jaeinCha/ECEN404-2025SP-TI-Solar-Battery-Pack/Slides/ECEN 404 Final Presentation.pdf

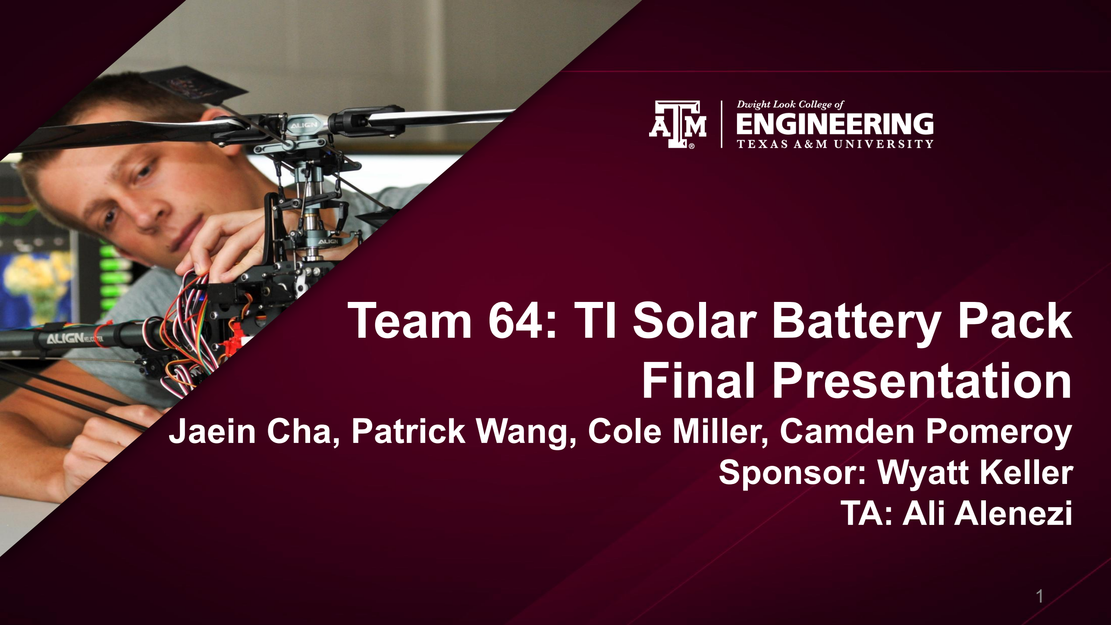
[picture p52: page 1]

# Team 64: TI Solar Battery Pack Final Presentation

### Jaein Cha, Patrick Wang, Cole Miller, Camden Pomeroy

### Sponsor: Wyatt Keller TA: Ali Alenezi

# Project Summary

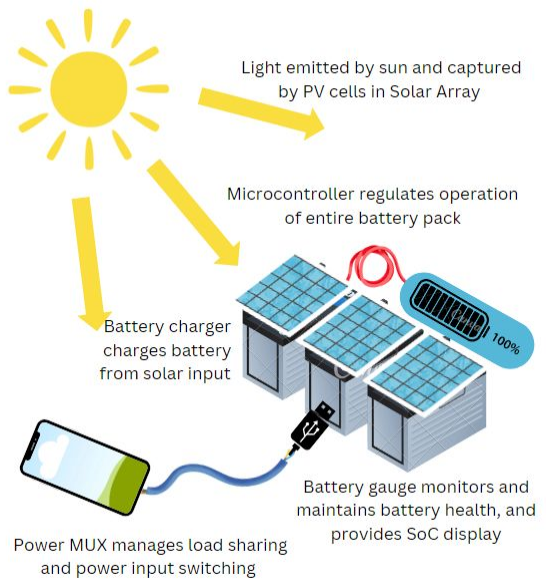
[picture p53: figure]

- Natural disasters, camping, or remote backpacking may result in a scenario with the inability to charge cell phones and other necessary small electronic devices.
- A solution is to create a solar powered battery pack that charges itself from solar panels, and distributes the power to electronic devices through a USB connection.

# Subsystem Overview

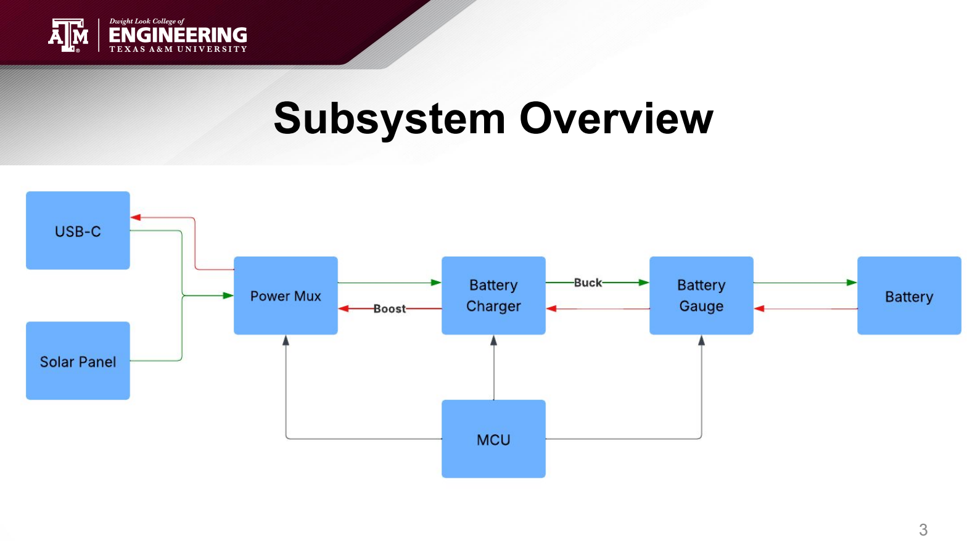
[picture p54: page 3]

# Integrated System Design

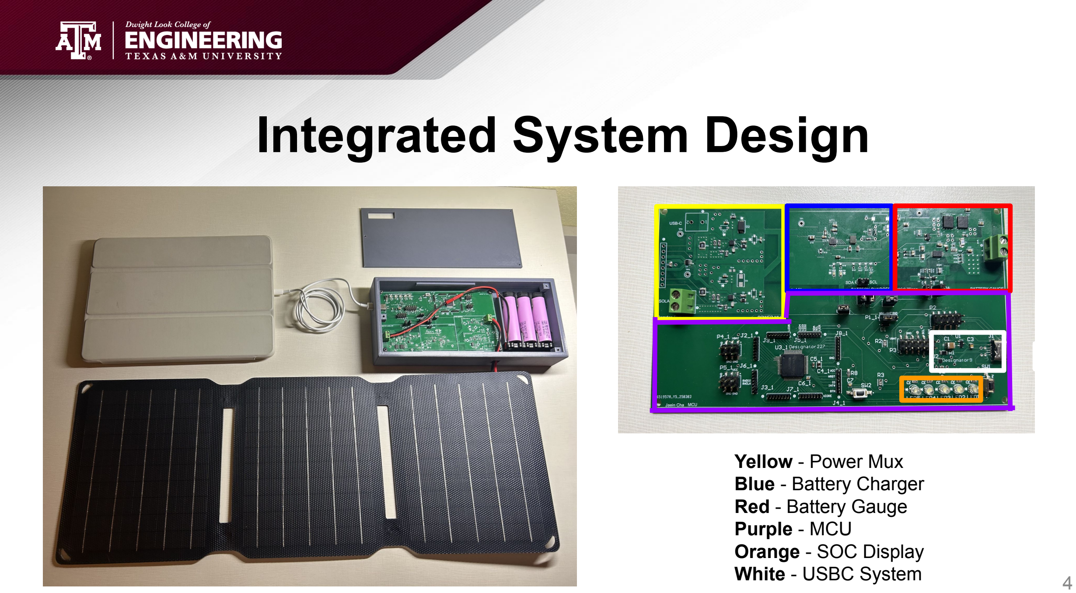
[picture p55: page 4]

4

Yellow - Power Mux
Blue - Battery Charger
Red - Battery Gauge
Purple - MCU
Orange - SOC Display
White - USBC System

# USB-C Input

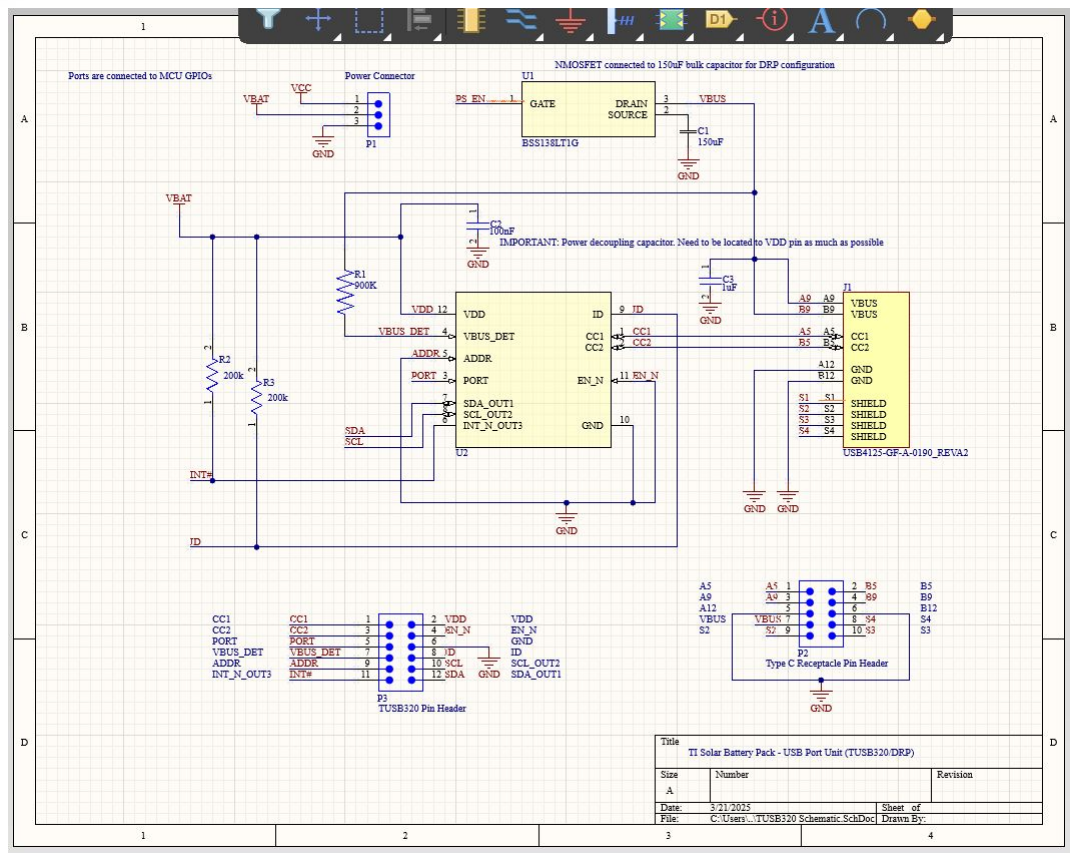
[picture p56: figure]

### - USB-C logic controlled by TUSB320

### - Configured as a DRP in I2C mode

### - Validated to source and sink devices and control VBUS

# USB-C Input

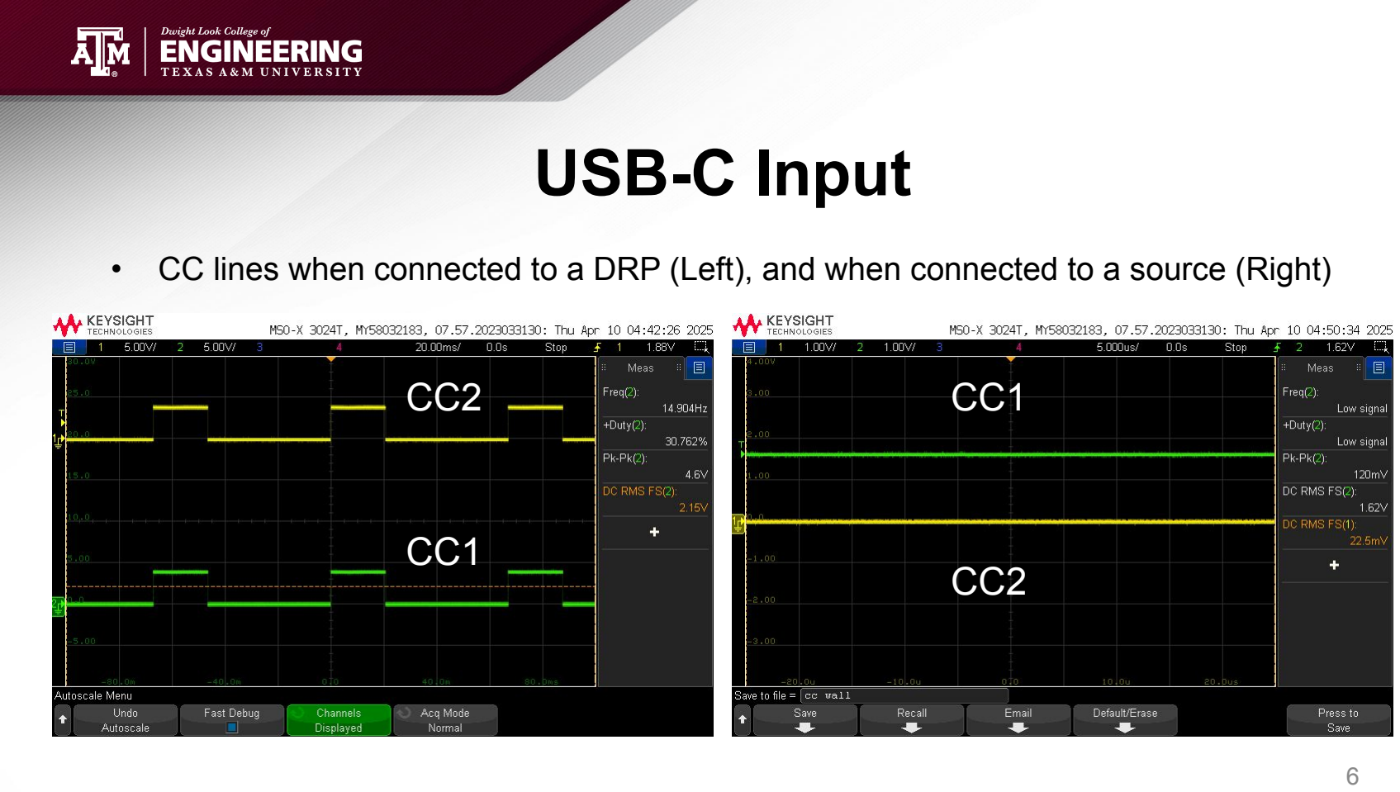
[picture p57: page 6]

- CC lines when connected to a DRP (Left), and when connected to a source (Right)

CC2

CC1

CC1

CC2

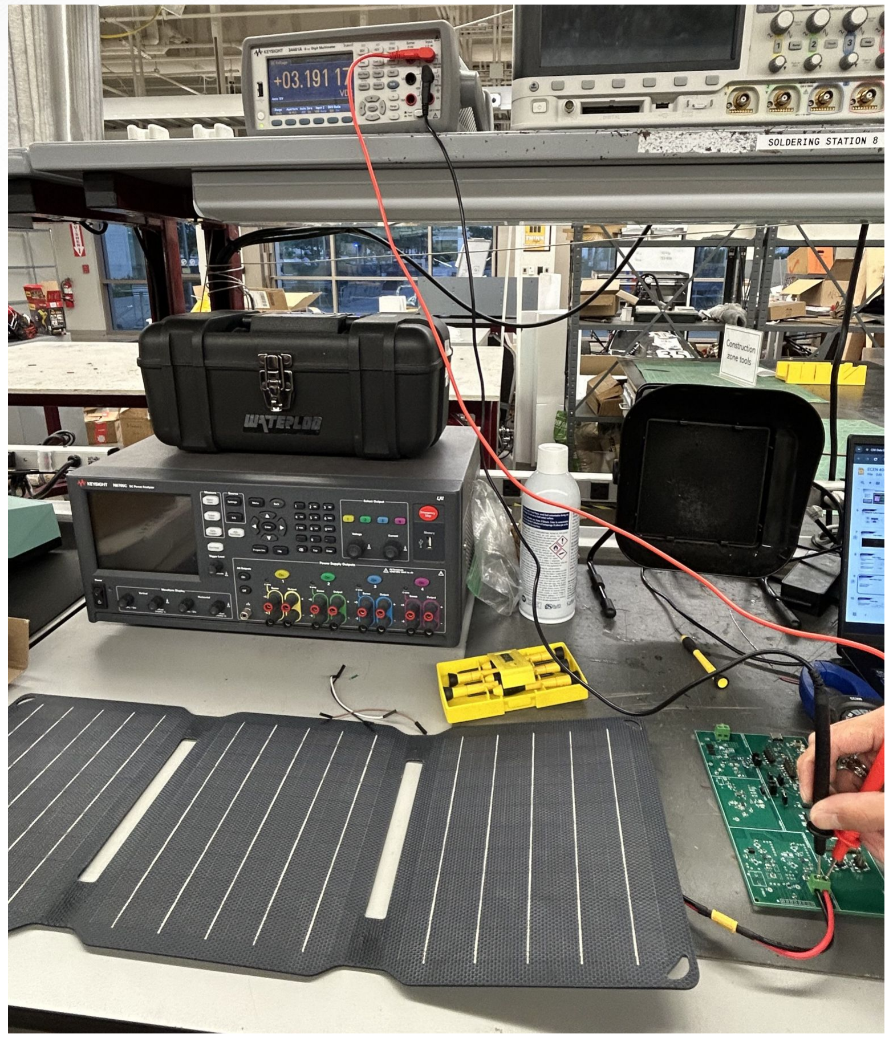
[picture p58: figure]

Solar Panel Input • 2.5V to 7.5V output at 15W

across three foldable
lightweight panels
- On a standard sunny day
charges at 7V 2A on
average
- Cloudy day 7V at 0.5A

# Power Mux - Camden Pomeroy

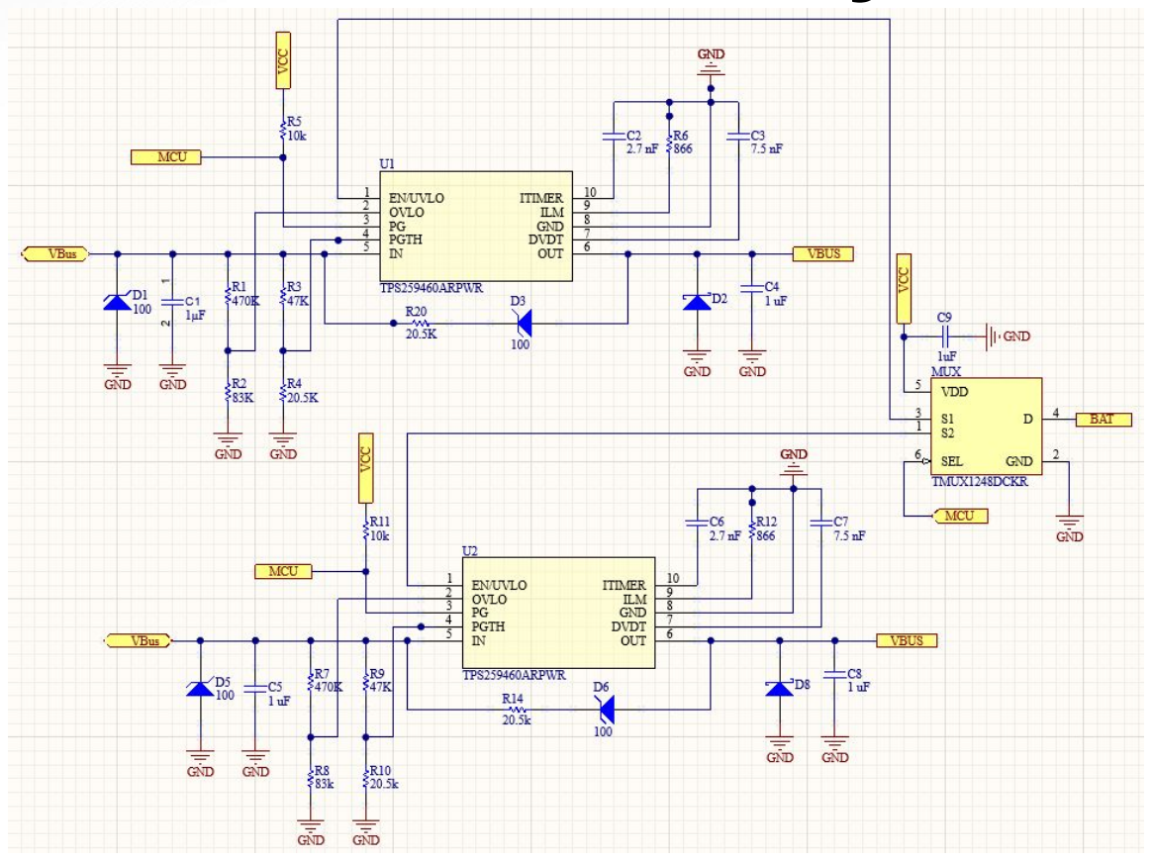
[picture p59: figure]

- Ensures protection of
system when both USB-C
and Solar inputs are
connected
- Utilizes break before make switching
- UV/OV Shutoff Protection with Auto Retry
- MCU reading good input
power detection and control over enabling power paths

- High heat from high current paths
– Created larger polygon pours and more stitching vias to boost efficiency
- Two loads would connect to VBUS at once sometimes
– Increased MUX capacitor and redesigned drain and VDD pins
- UV/OV would trigger during expected operation
– Gave a larger margin of error to account for MPPT of the solar panel on ideal and non-ideal days
- Powerflow only in one direction
– Redesigned schematic to bias the IN side of the eFuse which allowed for
Power to now flow from OUT to IN | 9

# Power Mux - Challenges and Solutions

# Power Mux

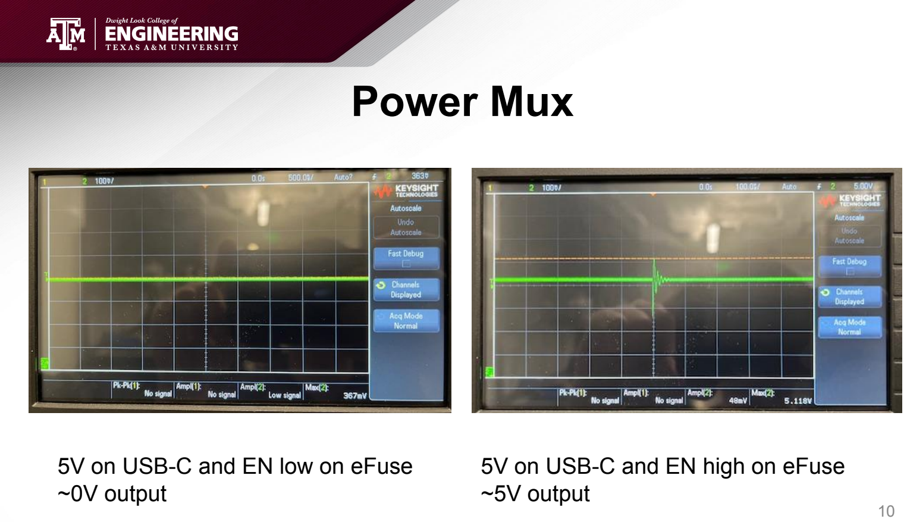
[picture p60: page 10]

5V on USB-C and EN high on eFuse ~5V output

5V on USB-C and EN low on eFuse ~0V output

# Battery Charger - Cole Miller

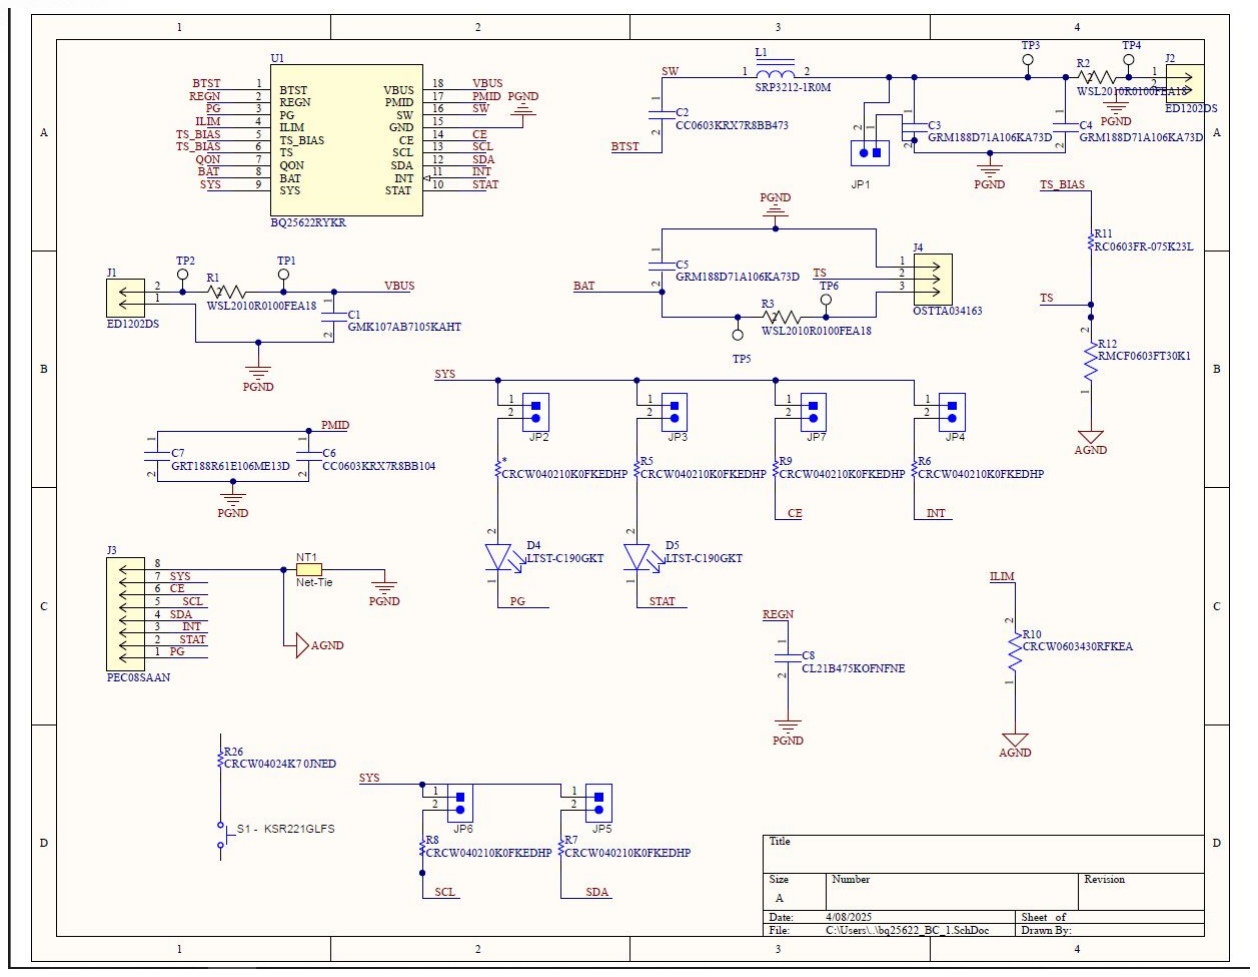
[picture p61: figure]

- Utilizes a BQ25622
- While charging battery
acts as a buck converter
- While charging Devices
acts as a boost converter
- Controls current and
voltage

# Battery Charger - Buck

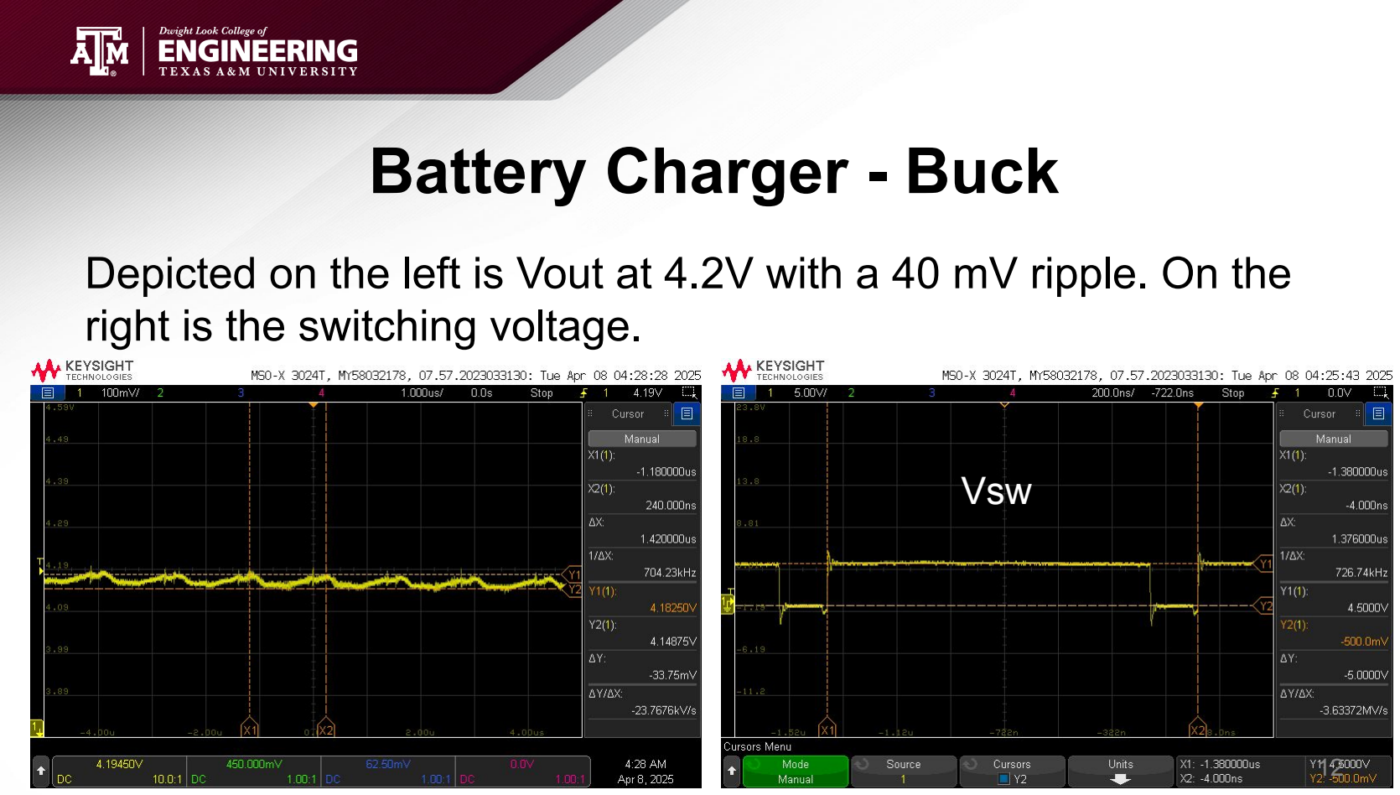
[picture p62: page 12]

### Depicted on the left is Vout at 4.2V with a 40 mV ripple. On the

right is the switching voltage.

Vout

Vsw

# Battery Charger - Boost

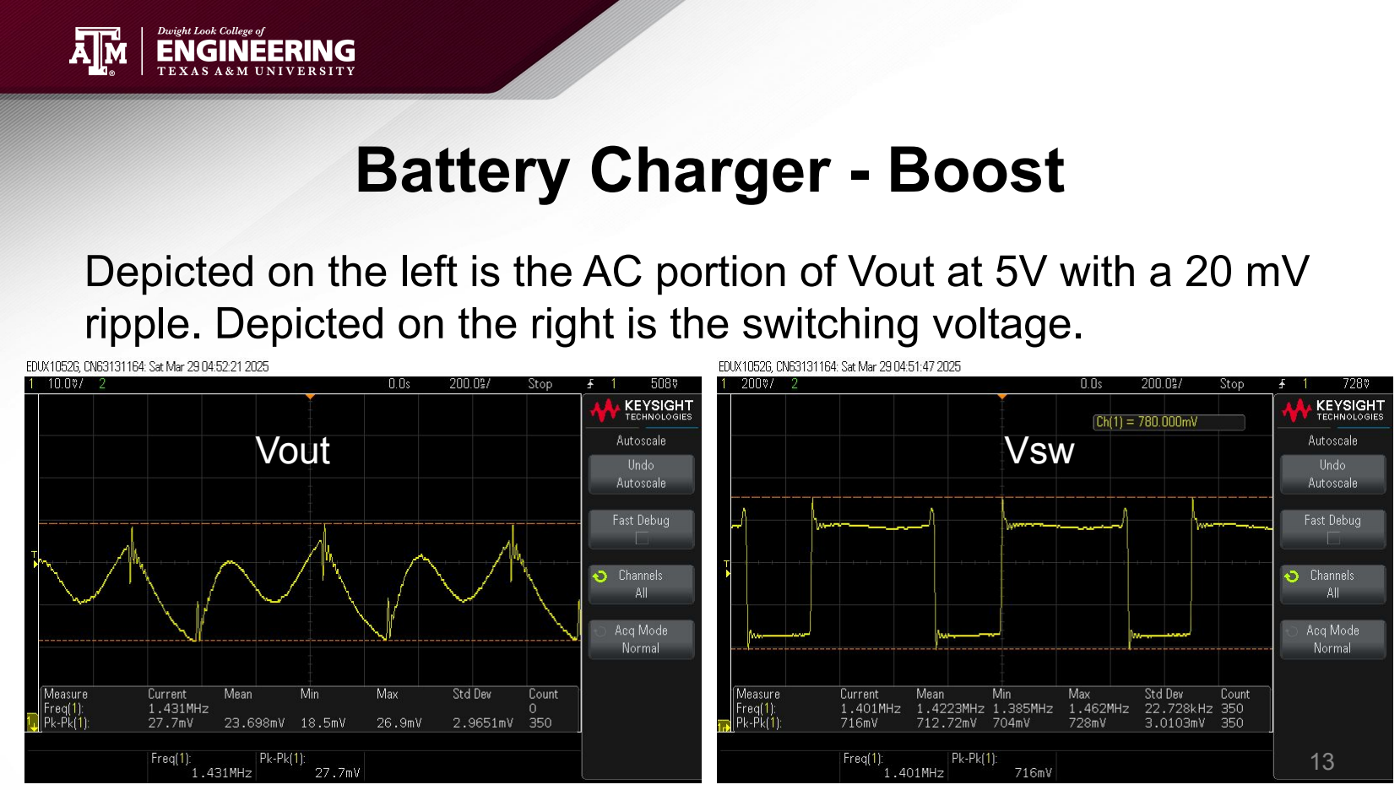
[picture p63: page 13]

### Depicted on the left is the AC portion of Vout at 5V with a 20 mV

ripple. Depicted on the right is the switching voltage.

Vout | Vsw

# Battery Charger - Efficiency

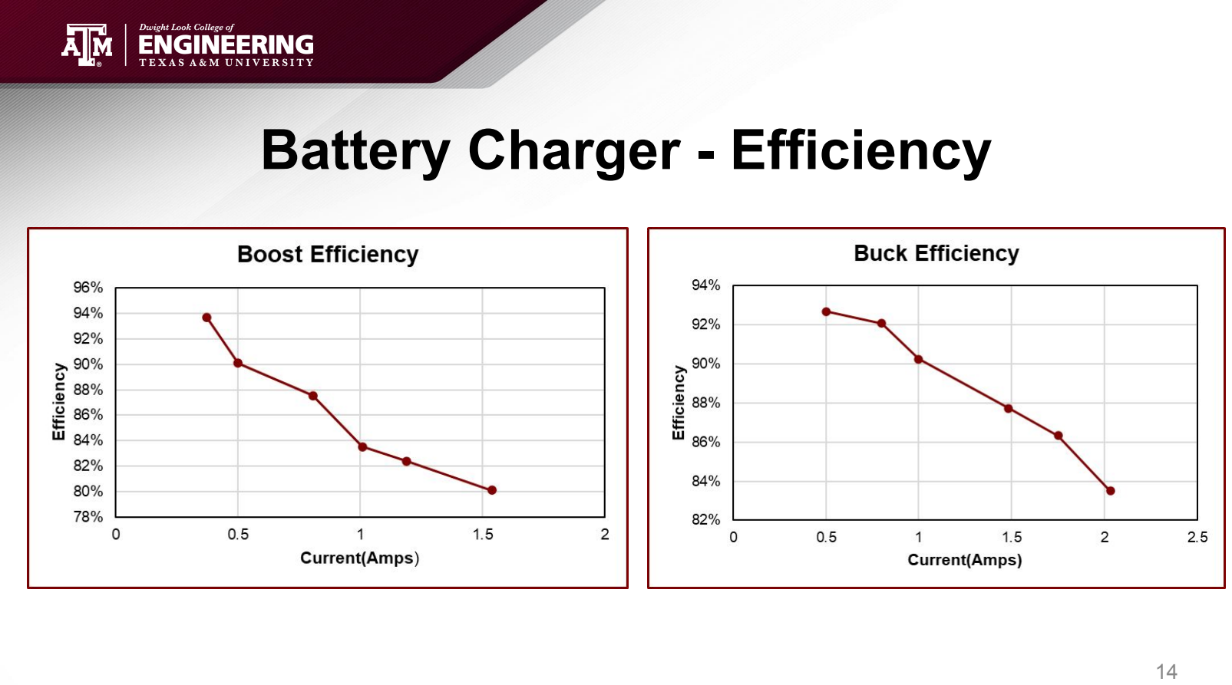
[picture p64: page 14]

- High heat from high current paths
– Created larger polygon pours and more stitching vias to boost efficiency
- Gate drivers wouldn’t allow full voltage
– Replaced ICs and changed soldering technique
- Lossy components due to ESR
– Utilized ceramic capacitors and low ESR inductors
- Lack of knowledge on DC - DC converters
– Utilized TI documents and forums to gain knowledge about package and operation

## Battery Charger - Challenges and Solutions

# Battery Gauge - Patrick Wang

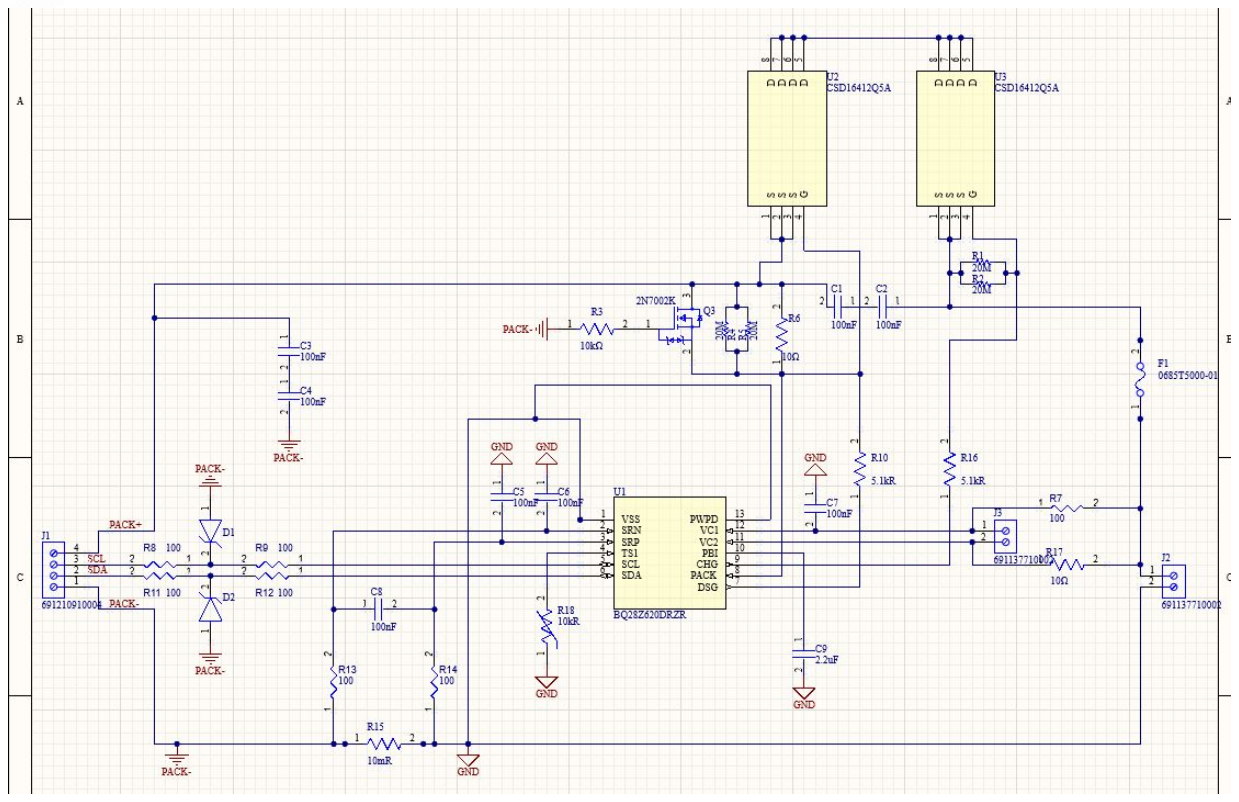
[picture p65: figure]

Overview
- Monitors voltage, current, temperature, and calculates state-of-charge (SOC) for Li-ion pack
- Configurable overvoltage (OV) and undervoltage (UV) thresholds to protect against faults
- Triggers fault flags (e.g., OV/UV, overcurrent) in registers
Challenges in 404
- Calibration of gauge to read proper charging parameters
- Extracting full charge cycle and discharge cycle data in one sitting

# Battery Gauge Operation

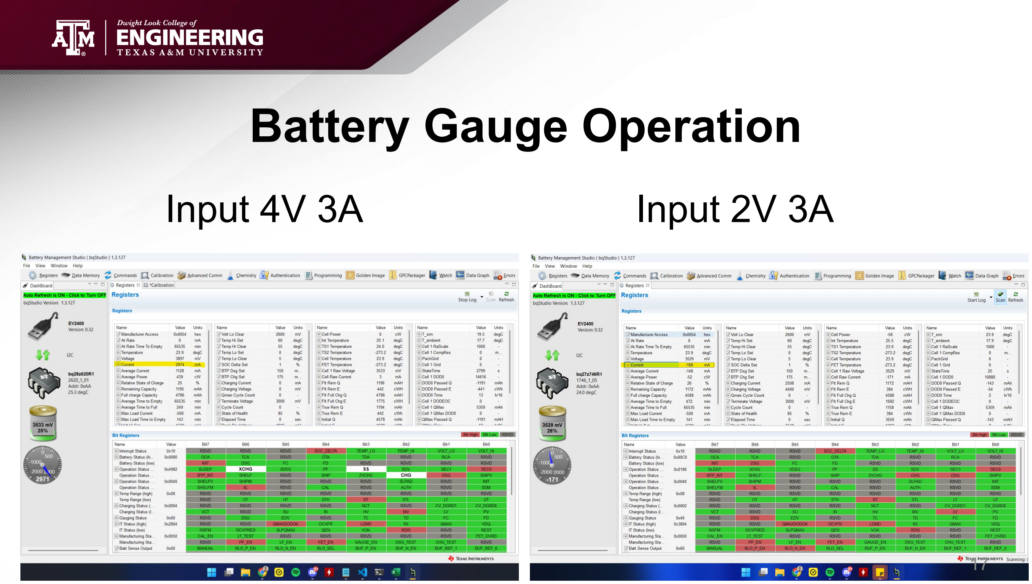
[picture p66: page 17]

Input 4V 3A | Input 2V 3A

# Battery Pack (charging)

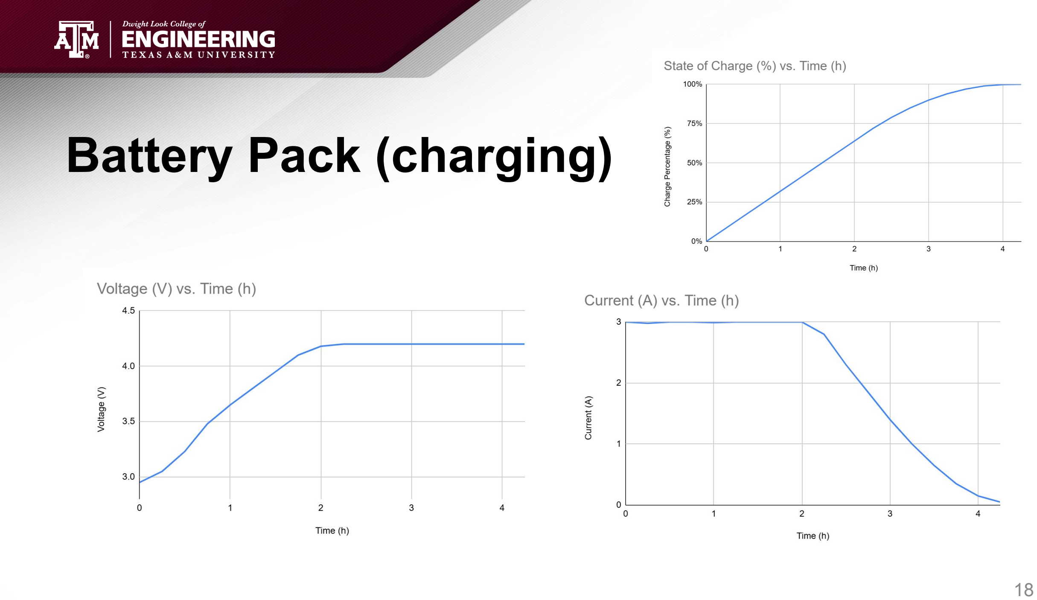
[picture p67: page 18]

## Battery Pack (discharging)

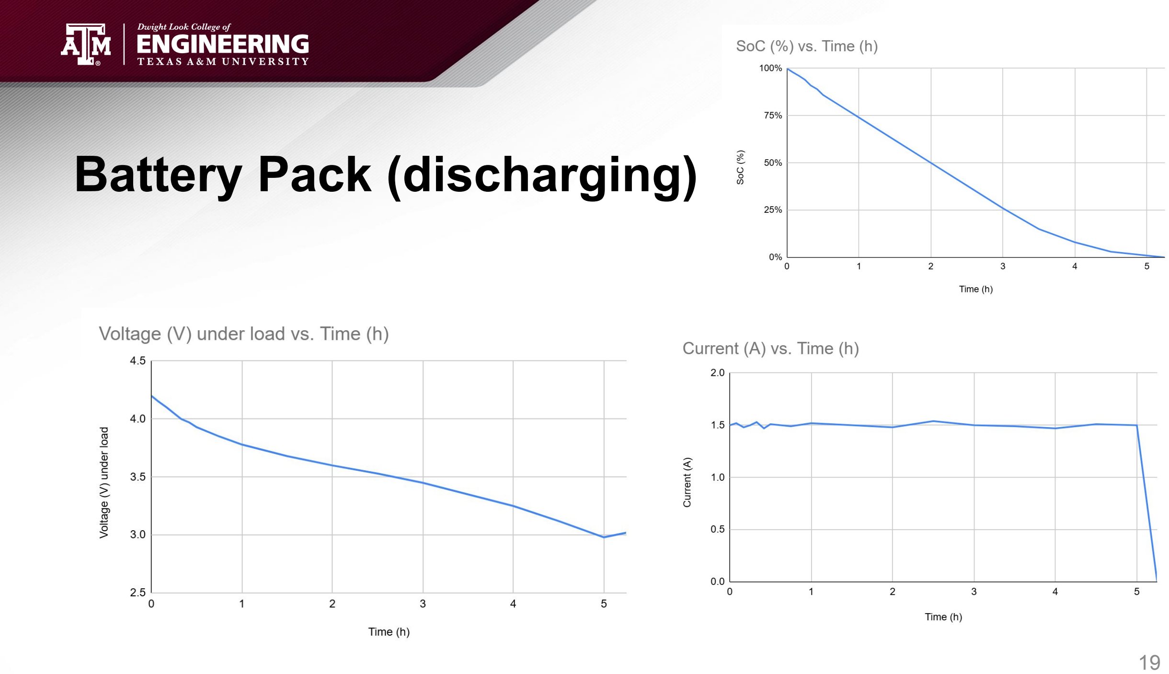
[picture p68: page 19]

# MCU - Jaein Cha

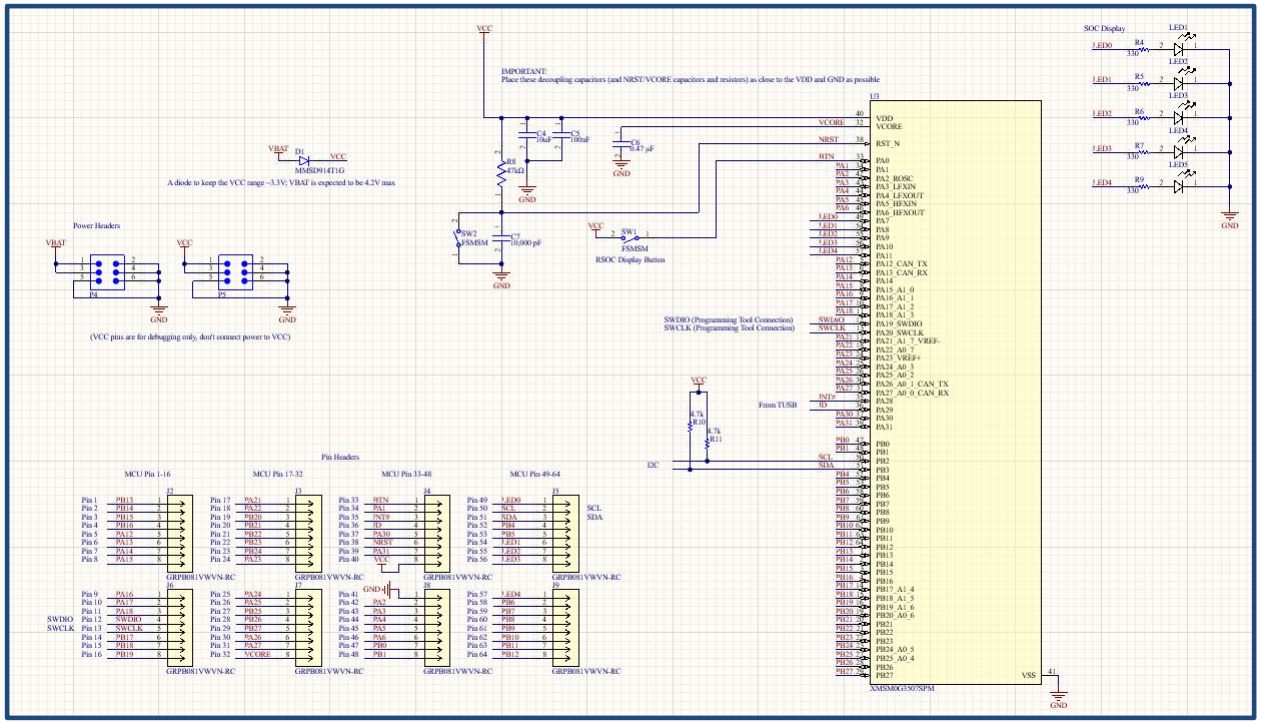
[picture p69: figure]

- Control unit -
integrates subsystems and firmware into one organized system
- MSPM0G3507 (LQFP 64 pin)
- I2C Communication Inter-Integrated Circuit
– Read/write register values for subsystem control
- MPPT Maximum Power Point Tracking
– To maximize power from
solar panel
- SOC display and SOC wake button

SOC: State of Charge

# MCU Firmware Flow Chart

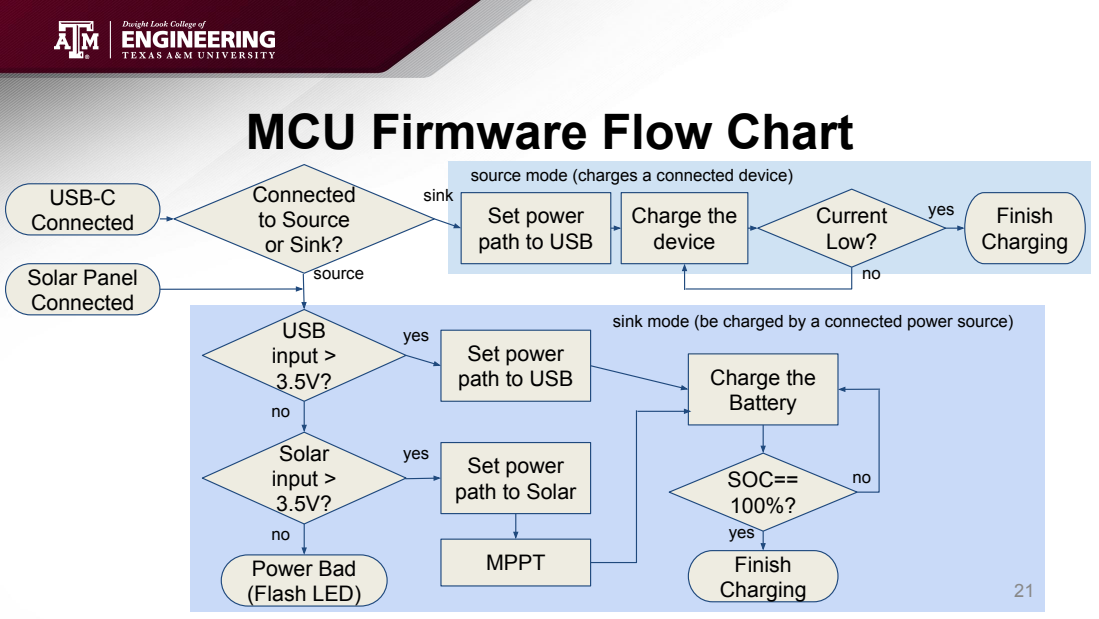
[picture p70: page 21]
USB-C Connected; Solar Panel Connected; Connected to Source or Sink?; Charge the device; source; USB input > 3.5V?; Solar input > 3.5V?; yes; Current Low?; Finish Charging; Set power; Power Bad (Flash LED); Charge the Battery; MPPT; SOC== 100%?

source mode (charges a connected device)
sink

Set power
path to USB

sink mode (be charged by a connected power source)

yes
path to Solar

# MCU Firmware Flow Chart

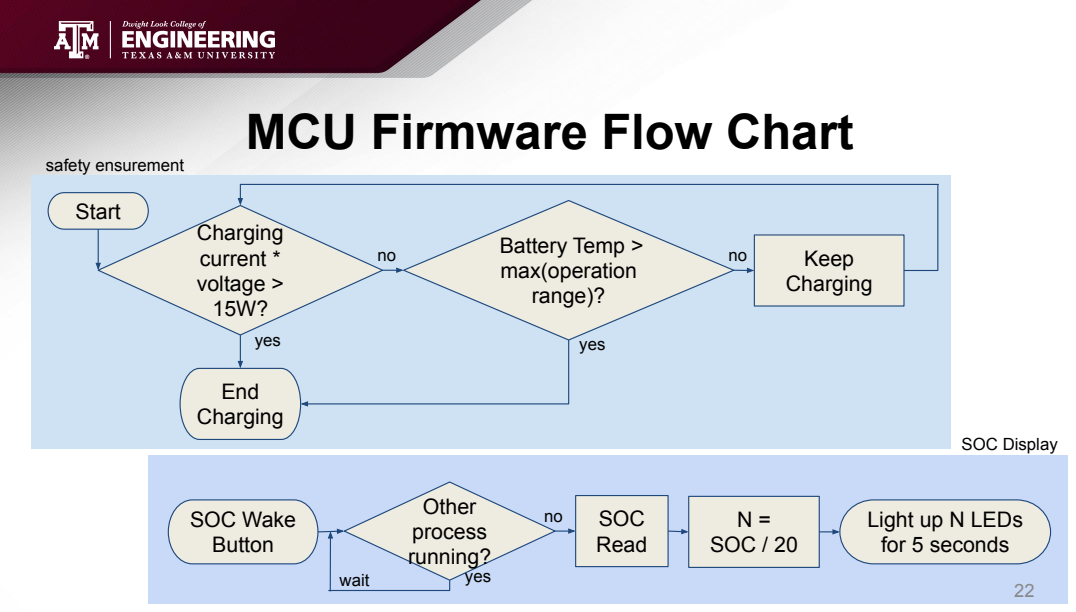
[picture p71: page 22]
Charging current * voltage > 15W?; safety ensurement; SOC Display; Battery Temp > max(operation range)?; End Charging; Keep Charging; yes; Other process running?; SOC Wake Button; SOC Read; N = SOC / 20; wait; Start

Light up N LEDs
for 5 seconds

- Inefficient process between firmware testing and on-board testing due to different package/pin configurations
– Changed on-board MCU package to match with the one on the launchpad
- Firmware consists of different functionalities
– Splitted firmware source code into various scripts, and assembled its functionality in the main.c file
- Complex to test due to its various functionalities
– Tested each functionality separately prior to the integrated testing, checking the lists of interrupts and their priorities

# MCU - Challenges and Solutions

# System Summary

Device | Charge Time
USB-C (5V 3A) | 2 hrs 45 min
Solar Sunny (7V 2A) | 3 hr
Solar Cloudy (7V 0.5A) | 10 hrs 30 min
Mode | Current | Discharge Time
USB 2.0 | 0.5 A | 16 hr 40 min
USB 3.0 / 3.1 | 0.9 A | 9 hr
USB BC 1.2 | 1.5 A | 5 hr 15 min
USB-C Default | 3 A | 2 hr 30 min
- Batteries will last 16450 hours or about 685 days when device is idle in sleep mode
System Operating Mode | Current Consumption
Normal | 1.2795 mA
Sleep | 547.1 μA
Off | 2.1 μA

# System Summary

Device | Battery Capacity (mAh) | Amount of Full Charges
iPhone 13/14/15 | ~ 3300 | 2.2
Google Pixel 5/6/7 | ~ 4335 | 1.65
Samsung Galaxy S23 | ~ 5124 | 1.85
AirPods Pro | ~ 520 | 13.85
Nintendo Switch | ~ 4310 | 1.67
Portable Fan / USB Light | ~ 1200 | 6
GoPro Hero 10/11/12 | ~ 1720 | 4.2

# Changes Since 403

- Integrated all individual subsystems together into one board
- Integrated new usb subsystem for input/output charging
- Changed MCU Package from VSSOP (28 Pin) to LQFP (64 Pin)
- Modified layout for battery gauge to reduce size

# System Validation Plan

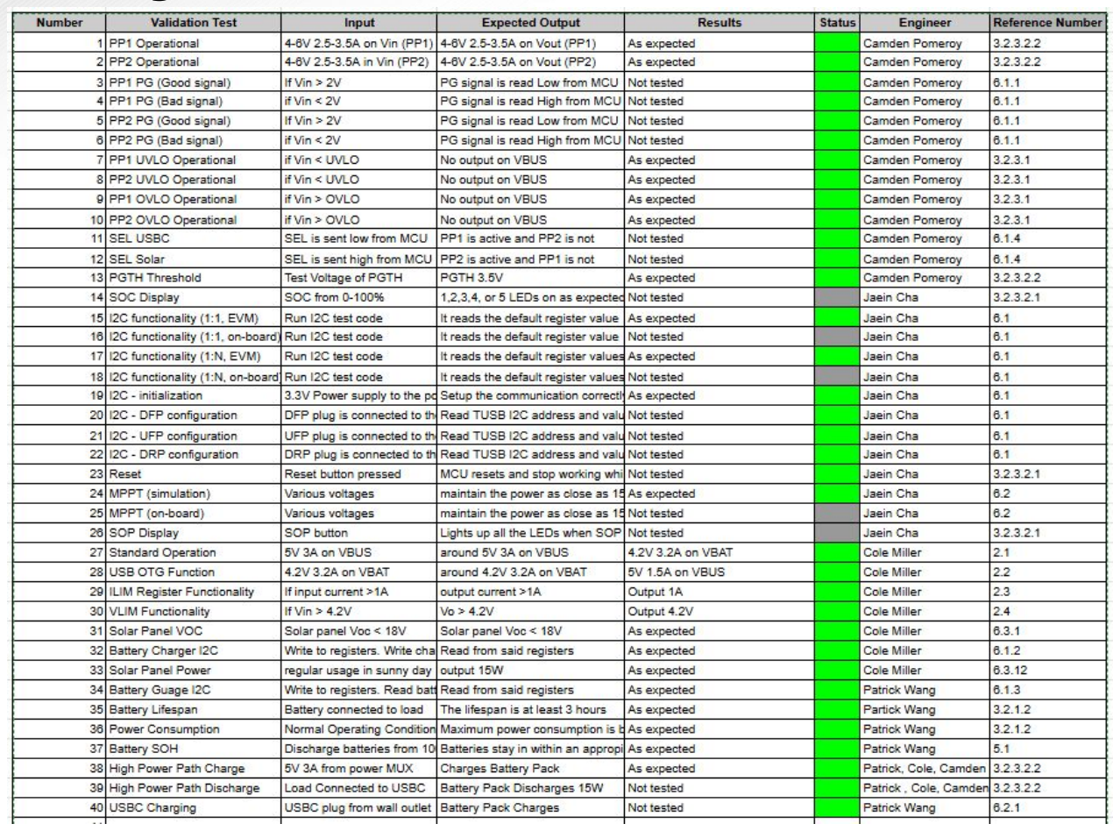
[picture p72: figure]

# Questions?
