jaeinCha/ECEN404-2025SP-TI-Solar-Battery-Pack/Slides/ECEN 404 Presentation 1.pdf

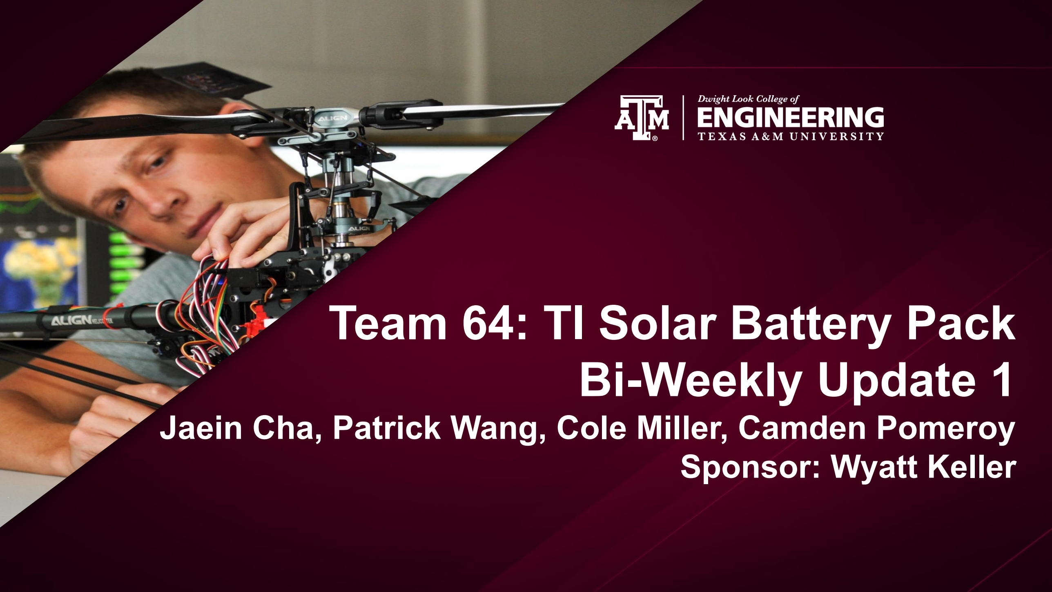
[picture p73: page 1]

# Team 64: TI Solar Battery Pack Bi-Weekly Update 1

## Jaein Cha, Patrick Wang, Cole Miller, Camden Pomeroy

## Sponsor: Wyatt Keller

# Project Summary

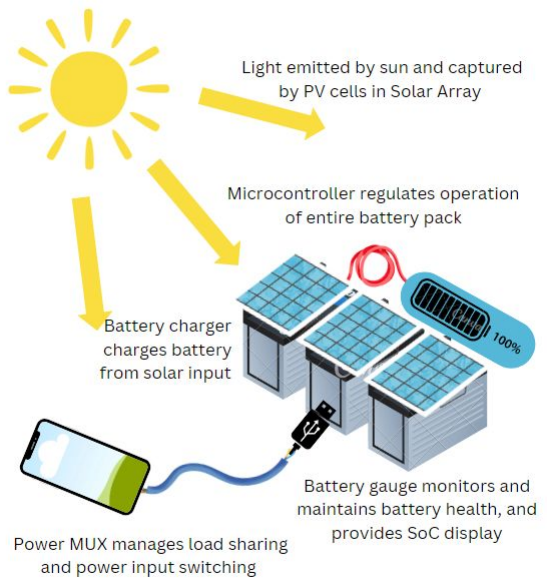
[picture p74: figure]

# - Natural disasters can cause unexpected power outages resulting in the inability to charge cell phones and other necessary small electronic

devices.

# - A solution is to create a solar powered battery pack that charges itself from solar panels, and distributes the power to electronic devices through a USB

connection.

# Project/Subsystem Overview

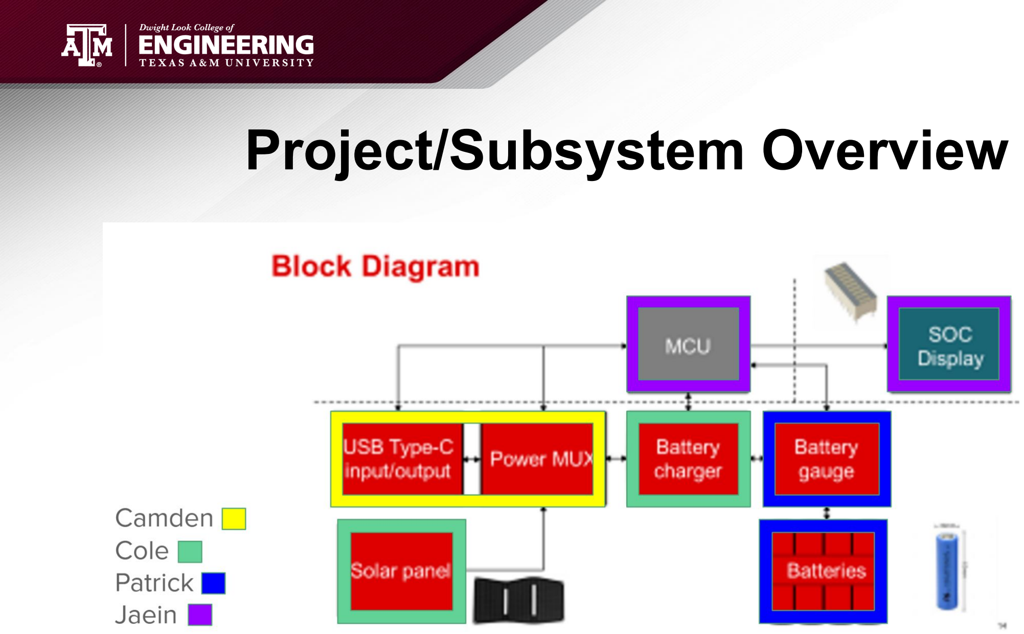
[picture p75: page 3]

## Diagram showing subsystems – with labels showing subsystem owners

## Bullets giving essential system/subsystem characteristics

## If major changes in subsystems, show before and after … see next slide

# Project Timeline

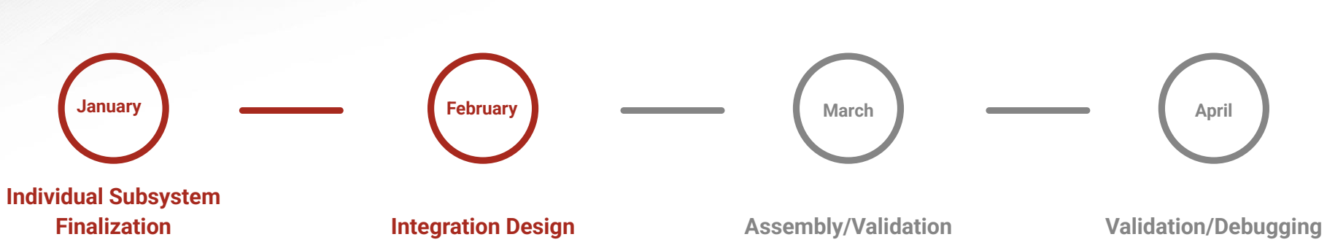
[picture p76: figure]
Integration Design; February; Assembly/Validation; March; Validation/Debugging; April; Individual Subsystem Finalization; January

Work together to integrate the designs of each subsystem

Assemble the final pcb and 3D printed enclosure. Perform validation testing and identify problems that occur

Engineer a solution to problems that arise as a result of
integration

Wrap up subsystem design and validation testing

# Battery Gauge / Battery Pack

### Patrick Wang

Accomplishments since 403 15 hrs | Ongoing progress/problems and plans until the next presentation
- Ordered new 1s3p battery pack for the batteries ● Ordered new pcb with more pins for battery pack connections | ● Turned FETs on, board sparked and I2C connection stopped ● Solder new board with IC and new parts and finish up last validation test

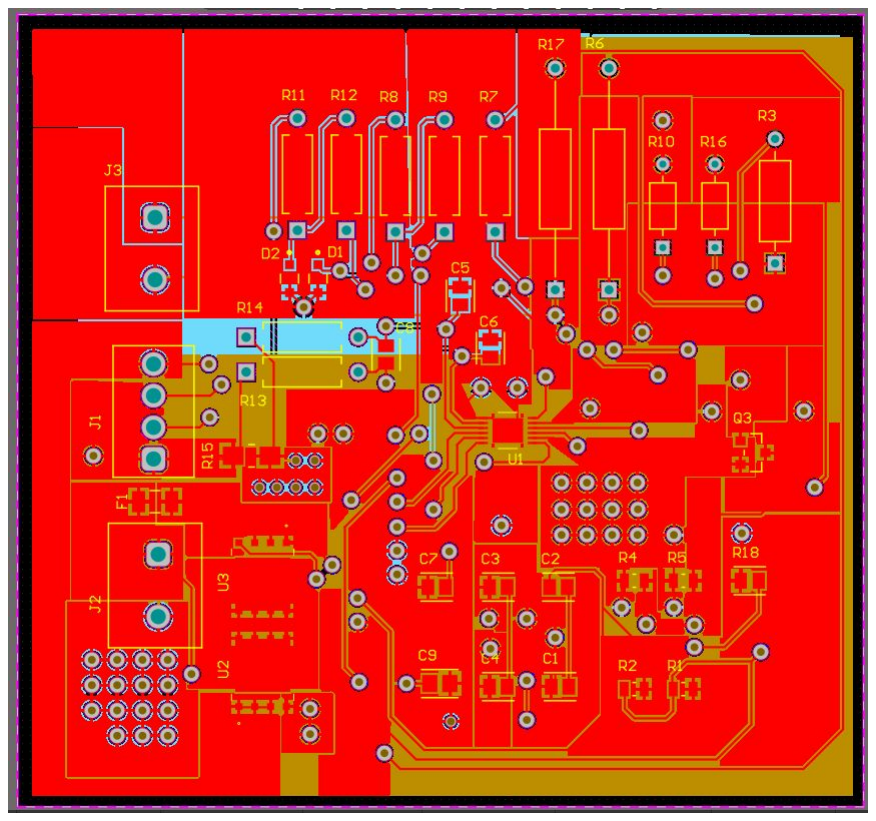
[picture p77: figure]

What works:
- Board allows in-threshold input and output voltage through to charge battery pack
- Current throughput also correct

What doesn’t work:
- Board stopped communicating with I2C interface, may be something wrong with SCL and SDA pins
- Will solder new board to fix issue

# Battery Gauge / Battery Pack

### Patrick Wang

# Battery Charger/Solar Panel

### Cole Miller

Accomplishments since 403 15 hrs of effort | Ongoing progress/problems and plans until the next presentation
– Troubleshot digital pins – Added Reset function and net tie – Ordered new board – Hardwired board to rely on own voltage | – Assemble new board – Finish validation – Update net names

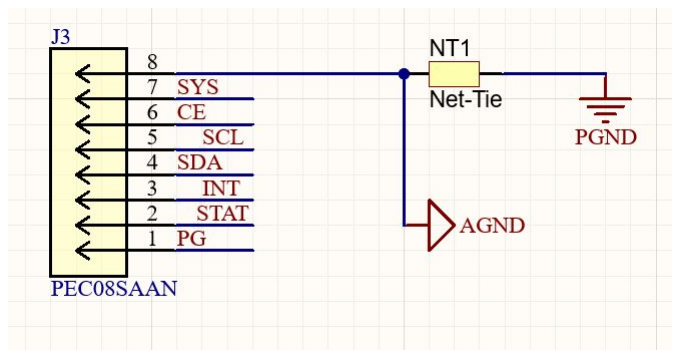
[picture p78: figure]
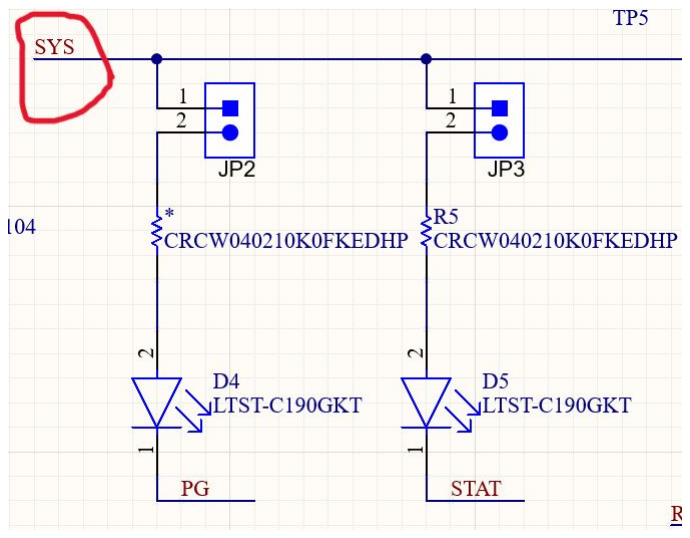
[picture p79: figure]

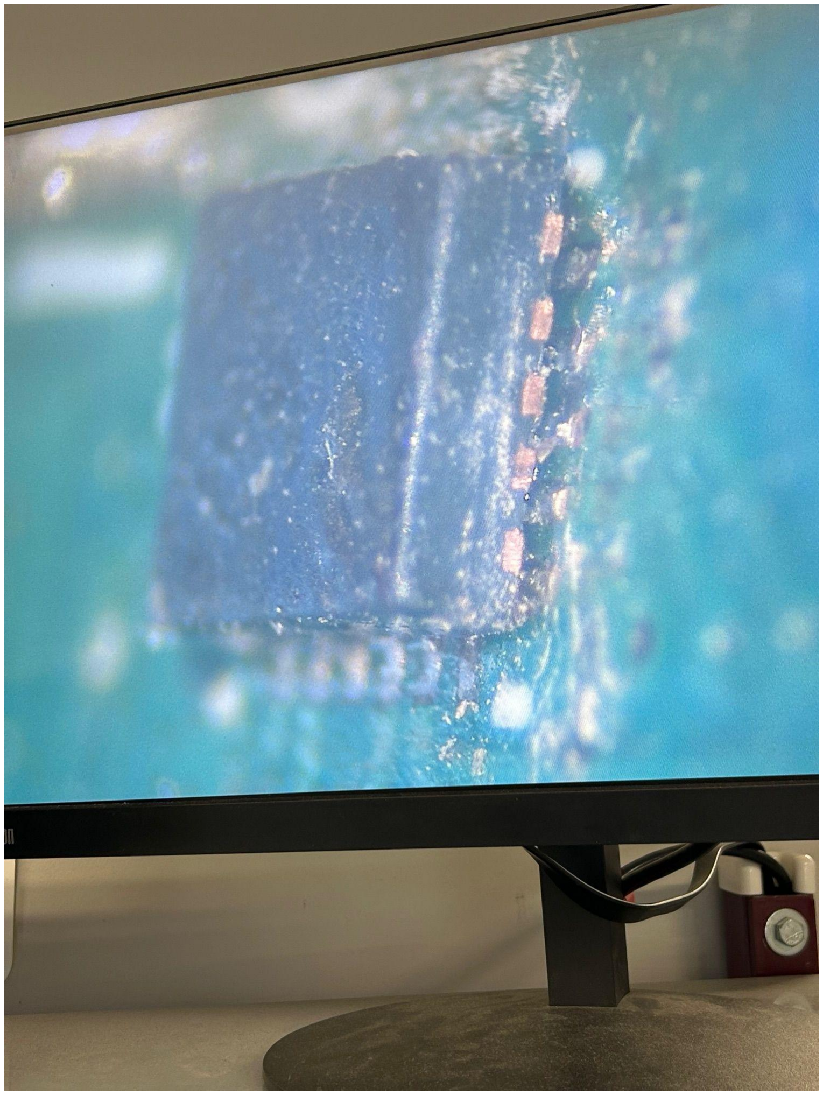
[picture p80: figure]

## What works: - Buck converter successfully switches voltages - Validated all other pins as operational - Solar panel works and meets specs What doesn’t work: - Cannot operate digital Pins - Cannot communicate with EVM – Weak connection as shown

# Battery Charger/Solar Panel

### Cole Miller

# Power MUX

### Camden Pomeroy

Accomplishments since 403 15 hrs of effort | Ongoing progress/problems and plans until the next presentation
Redesigned PCB layout Ordered new PCB Ordered new components | Assemble/Validate new PCB Work towards initial integration

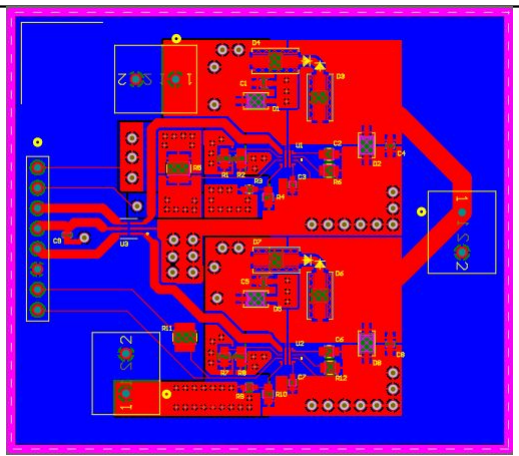
[picture p81: figure]
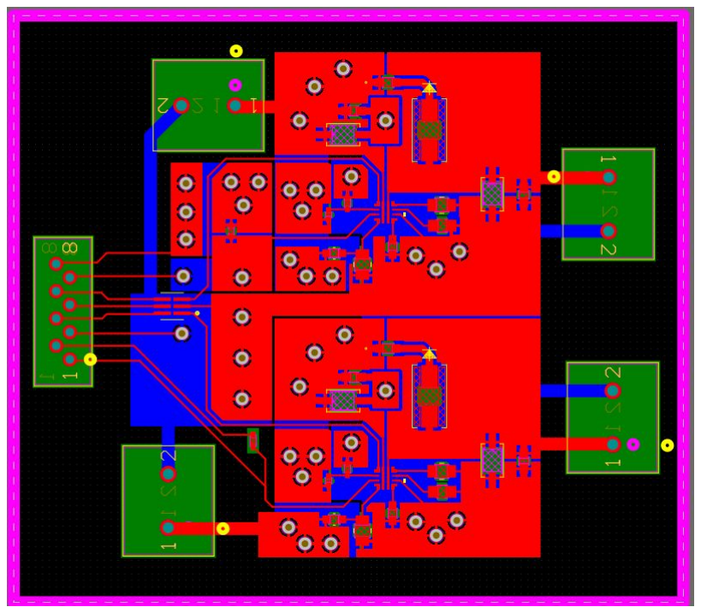
[picture p82: figure]

# Power MUX

### Camden Pomeroy

What works:
- Input Voltage = Output Voltage
- UVLO/OVLO Operates as
expected
- EN pin opens and shuts off properly
What doesn’t work:
- TMUX not fully validated
- Two VBUS paths
- Could not draw current on previous board

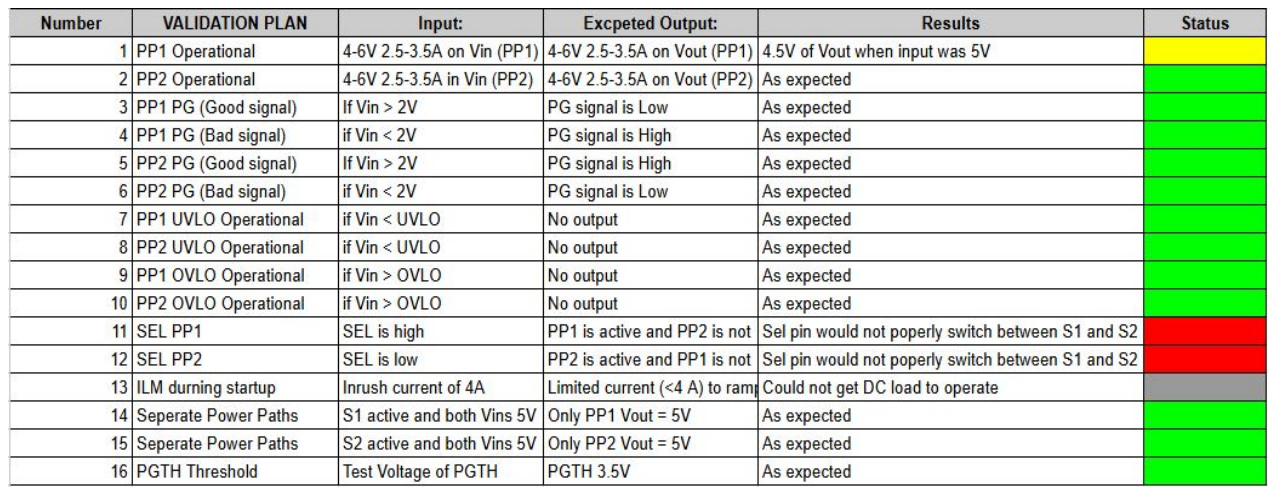
[picture p83: figure]

# Microcontroller Unit

### Jaein Cha

Accomplishments since 403 15 hrs of effort | Ongoing progress/problems and plans until the next presentation
– Verified problems with the PCB – Resoldered MCU – Updated PCB design – Verification of updated design with the sponsor | – Order updated PCB & parts – New PCB assembly – Validate the new PCB – Verify I2C functionality with other subsystem boards

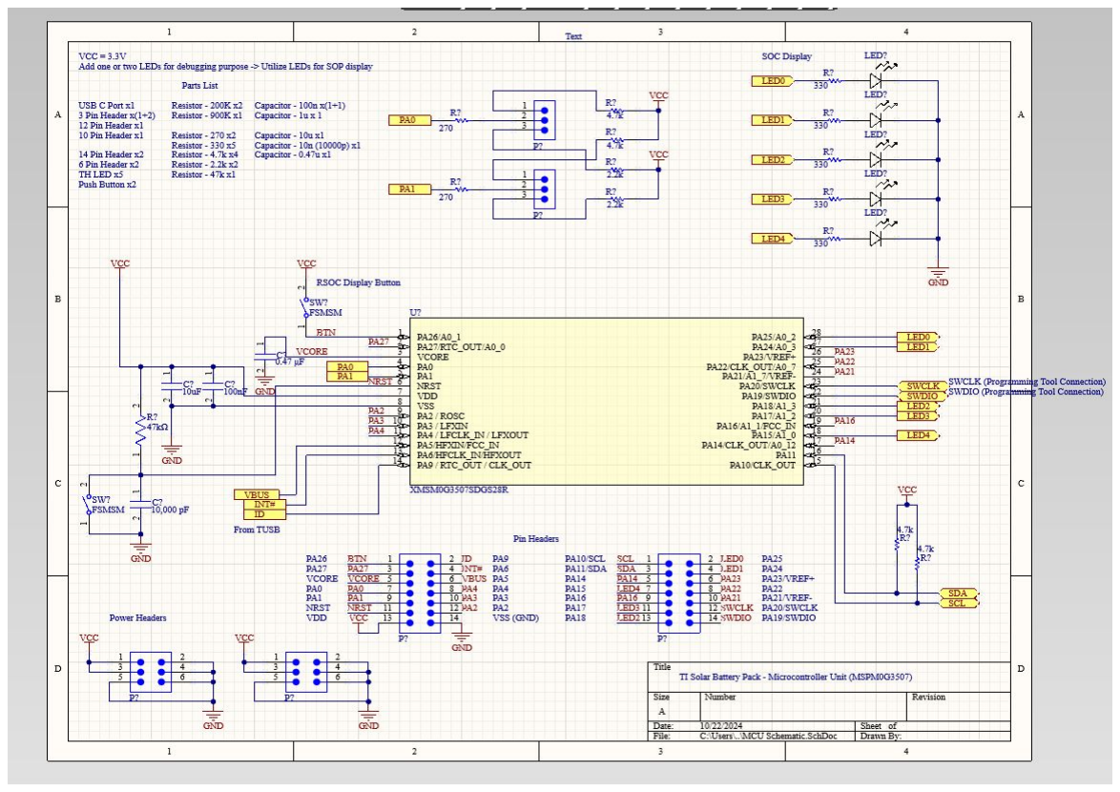
[picture p84: figure]

## What works:

### - I2C firmware between the MCU and the battery gauge EVM - Input (button) and output (LEDs) on the board when connected to the launchpad

## What doesn’t work:

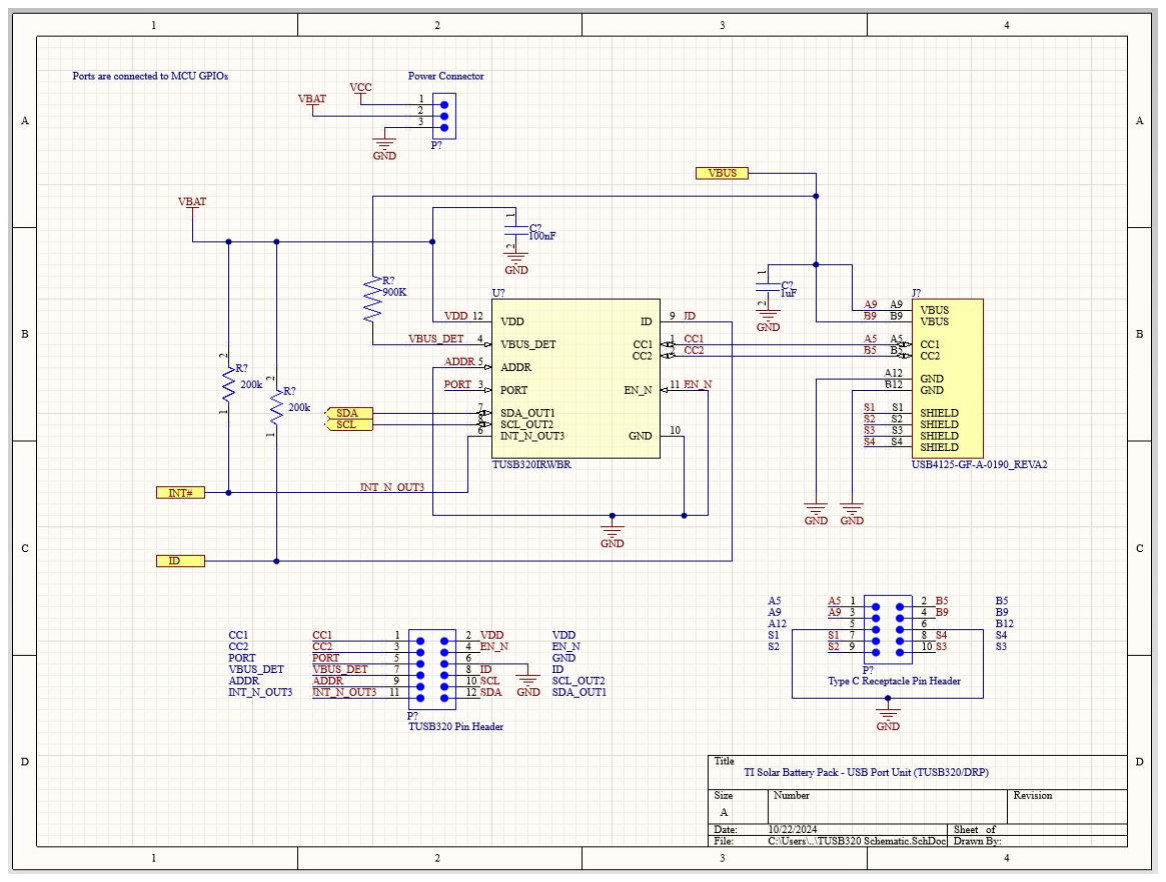
[picture p85: figure]

### - MCU is not connected to the pads properly - not responsive

## What is changing:

- Adjustment on the power trace (VBUS net) - width,

### add connector - Size of the board - reducing the size

# Microcontroller Unit

### Jaein Cha

# Parts Ordering Status

## - Ordered new PCBs for ■ Battery Charger ■ Battery Gauge ■ Power MUX - Ordered new 1s3p battery pack holder - Ordered various assembly components for each subsystem

# Execution & Plan

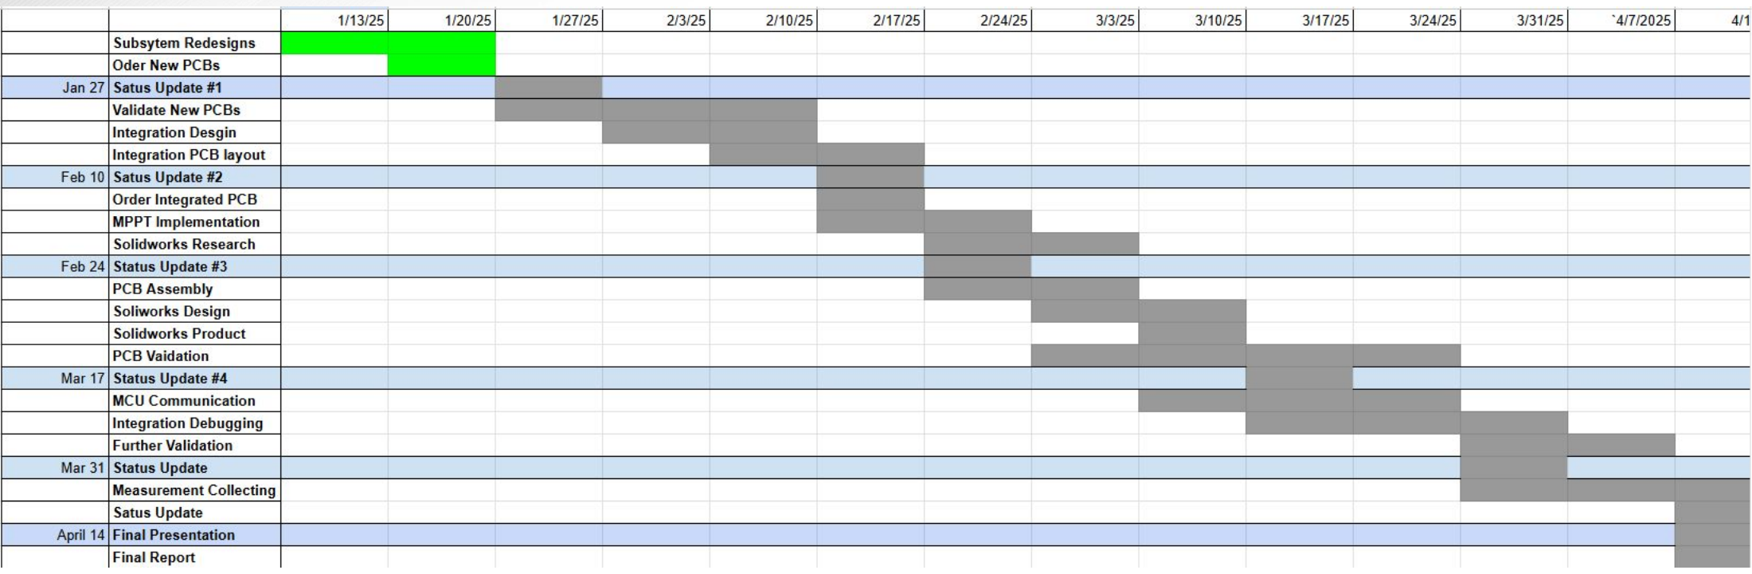
[picture p86: figure]

# Questions?
