jaeinCha/ECEN404-2025SP-TI-Solar-Battery-Pack/Slides/ECEN 404 Presentation 2.pdf

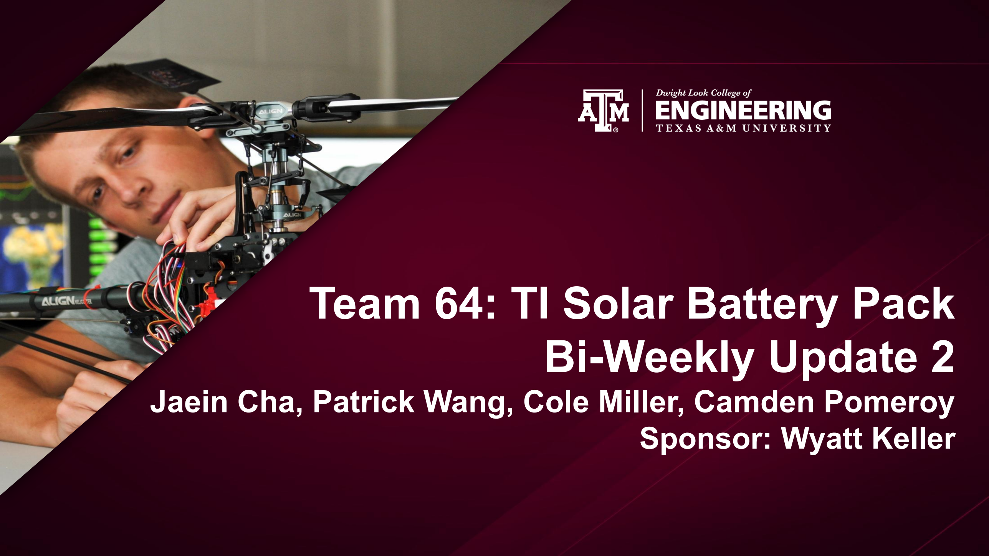
[picture p87: page 1]

# Team 64: TI Solar Battery Pack Bi-Weekly Update 2

## Jaein Cha, Patrick Wang, Cole Miller, Camden Pomeroy

## Sponsor: Wyatt Keller

# Project Summary


# - Natural disasters can cause unexpected power outages resulting in the inability to charge cell phones and other necessary small electronic

devices.

# - A solution is to create a solar powered battery pack that charges itself from solar panels, and distributes the power to electronic devices through a USB

connection.

# Project/Subsystem Overview


## Diagram showing subsystems – with labels showing subsystem owners

## Bullets giving essential system/subsystem characteristics

## If major changes in subsystems, show before and after … see next slide

# Project Timeline

Integration Design; February; Assembly/Validation; March; Validation/Debugging; April; Individual Subsystem Finalization; January

Work together to integrate the designs of each subsystem

Assemble the final pcb and 3D printed enclosure. Perform validation testing and identify problems that occur

Engineer a solution to problems that arise as a result of
integration

Wrap up subsystem design and validation testing

# Battery Gauge / Battery Pack

Patrick Wang

Accomplishments since last presentation 21 hrs | Ongoing progress/problems and plans until the next presentation
- Soldered new board, I2C communication works between board and bqStudio ● Programmed IC calibration to read specific parameters for the INR18650 30Q batteries we are using | ● Currently trying to turn on FETs to enable power path for charging ● Start integrating with charger subsystem

# Battery Gauge / Battery Pack

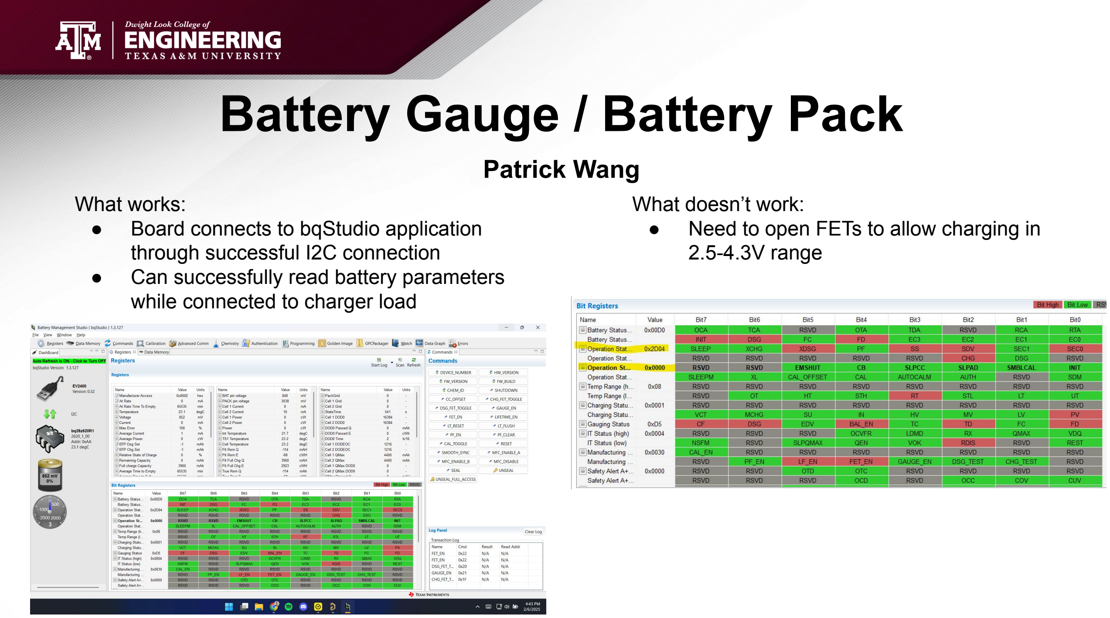
[picture p88: page 6]

What doesn’t work:
- Need to open FETs to allow charging in 2.5-4.3V range

Patrick Wang

What works:
- Board connects to bqStudio application through successful I2C connection
- Can successfully read battery parameters while connected to charger load

# Battery Charger/Solar Panel

Cole Miller

Accomplishments since last presentation 27 hrs of effort | Ongoing progress/problems and plans until the next presentation
– Completed assembly of new board – Validated board and met specs – Begun integration test with Camden’s board | – Assemble a list of registers for Jaein – Remove old USB connector from solar panel – Integrate to Patrick’s and Camden’s board

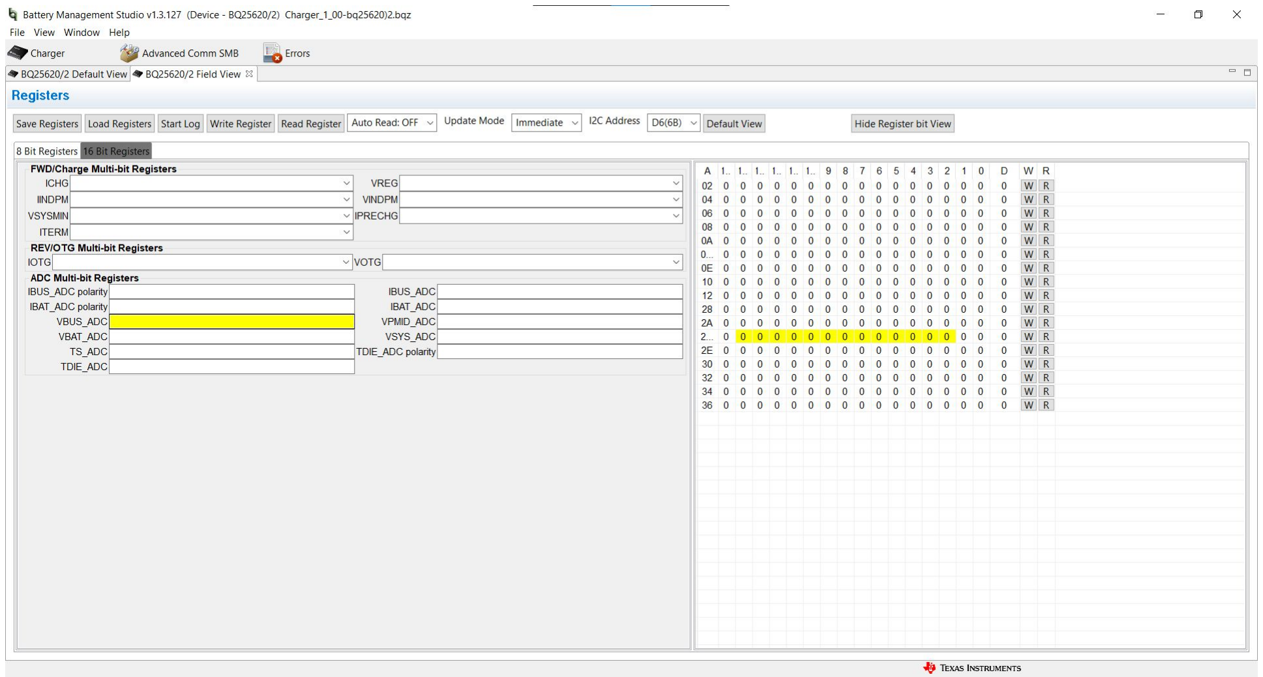
[picture p89: figure]
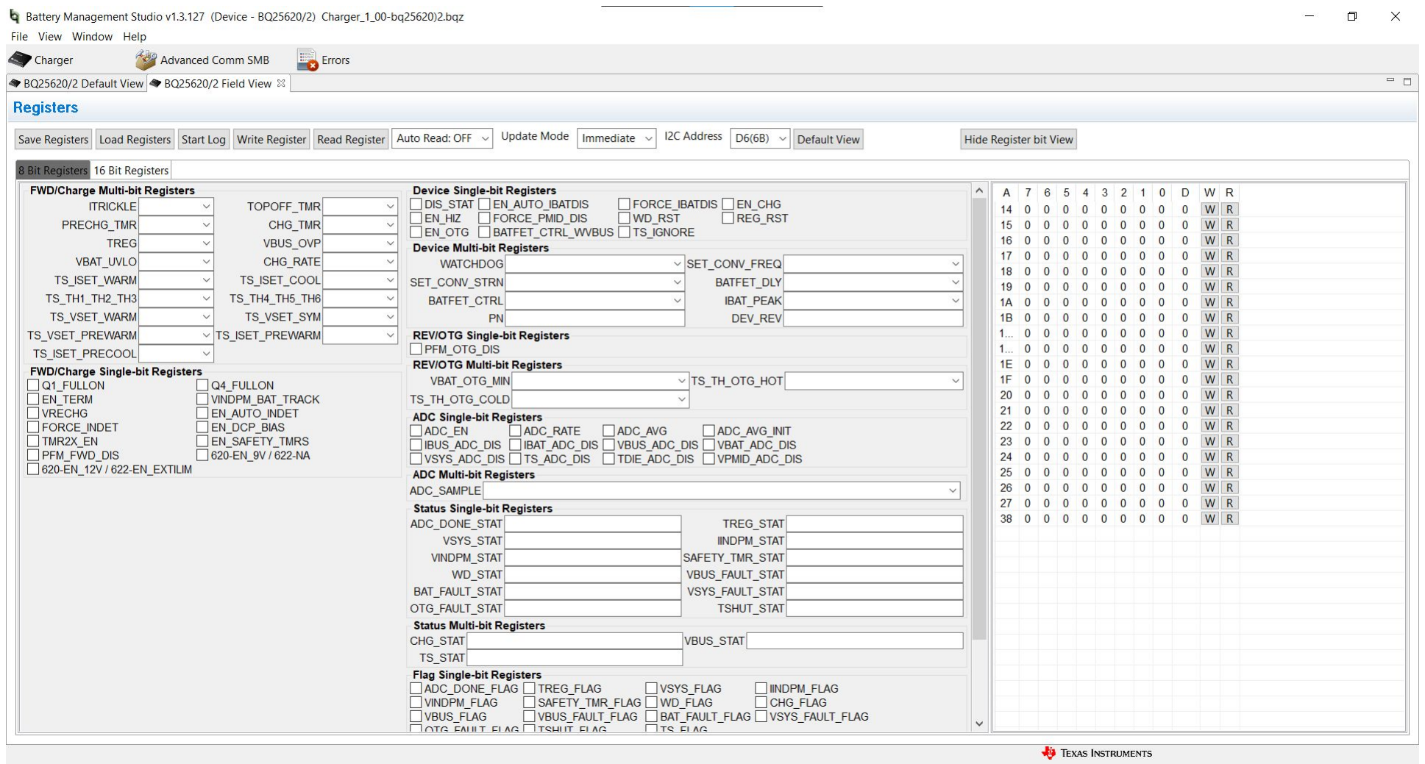
[picture p90: figure]

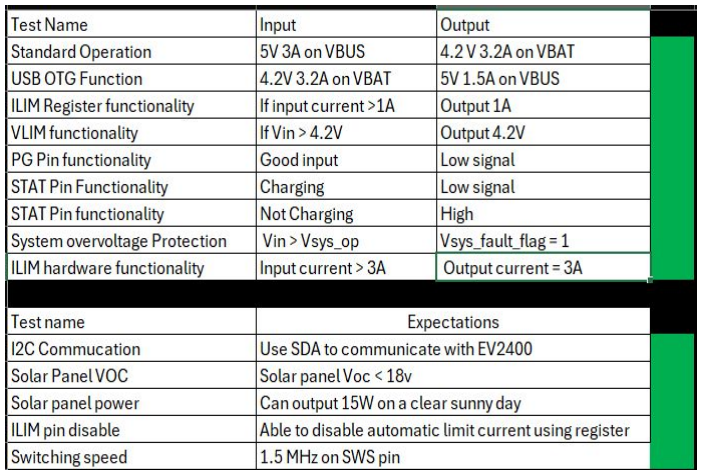
[picture p91: figure]

What Works
- Able to communicate with MCU
- Able to limit current and voltage
- Can work in boost mode
- ADC functionality works
- Able to integrate with Camden’s board
- Meets 90% efficiency standard

# Battery Charger/Solar Panel Validation

Cole Miller

# Power MUX

Camden Pomeroy

Accomplishments since last presentation 30 hrs of effort

Ongoing progress/problems and plans until the next presentation
- Assembled new PCB board
- Debugged and blue wired a solution to subsystem
- Fully validated new PCB board
- Started integration testing two different PCB boards
- Further integration testing with physical PCB boards
- Integrated PCB layout design
- Research Solidworks software and design for battery pack casing

# Power MUX Validation

Camden Pomeroy

What works:
- Input Voltage = Output
Voltage
- UVLO/OVLO Operates as
expected
- EN pin opens and shuts off properly
- TMUX fully validated
- Correct VBUS design
- Current draw does not
overheat board

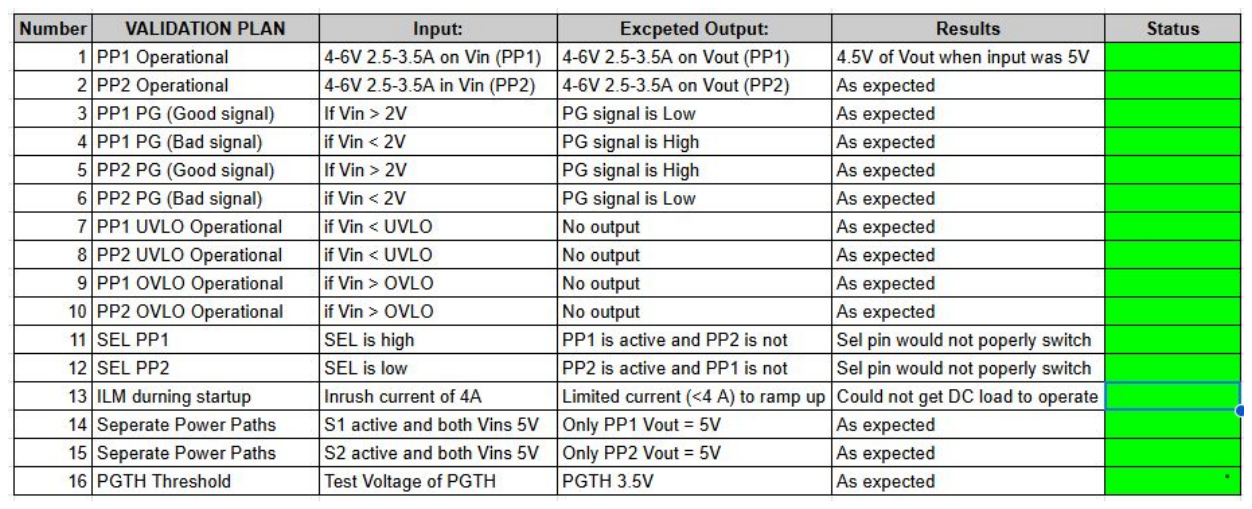
[picture p92: figure]

# Microcontroller Unit

Jaein Cha

Accomplishments since last presentation 23 hrs of effort

Ongoing progress/problems and plans until the next presentation
– Ordered the PCB & Parts
– Assembled the new board
– PCB validation - tried to program the MCU on the custom board with a sample code

– Verify I2C functionality with other subsystem EVMs
– Obtain specific information from other subsystems about required operations/data transfer/register addresses for firmware development
– Make the MCU programmable

# Microcontroller Unit

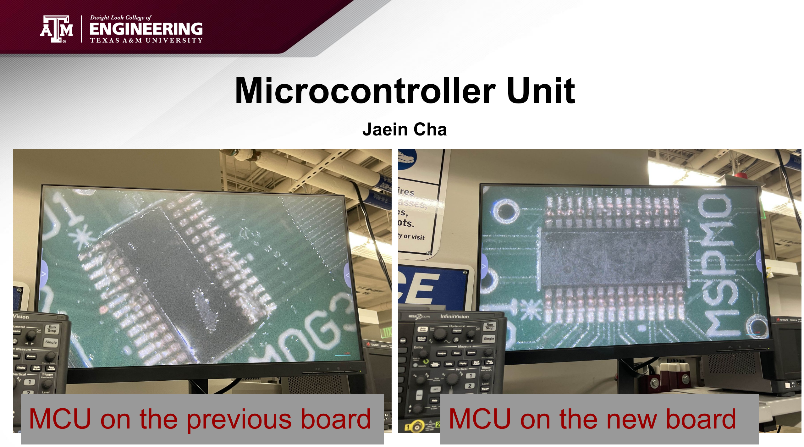
[picture p93: page 12]

Jaein Cha

# MCU on the previous board MCU on the new board

# Microcontroller Unit

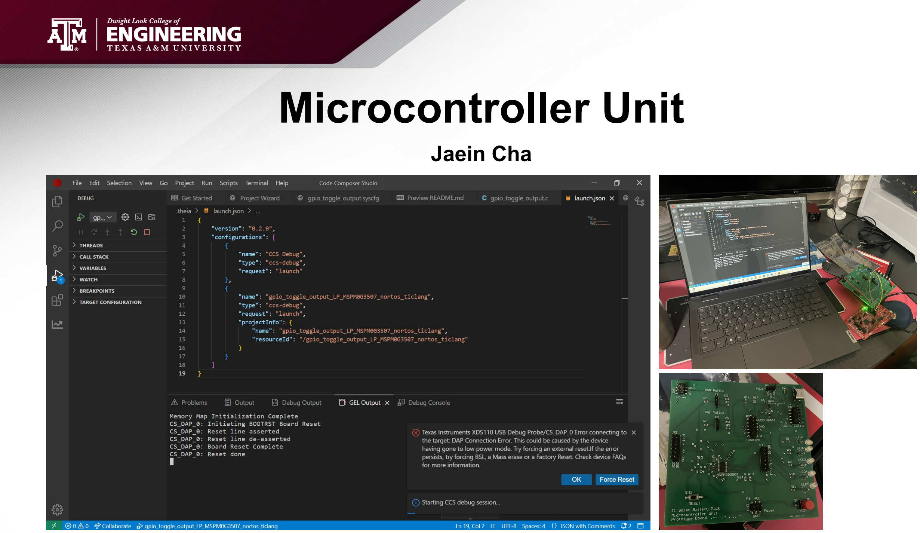
[picture p94: page 13]

## What works:

### - I2C firmware between the MCU and the battery gauge EVM - Input (button) and output (LEDs) on the board when connected to the launchpad

## What doesn’t work:

### - MCU is not connected to the pads properly - not responsive

## What is changing:

- Adjustment on the power trace (VBUS net) - width,

### add connector - Size of the board - reducing the size

Jaein Cha

# Microcontroller Unit

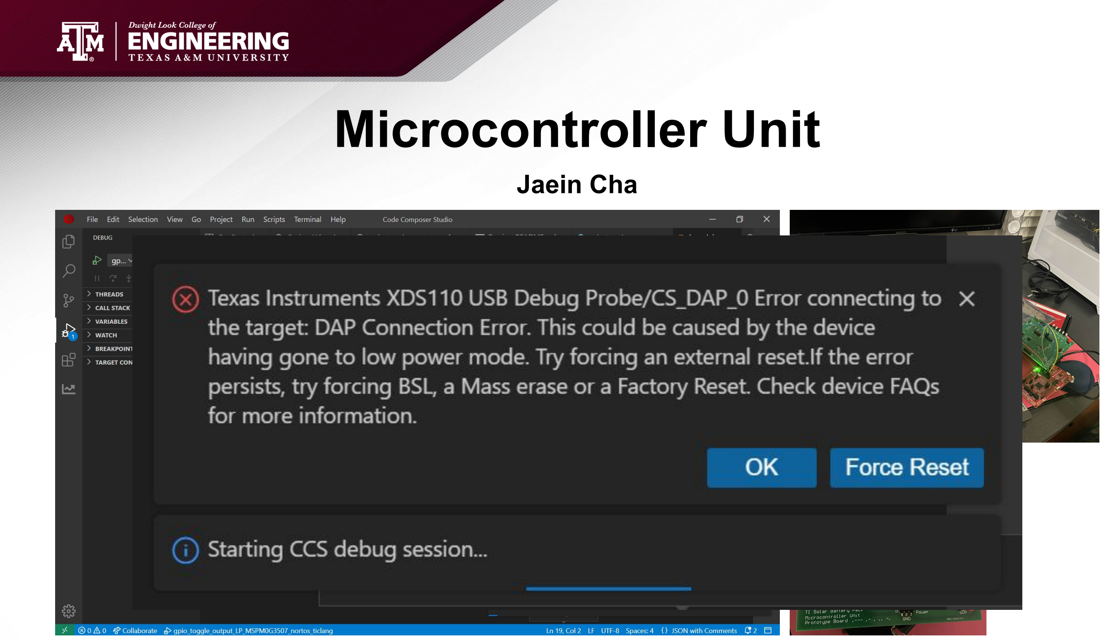
[picture p95: page 14]

## What works:

### - I2C firmware between the MCU and the battery gauge EVM - Input (button) and output (LEDs) on the board when connected to the launchpad

## What doesn’t work:

### - MCU is not connected to the pads properly - not responsive

## What is changing:

- Adjustment on the power trace (VBUS net) - width,

### add connector - Size of the board - reducing the size

Jaein Cha

# Parts Ordering Status

- All subsystem boards and parts are received

# Execution & Plan

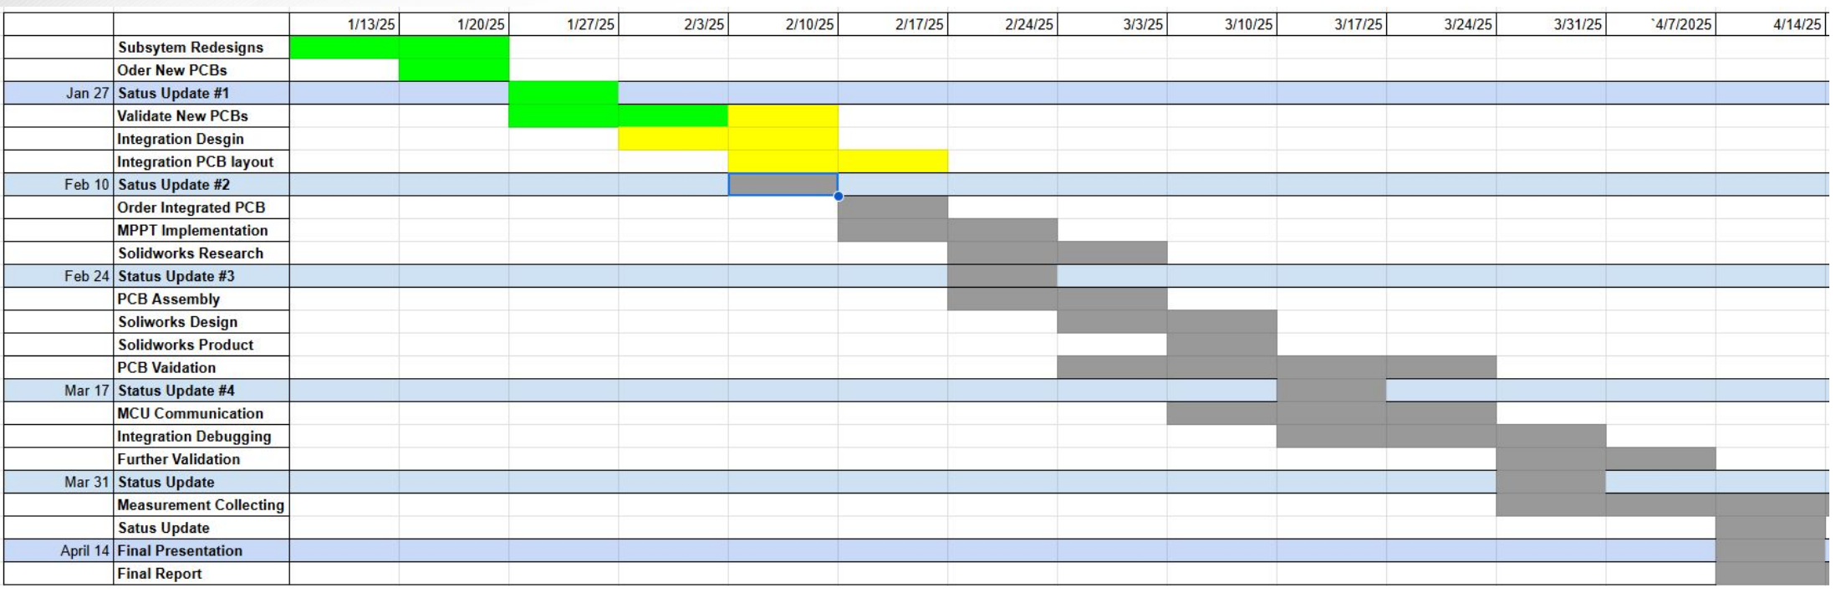
[picture p96: figure]

# Questions?
