jaeinCha/ECEN404-2025SP-TI-Solar-Battery-Pack/Slides/ECEN 404 Presentation 3.pdf

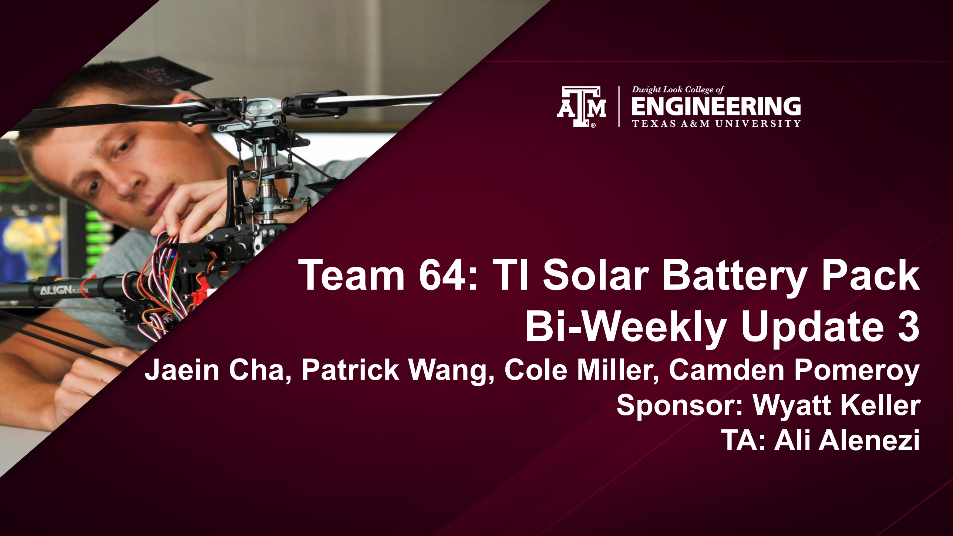
[picture p97: page 1]

# Team 64: TI Solar Battery Pack Bi-Weekly Update 3

## Jaein Cha, Patrick Wang, Cole Miller, Camden Pomeroy

## Sponsor: Wyatt Keller TA: Ali Alenezi

# Project Summary


# - Natural disasters can cause unexpected power outages resulting in the inability to charge cell phones and other necessary small electronic

devices.

# - A solution is to create a solar powered battery pack that charges itself from solar panels, and distributes the power to electronic devices through a USB

connection.

# Project/Subsystem Overview

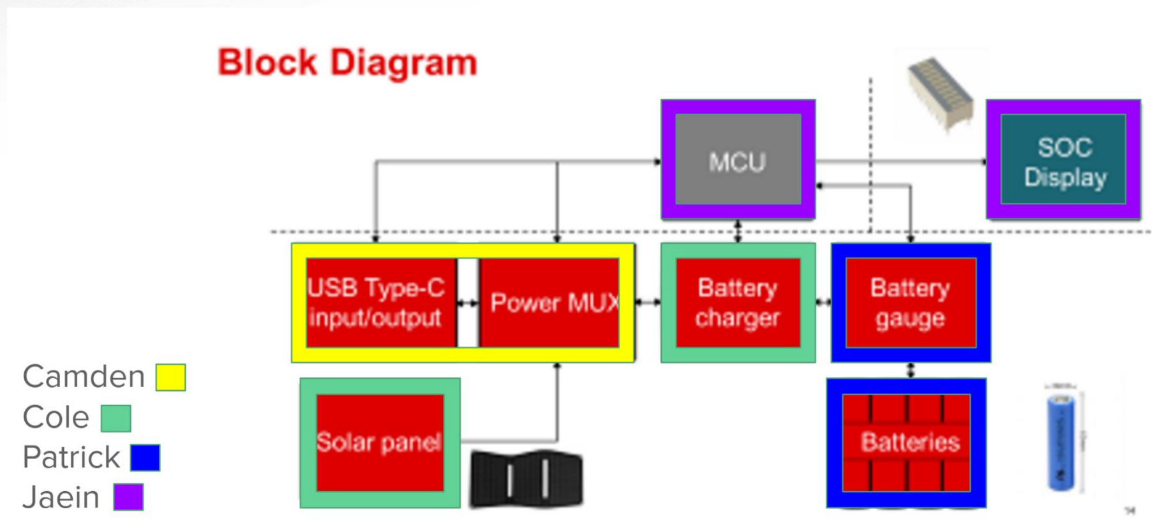
[picture p98: figure]

# Project Timeline

Integration Design; February; Assembly/Validation; March; Validation/Debugging; April; Individual Subsystem Finalization; January

Work together to integrate the designs of each subsystem

Assemble the final pcb and 3D printed enclosure. Perform validation testing and identify problems that occur

Engineer a solution to problems that arise as a result of
integration

Wrap up subsystem design and validation testing

# Patrick Wang (Battery Gauge)

Accomplishments since last update 15 hrs of effort

Ongoing progress/problems and plans until the next presentation
- Ran tests with battery gauge EVM and tested CUV and COV faults
- Able to open CHG and DSG FETs to enable power path and get current and voltage to flow through on my board
- Integrated with the power supply to charge battery pack,
- Currently board has an undervoltage fault, preventing further integration with the charger
- Clear fault by this next meeting, plug into charger

# Patrick Wang

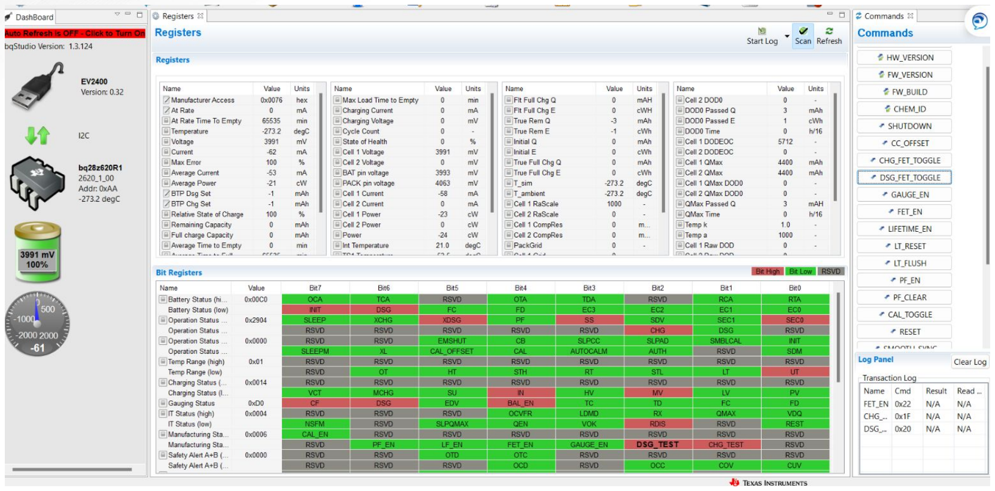
[picture p99: figure]

# Cole Miller (Battery Charger)

Accomplishments since last update 35 hrs of effort | Ongoing progress/problems and plans until the next presentation
- Integration Testing with Power MUX ● Successfully Integrate with EV2400 ● Created final integrated Board ● Helped troubleshoot battery Gauge | ● Order Final integrated PCB ● Battery Gauge Integration ● Quiescent current calculations ● Power Calculations

- Board is currently 6.325in by 2.2in. The FSR mandated the size of the board to be below 8.8in by 5.85in. Leaving space for the walls of the battery pack and fasteners.

# Cole Miller

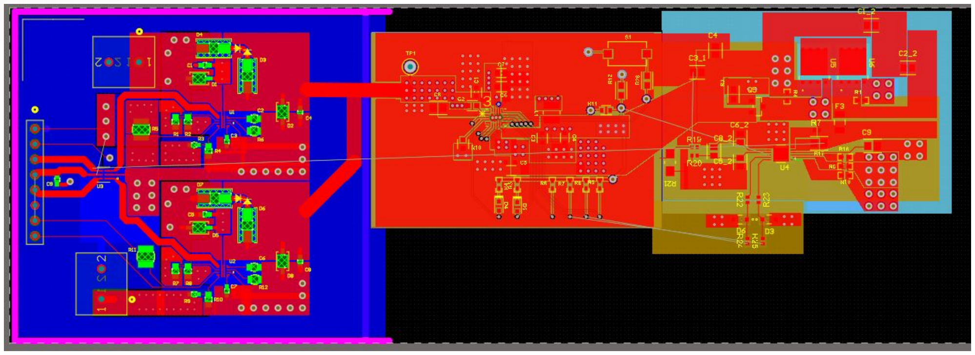
[picture p100: figure]

# Camden Pomeroy (Power MUX)

Accomplishments since last update 20 hrs of effort | Ongoing progress/problems and plans until the next presentation
- Integration testing with Battery Charger ● Created Preliminary battery pack design using Solidworks software ● Design Review Integrated Schematic and PCB layout design | ● Finalize Solidworks Design ● Submit Prototyping Request through FEDC ● Full Integration testing with Patrick’s (Battery Gauge) and Jaein’s (MCU) boards

# Camden Pomeroy

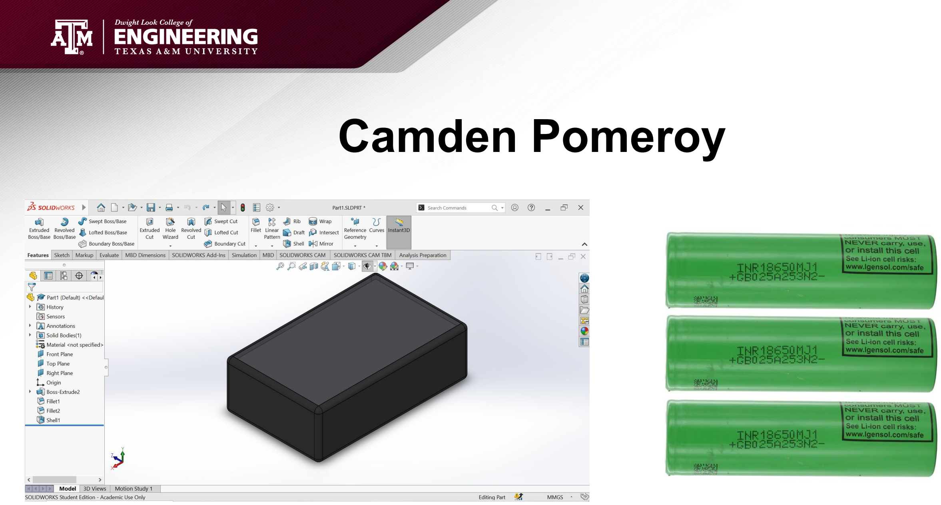
[picture p101: page 10]

# Jaein Cha (MCU)

Accomplishments since last update 15 hrs of effort

Ongoing progress/problems and plans until the next presentation
- Software integration test with TUSB320 EVM for I2C read/write
- Updated MCU & TUSB320 schematics for full integration with other subsystems (including package replacement)
- Resolved the debugger-on board MCU connection issue
- I2C debugging (problem during data transfer)
- Test I2C read/write with other subsystem EVMs and prototype boards
- Integrate updated MCU PCB layout to the integrated board layout (currently finalizing updated PCB layout)
- Implement MPPT for efficient power transfer

# Jaein Cha

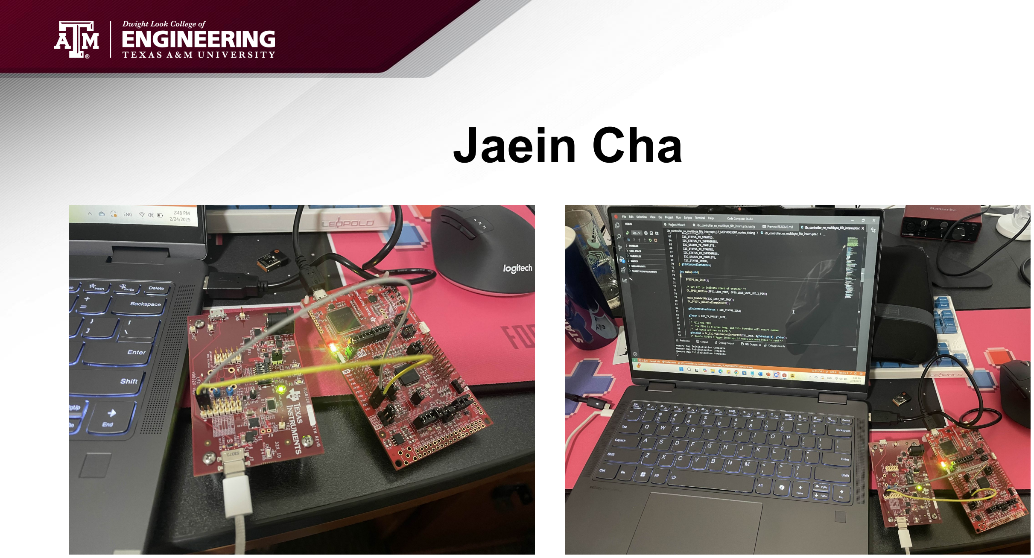
[picture p102: page 12]

# Execution & Validation Plan

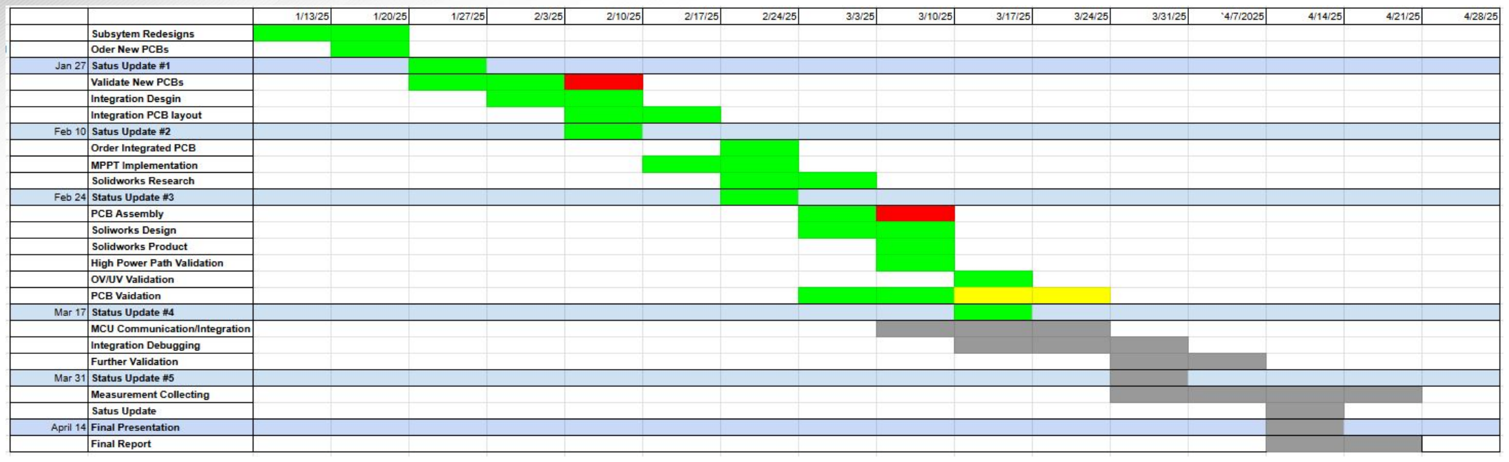
[picture p103: figure]

# Questions?
