jaeinCha/ECEN404-2025SP-TI-Solar-Battery-Pack/Slides/ECEN 404 Presentation 4.pdf

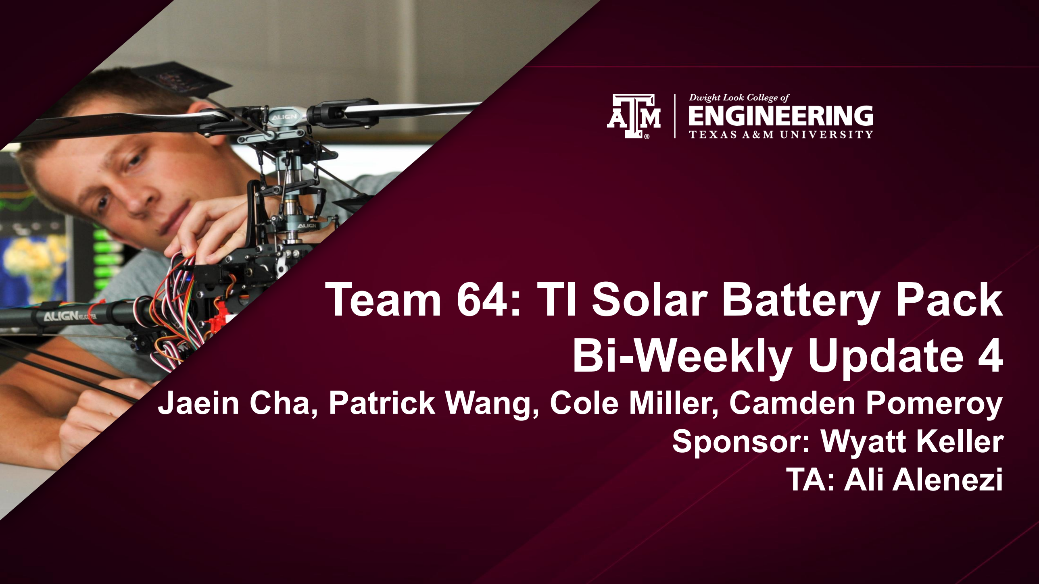
[picture p104: page 1]

# Team 64: TI Solar Battery Pack Bi-Weekly Update 4

## Jaein Cha, Patrick Wang, Cole Miller, Camden Pomeroy

## Sponsor: Wyatt Keller TA: Ali Alenezi

# Project Summary


## - Natural disasters can cause unexpected power outages resulting in the inability to charge cell phones and other necessary

small electronic devices.

## - A solution is to create a solar powered battery pack that

charges itself from solar panels,

## and distributes the power to electronic devices through a USB

connection.

# Integrated System Diagram

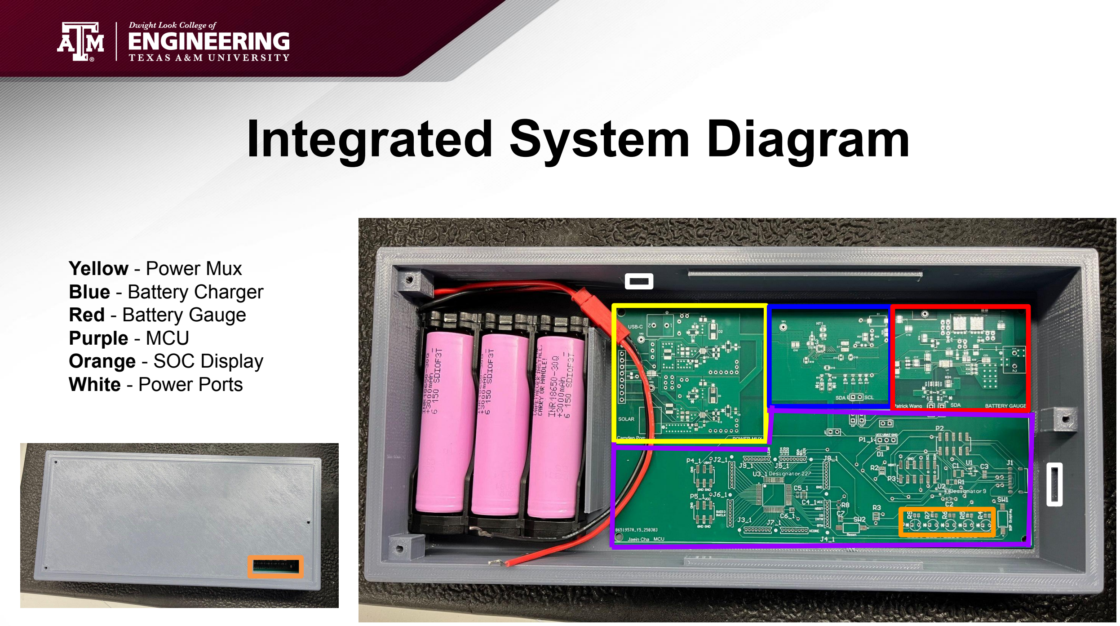
[picture p105: page 3]

Yellow - Power Mux
Blue - Battery Charger
Red - Battery Gauge
Purple - MCU
Orange - SOC Display
White - Power Ports

# Integrated System Diagram (software)

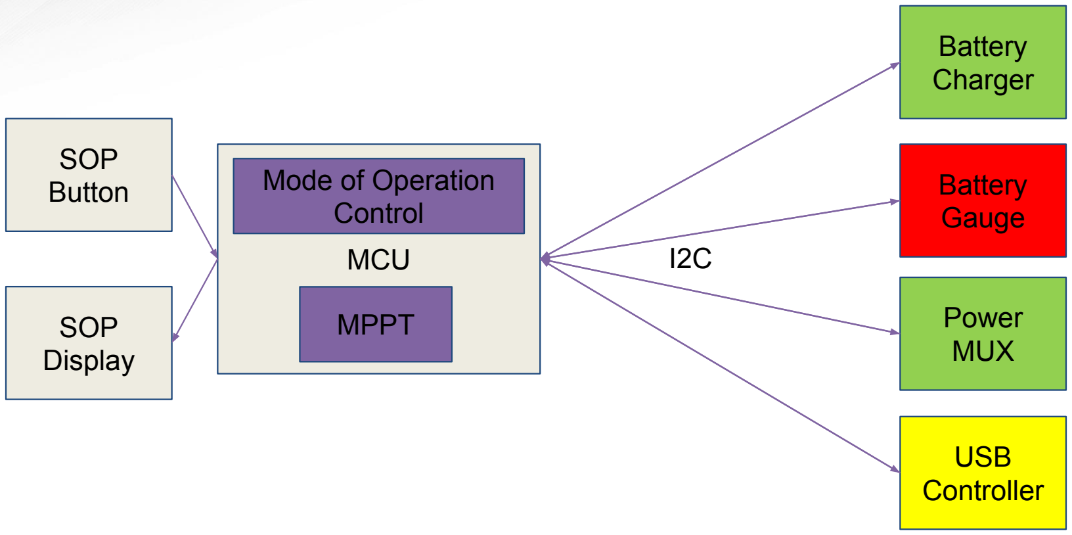
[picture p106: figure]
MCU; Battery Charger; Battery Gauge; Power MUX; USB Controller; MPPT; Mode of Operation Control; SOP Button; SOP Display

# Project Timeline

Subsystem
Designs and
Testing
(completed 2/3)

Integration of High
Power Path
(completed 2/17)

Final Integration
(completed 3/12)

System Test
(to complete by
3/24)

Validation
(to complete by
3/31)

Demo and
Report
(to complete by
4/7)

# Patrick Wang - Battery Gauge

Accomplishments since last update 26 hours | Ongoing progress/problems and plans until the next presentation
- Fully integrated board and parts arrived ● Completed integration with the battery charger on new integrated board ● Calibrated battery gauge charge and discharge “learning cycle” on old subsystem board | ● Fix problem with battery gauge I2C connection ● Calibrate new battery gauge, voltage thresholds, temperature

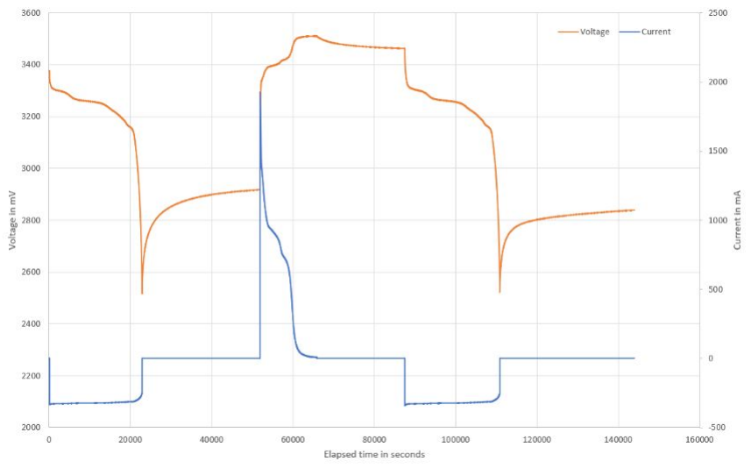
[picture p107: figure]

Image showing chg/dsg learning cycle

# Cole Miller - Battery Charger

Accomplishments since last update 55 hrs of effort | Ongoing progress/problems and plans until the next presentation
Assembled and Validated High power path Removed MPPT from Solar Panel Validated I2C communication with EV2400 Validated USB-C IC | Fix issues with Battery Gauge Assemble USB-C and validate detection Validate control with MCU

# Cole Miller - Battery Charger

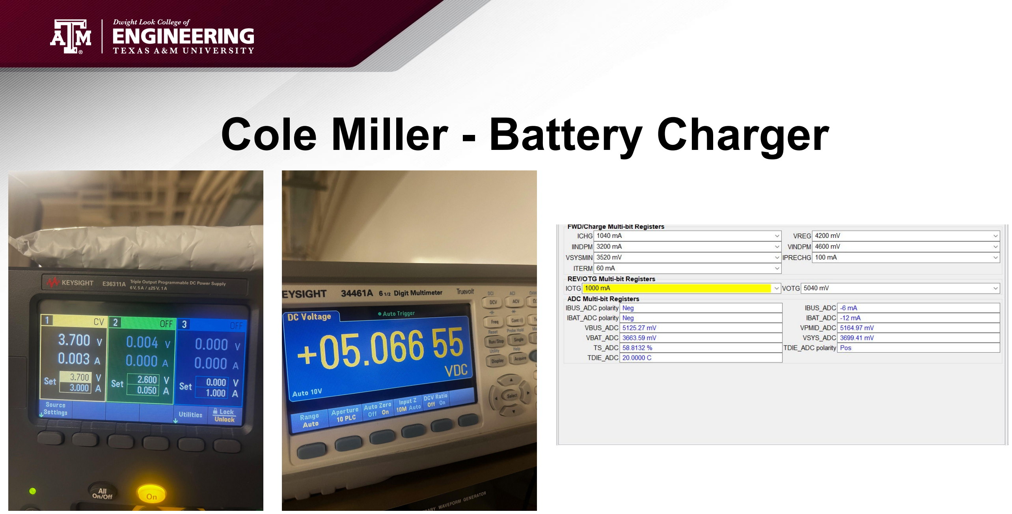
[picture p108: page 8]

# Camden Pomeroy - PMUX

Accomplishments since last update 60 hrs of effort | Ongoing progress/problems and plans until the next presentation
Created battery pack design using Solidworks 3D printed enclosure and verified fit Assembled power path on PCB Validated PMUX subsystem on PCB Validated high power path on fully integrated board | Assemble and validate MCU subsystem Finish validation testing

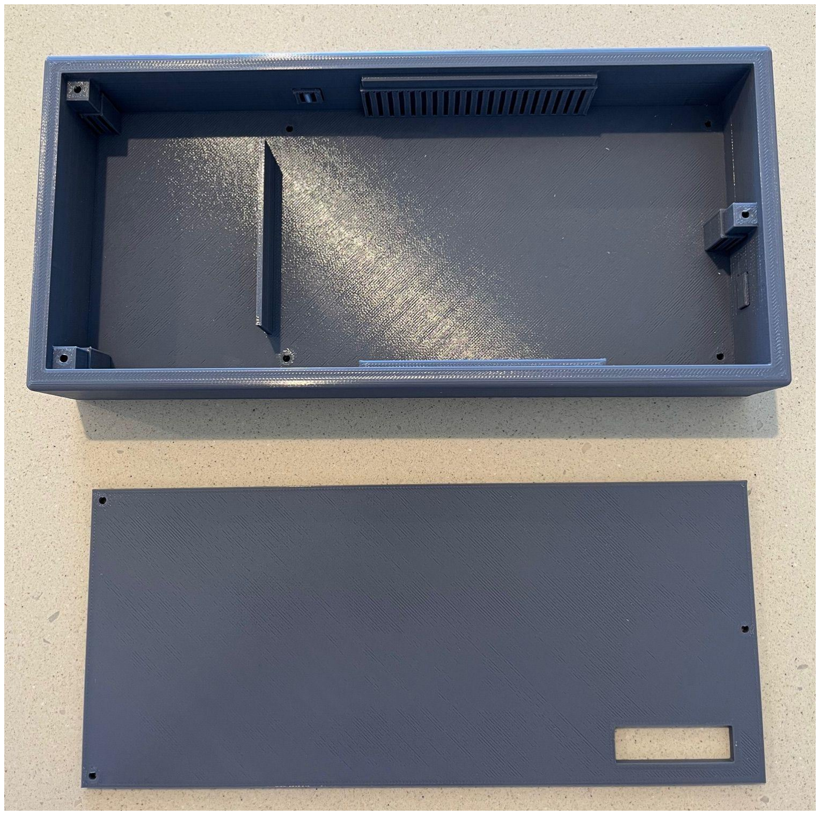
[picture p109: figure]
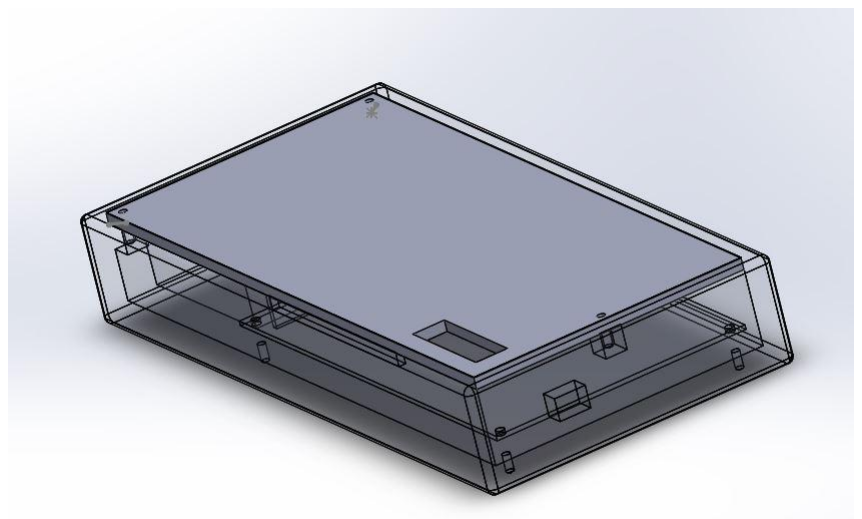
[picture p110: figure]

# Jaein Cha - MCU

Accomplishments since last update 40 hrs of effort

Ongoing progress/problems and plans until the next presentation
- Debugged I2C
- Tested 1:1 I2C functionality on the EVMs
- Prototype of MPPT algorithm implemented
- MPPT implementation tested with dummy signals for algorithm correctness
- System control logic implemented and tested with dummy signals
- Test 1:N I2C functionality across all the EVMs we have
- Test 1:N I2C functionality on board
- Integrate MPPT with the I2C and test with the actual signals
- Validate system controls on the real system

# Jaein Cha - MCU

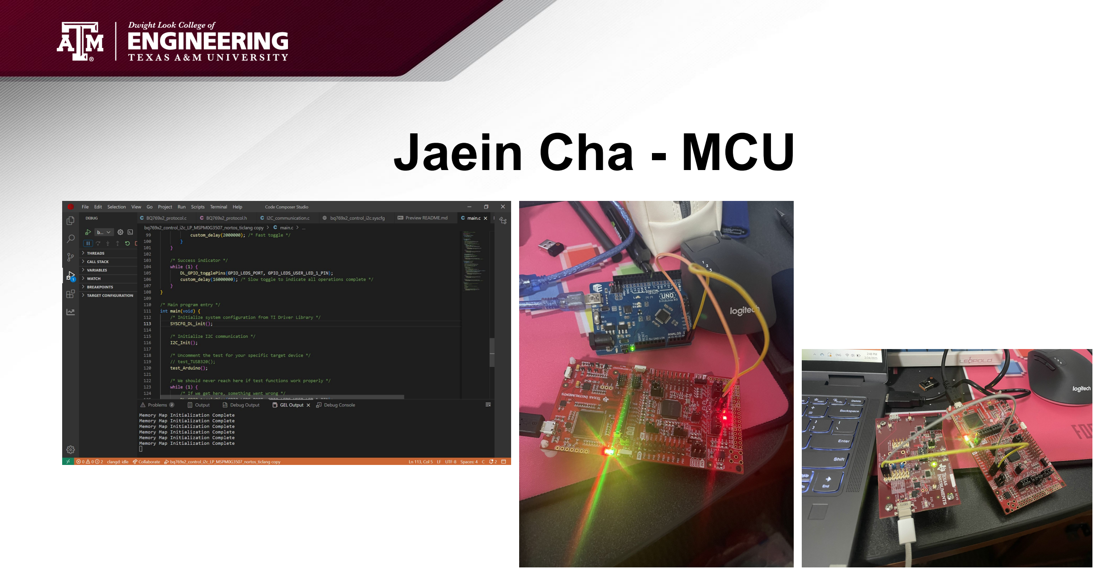
[picture p111: page 11]

# Execution Plan

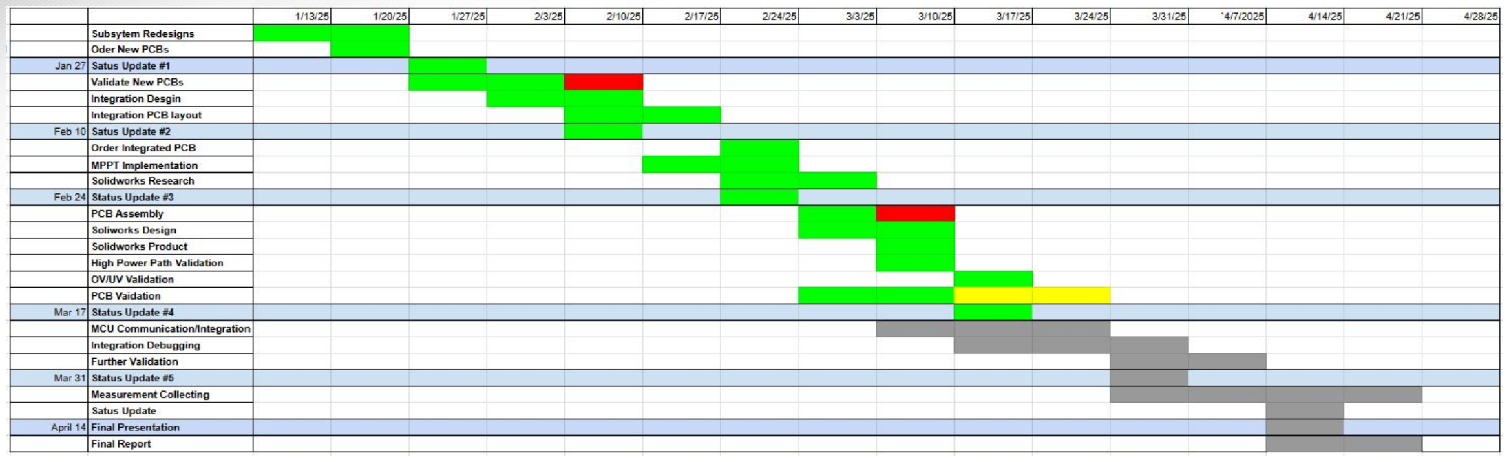
[picture p112: figure]

# System Validation Plan

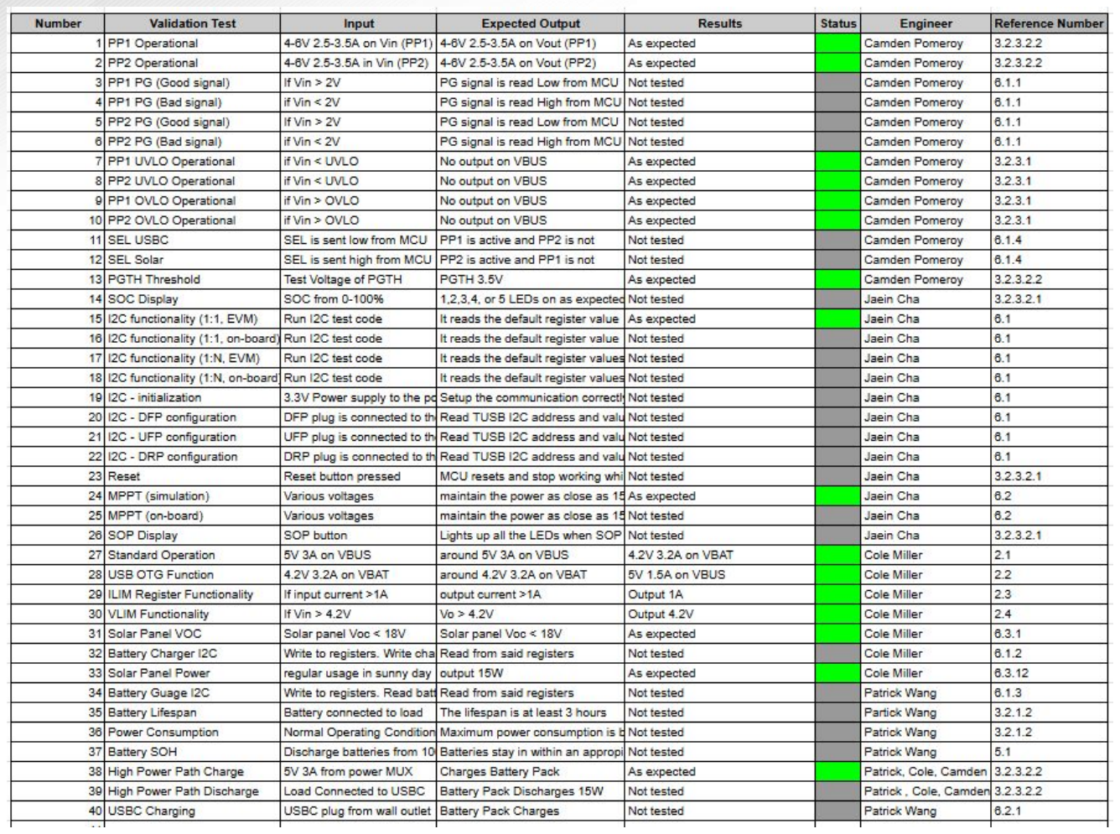
[picture p113: figure]

# Final slide – Questions?
