jaeinCha/ECEN404-2025SP-TI-Solar-Battery-Pack/Slides/ECEN 404 Presentation 5.pdf

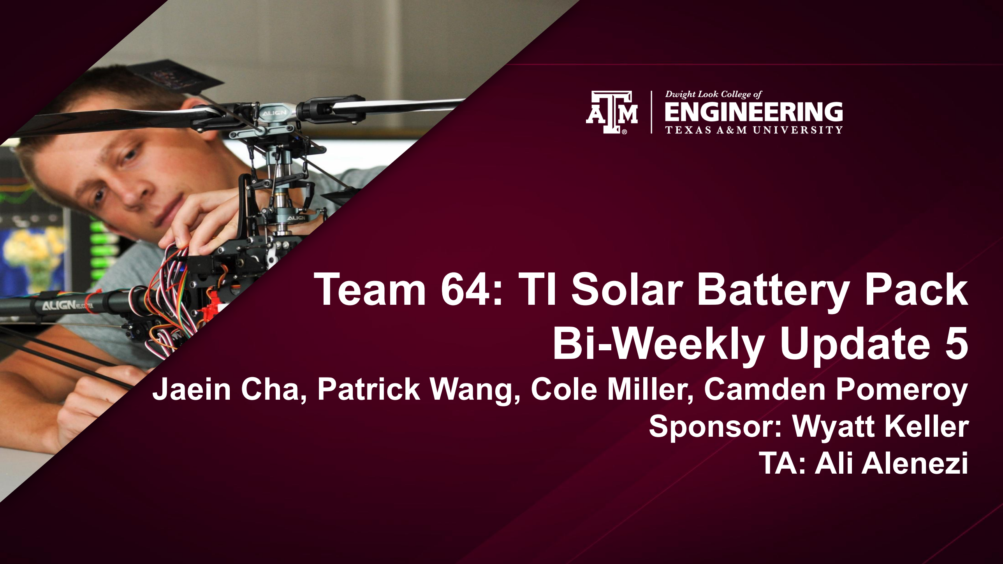
[picture p114: page 1]

# Team 64: TI Solar Battery Pack Bi-Weekly Update 5

## Jaein Cha, Patrick Wang, Cole Miller, Camden Pomeroy

## Sponsor: Wyatt Keller TA: Ali Alenezi

# Project Summary


## - Natural disasters can cause unexpected power outages resulting in the inability to charge cell phones and other necessary

small electronic devices.

## - A solution is to create a solar powered battery pack that

charges itself from solar panels,

## and distributes the power to electronic devices through a USB

connection.

# Integrated System Diagram


Yellow - Power Mux
Blue - Battery Charger
Red - Battery Gauge
Purple - MCU
Orange - SOC Display
White - Power Ports

# Integrated System Diagram (software)

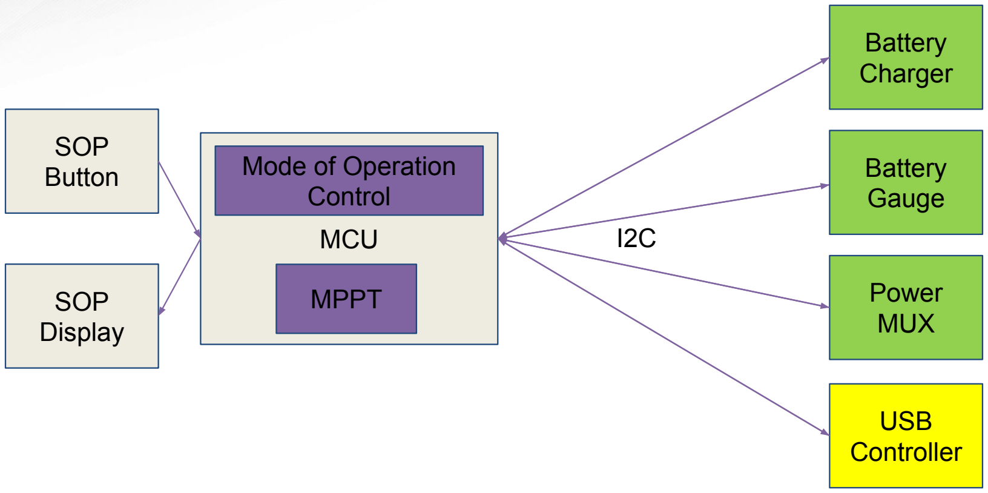
[picture p115: figure]
MCU; Battery Charger; Power MUX; USB Controller; MPPT; Mode of Operation Control; SOP Button; SOP Display; Battery Gauge

# Project Timeline

Subsystem
Designs and
Testing
(completed 2/3)

Integration of High
Power Path
(completed 2/17)

Final Integration
(completed 3/12)

System Test
(to complete by
3/31)

Validation
(to complete by
4/7)

Demo and
Report
(to complete by
4/17)

# Patrick Wang

Accomplishments since last update 15 hrs of effort | Ongoing progress/problems and plans until the next presentation
- Fixed Battery Gauge I2C communication issues ● Validated correct output voltages and behavior for when Vin is within threshold ● Programmed gauge to calibrate temps, threshold voltages, and battery parameters | ● Measure time to fully charge and discharge battery pack

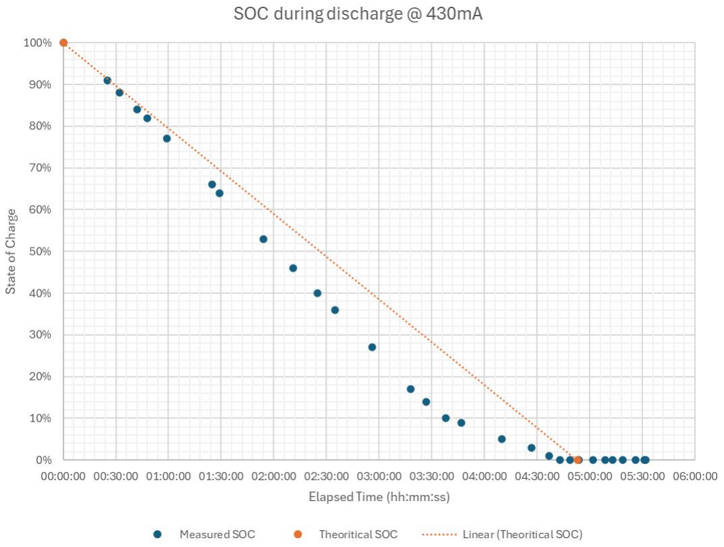
[picture p116: figure]
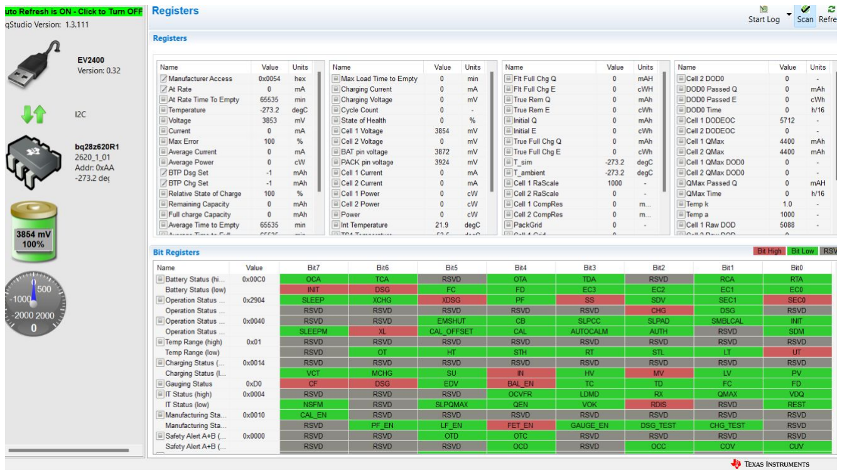
[picture p117: figure]
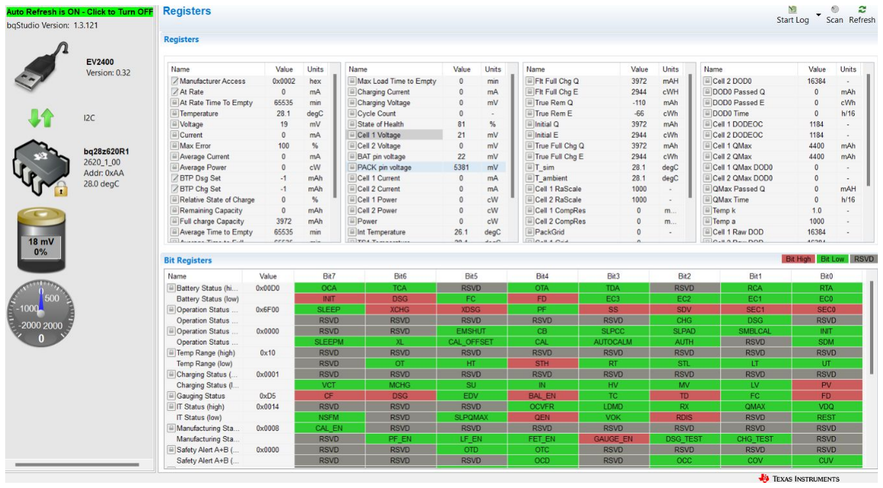
[picture p118: figure]

# Cole Miller

Accomplishments since last update 30 hrs of effort | Ongoing progress/problems and plans until the next presentation
Fixed battery Gauge Issues Validated high power functionality Finishes assembly Validated 0.5 to 3 amp charging Validated OV and OC protections | Diagnose Boost converter waveform Characterize efficiency for full input range

# Cole Miller - Buck Verification

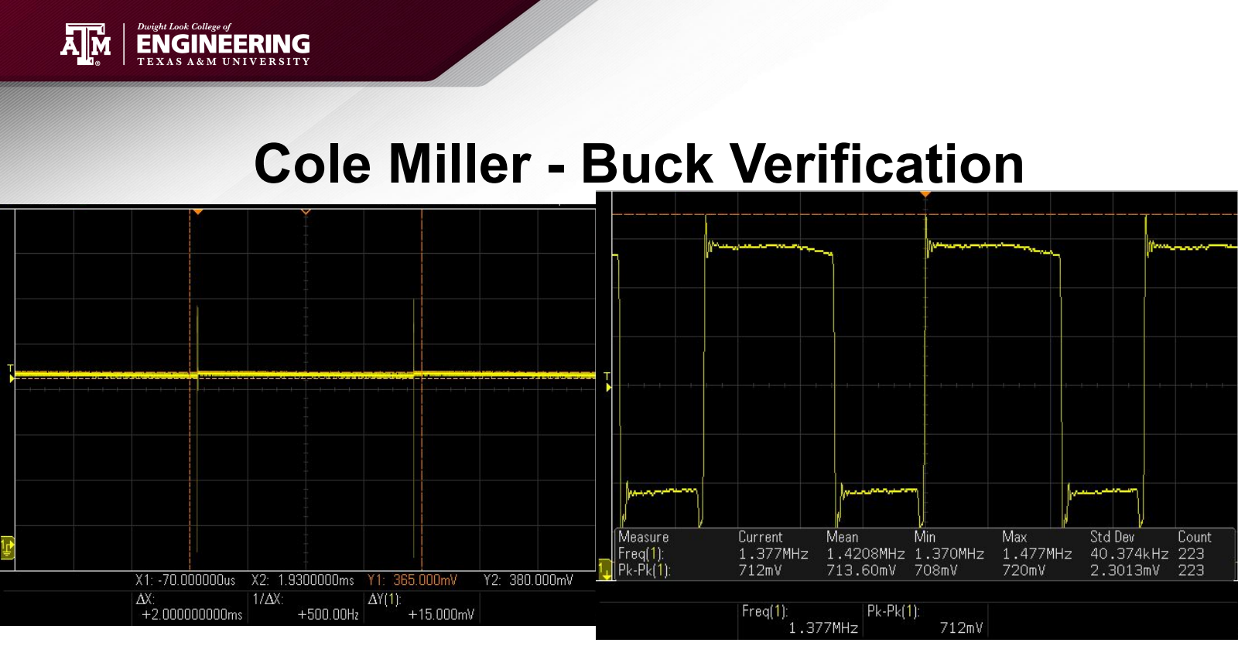
[picture p119: page 8]

# Cole Miller - Boost Verification

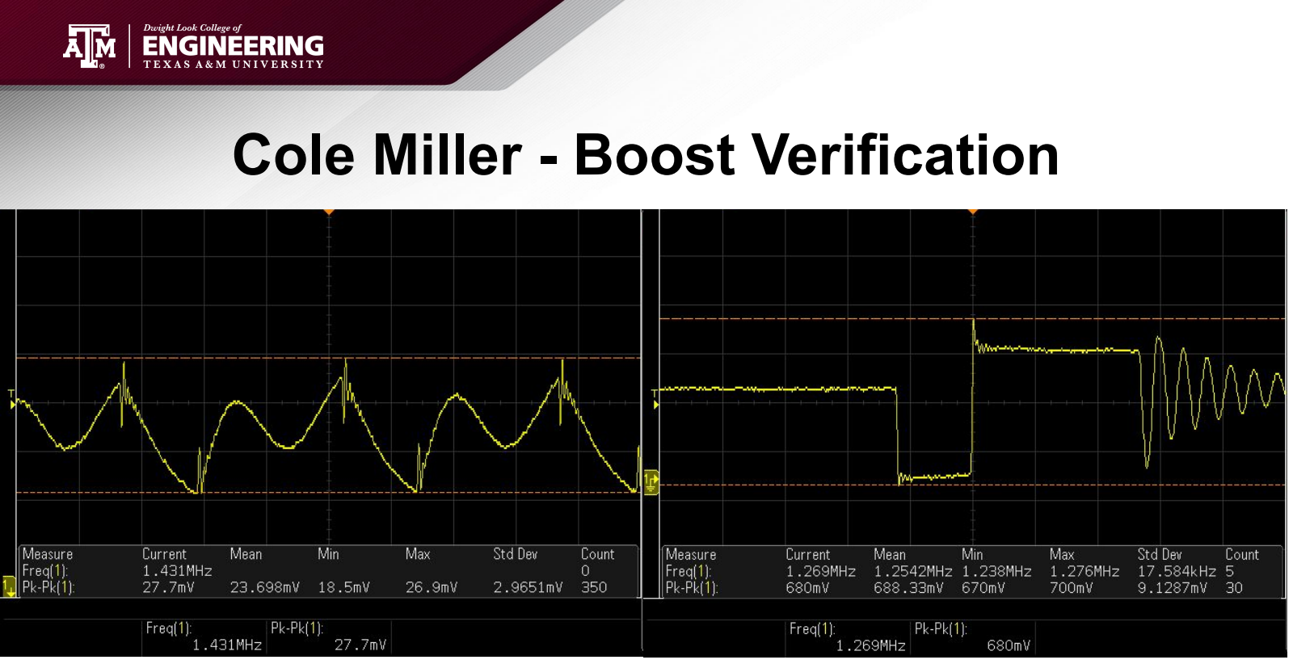
[picture p120: page 9]

# Charger Operation

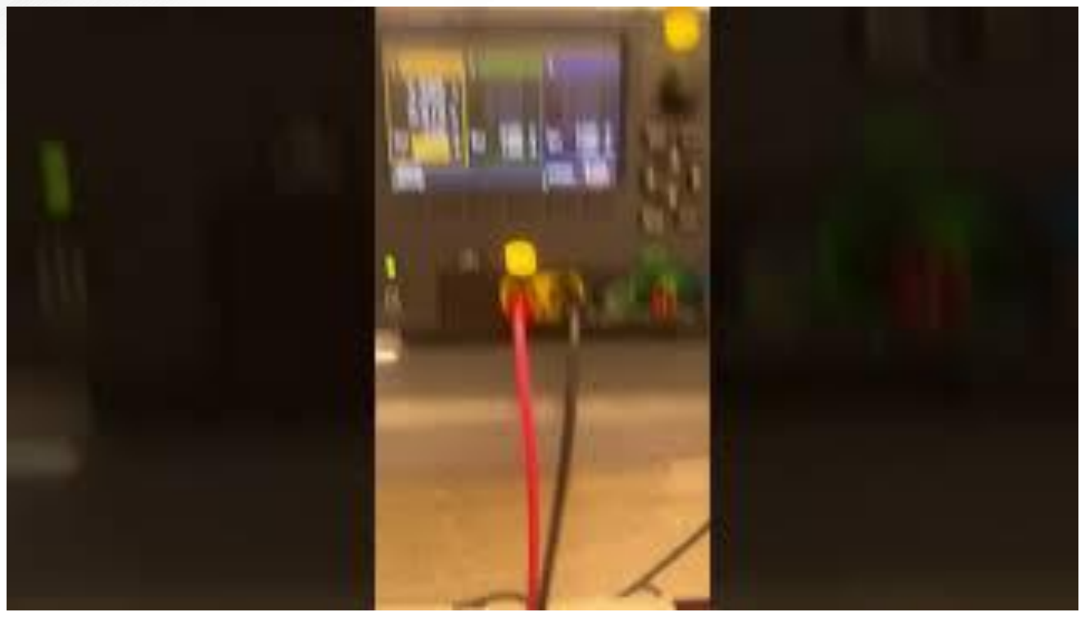
[picture p121: figure]

# Camden Pomeroy

Accomplishments since last update 35 hrs of effort | Ongoing progress/problems and plans until the next presentation
MCU System Assembly on PCB Validated Safety of Multiple Loads Validated Charge/Discharge under wide range of solar panel operating voltage conditions Validated system shutdown during over/undervoltage | MCU I2C Communication Assembling Enclosure Collect Measurements for Report

# Camden Pomeroy

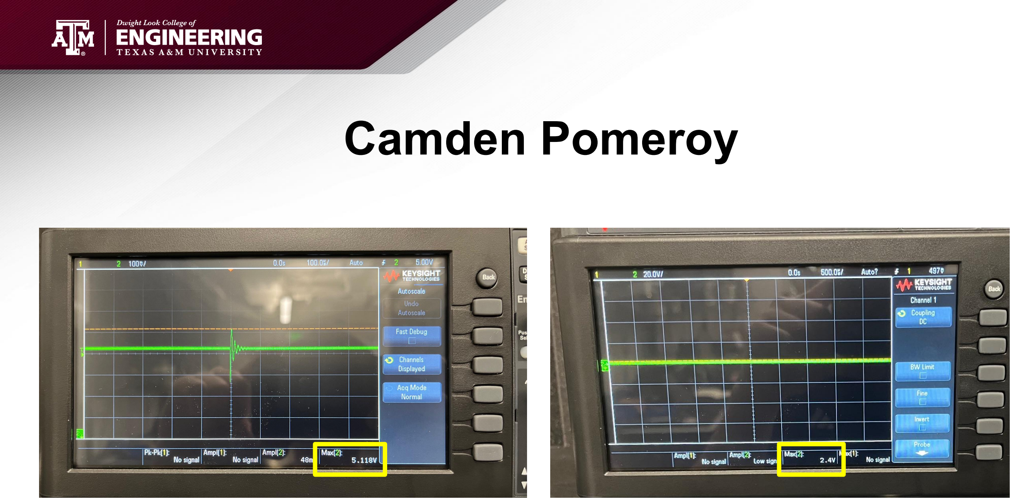
[picture p122: page 12]

# Camden Pomeroy

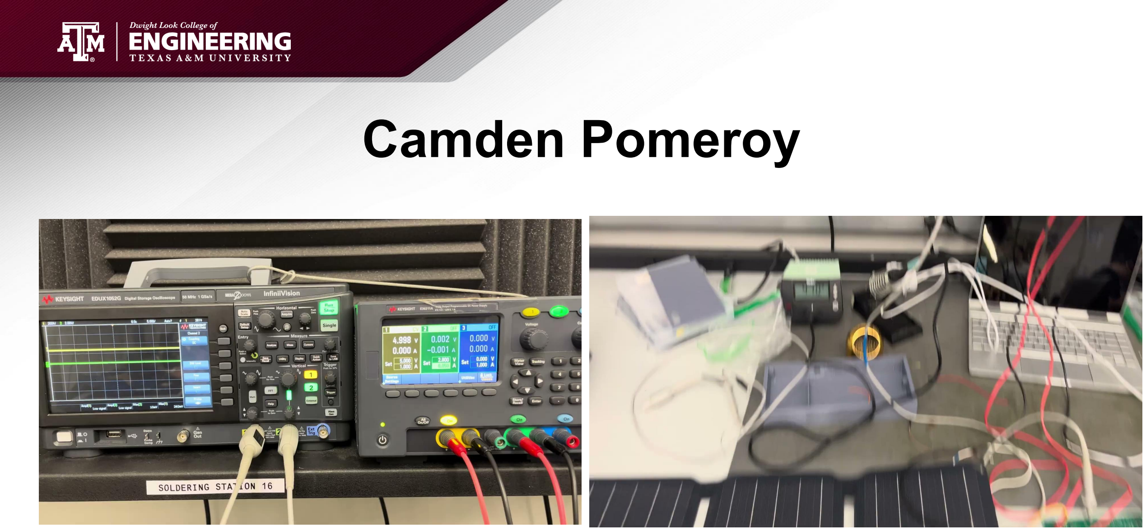
[picture p123: page 13]

# Jaein Cha

Accomplishments since last update 23 hrs of effort

Ongoing progress/problems and plans until the next presentation
- I2C serial port echoing was added for debugging purpose (additional to the LED blinking indication)
- I2C debugging when multiple devices are on the bus
- On board MCU connection unstable -identifying the problem for debugging

Debug the MCU connection problem On-board testing of the control logic and I2C communication
Final validation

# Jaein Cha

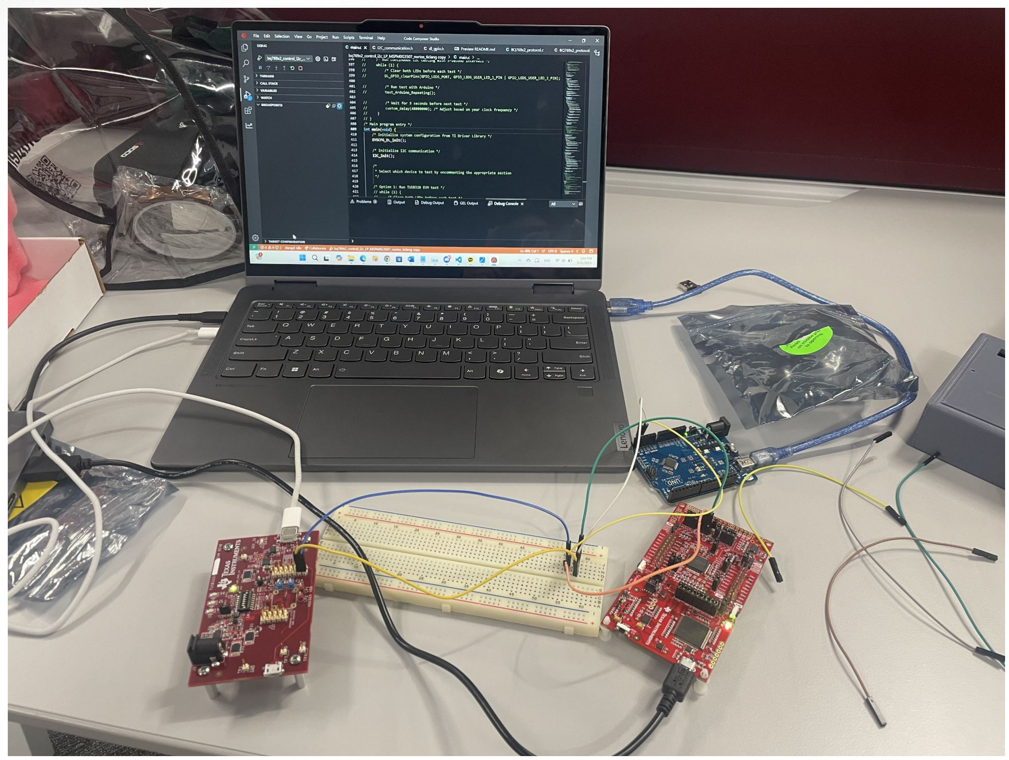
[picture p124: figure]

# Execution Plan

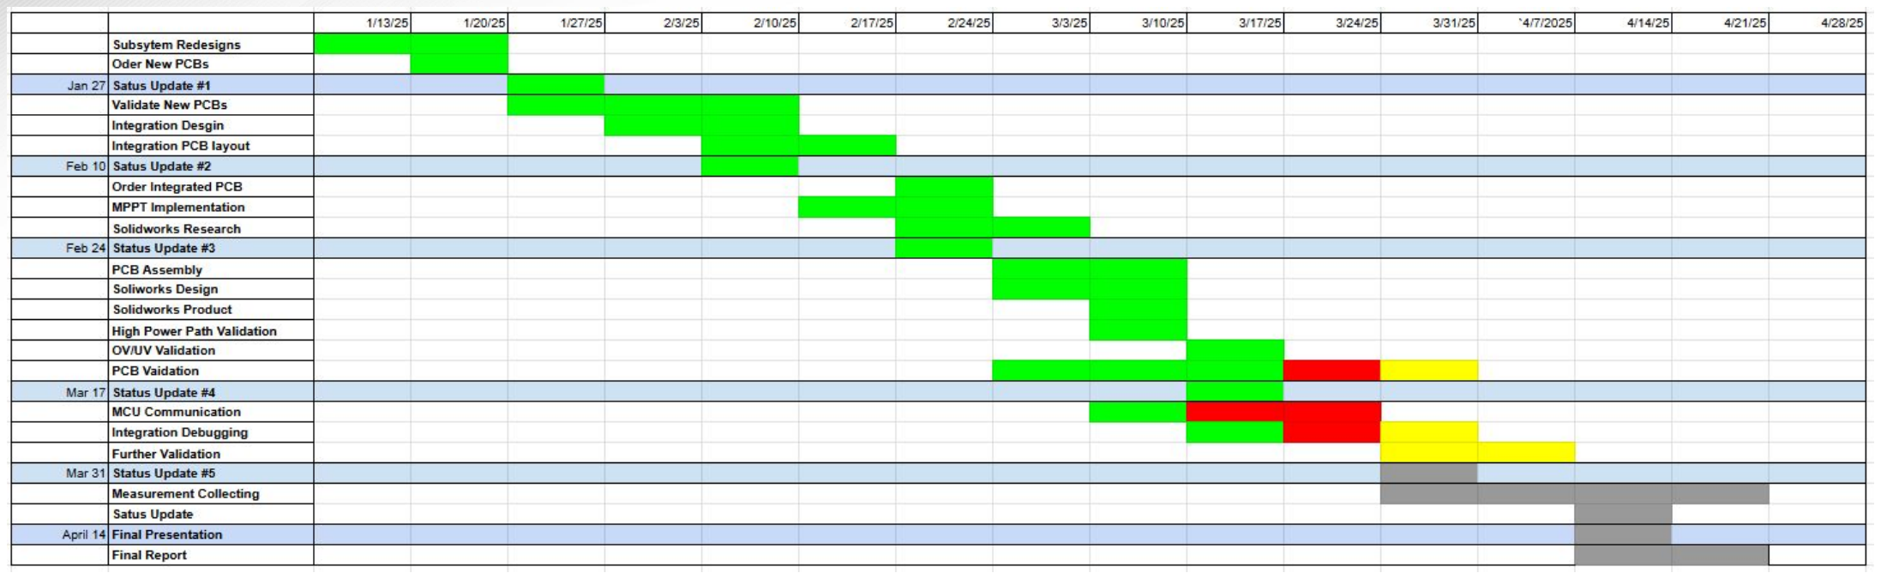
[picture p125: figure]

# SYSTEM Validation Plan

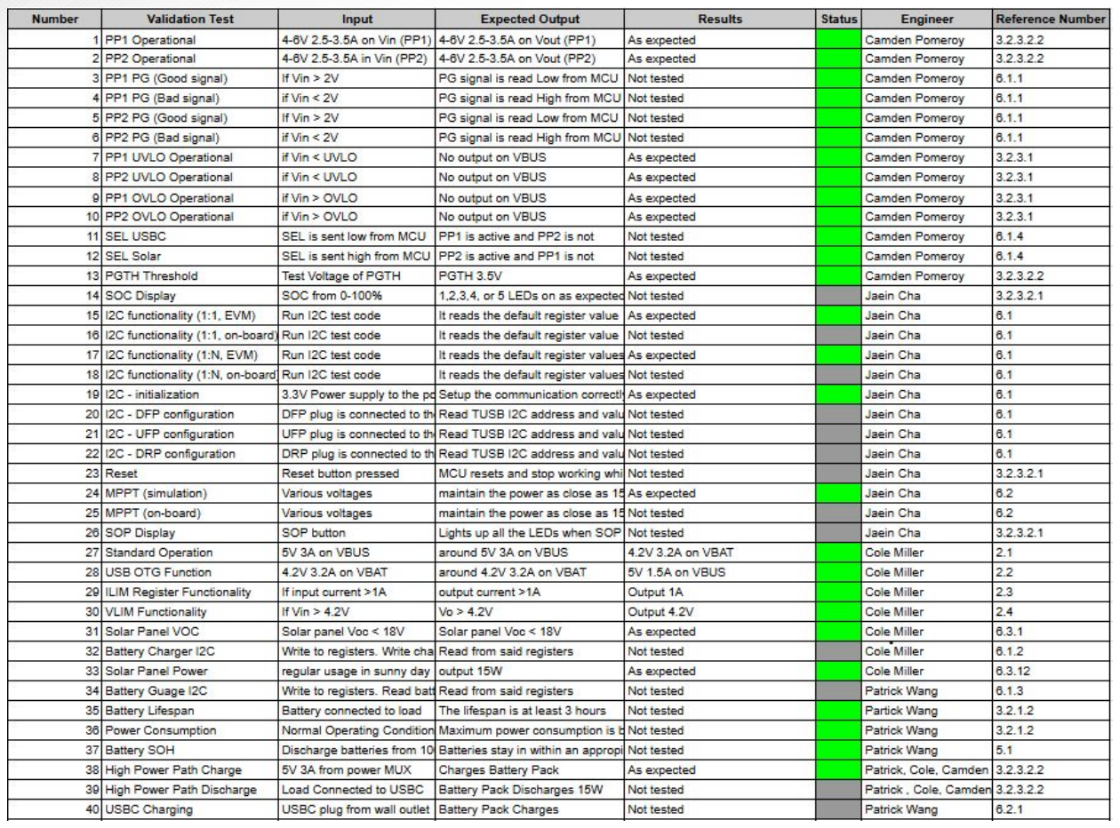
[picture p126: figure]

# Final slide – Thank you
