jaeinCha/ECEN404-2025SP-TI-Solar-Battery-Pack/Slides/ECEN 404 Texas Instruments Presentation .pdf

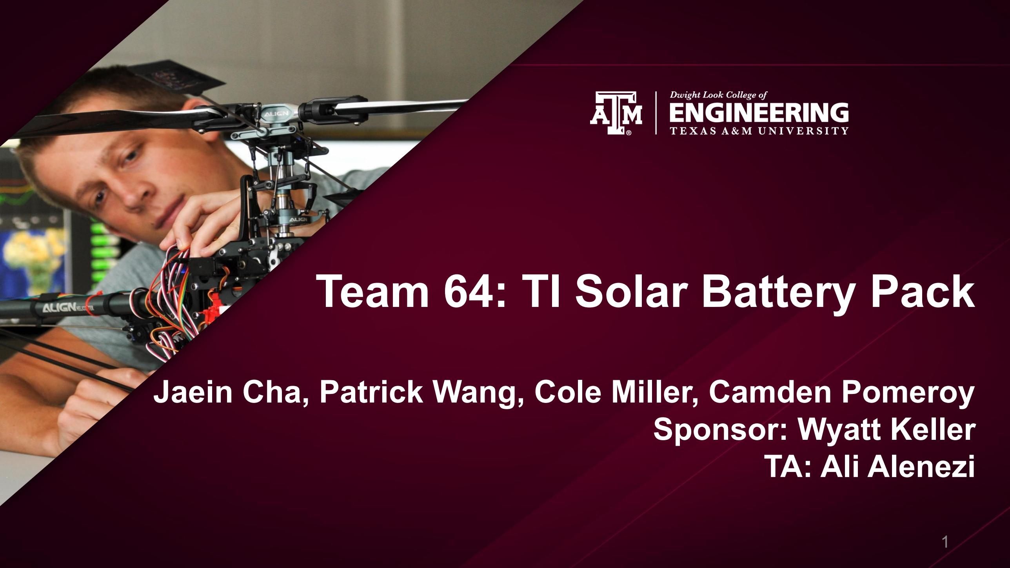
[picture p127: page 1]

# Team 64: TI Solar Battery Pack

## Jaein Cha, Patrick Wang, Cole Miller, Camden Pomeroy

## Sponsor: Wyatt Keller TA: Ali Alenezi

# Project Summary


## - Natural disasters, camping, or remote backpacking may result in a scenario with the inability to charge cell phones and other necessary

small electronic devices.

## - A solution is to create a solar powered battery pack that charges itself from solar panels, and distributes the power to electronic

devices through a USB connection.

# Subsystem Overview


# Integrated System Design

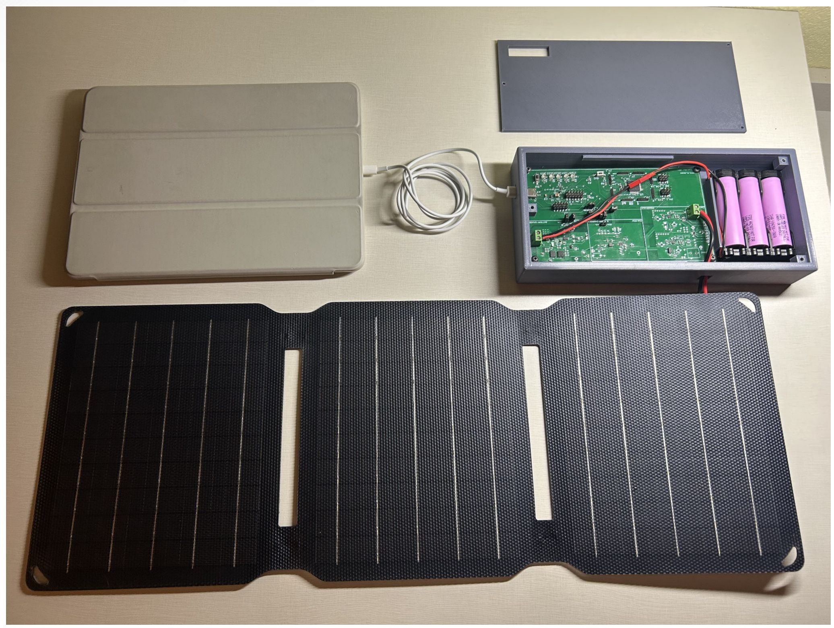
[picture p128: figure]

# Board Design

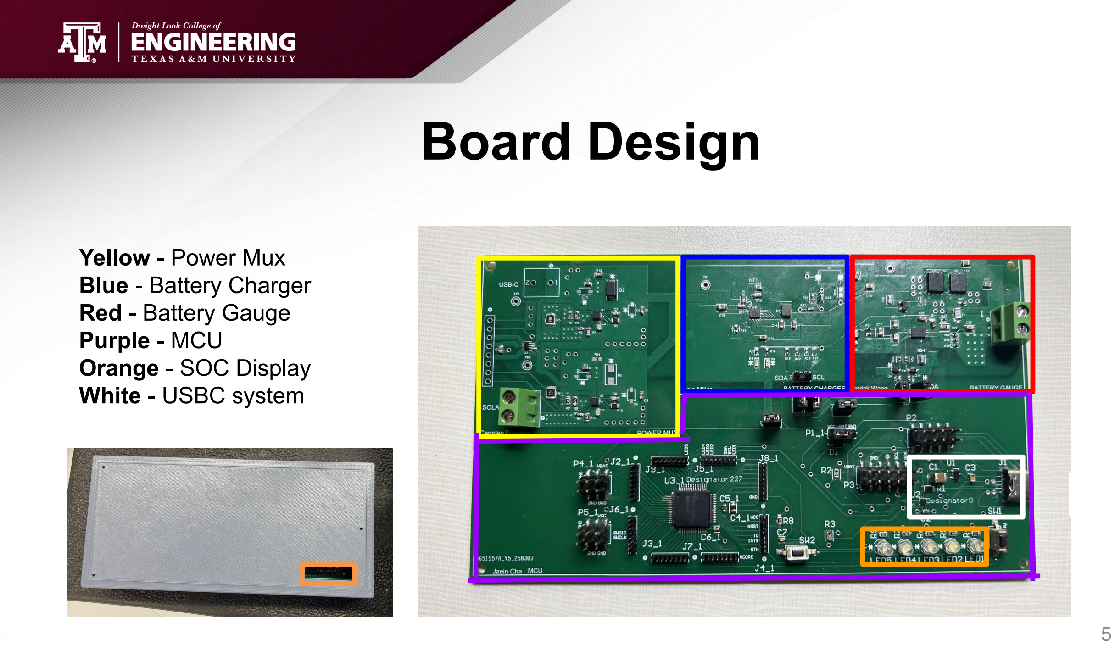
[picture p129: page 5]

Yellow - Power Mux
Blue - Battery Charger
Red - Battery Gauge
Purple - MCU
Orange - SOC Display
White - USBC system

# Integrated System Diagram (Software)

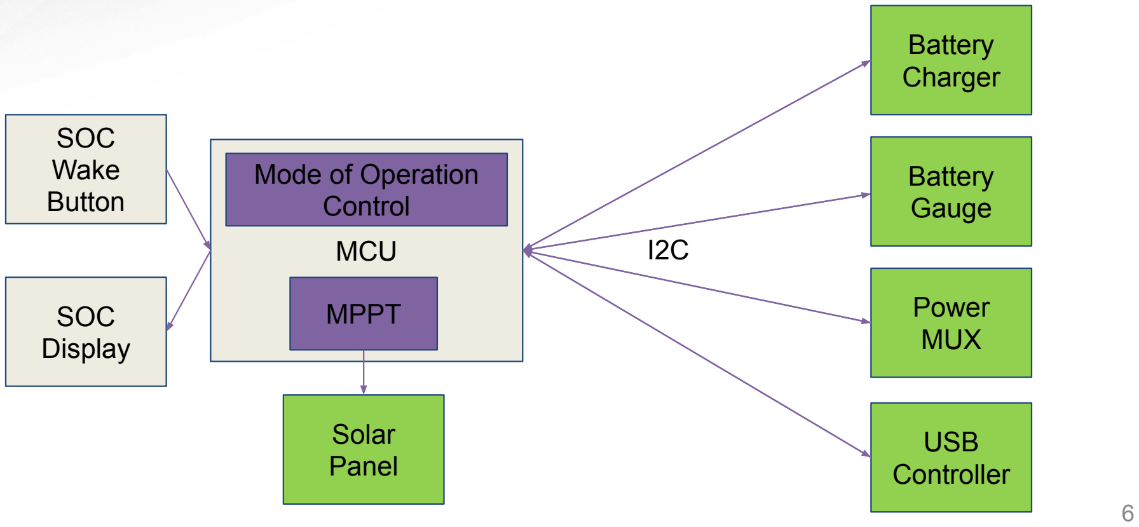
[picture p130: figure]
MCU; Battery Charger; Power MUX; USB Controller; MPPT; Mode of Operation Control; SOC Wake Button; SOC Display; Battery Gauge; Solar Panel

# USB-C Input


## - USB-C logic controlled by TUSB320

## - Configured as a DRP in I2C mode

## - Validated to source and sink devices and control VBUS

# USB-C Input

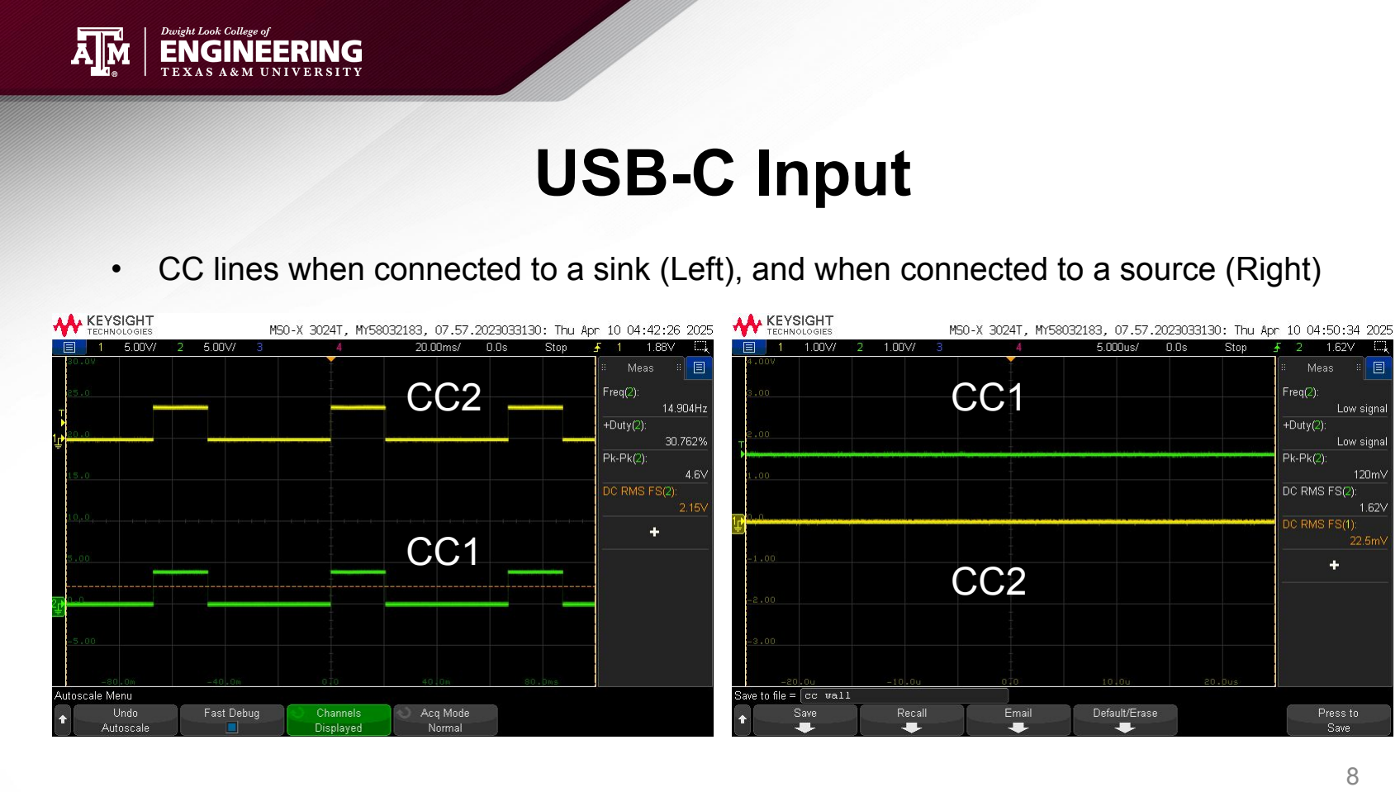
[picture p131: page 8]

- CC lines when connected to a sink (Left), and when connected to a source (Right)

CC2

CC1

CC1

CC2


## Solar Panel Input • 2.5V to 7.5V output at 15W

## across three foldable lightweight panels

## - On a standard sunny day charges at 7V 2A on average

## - Cloudy day 7V at 0.5A

# Power Mux

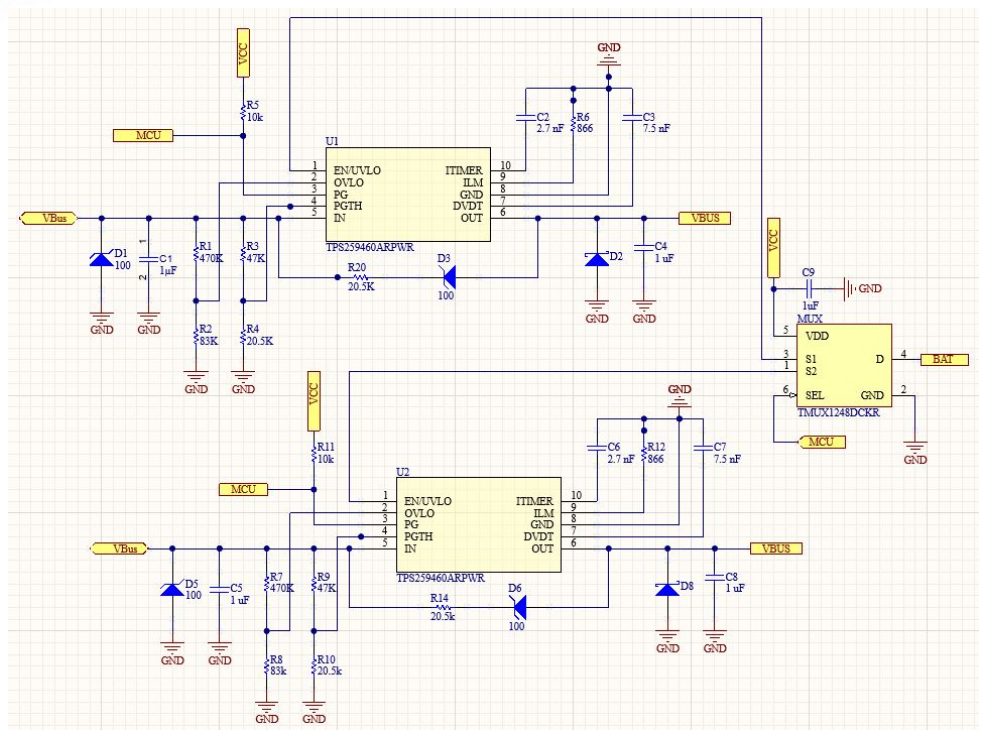
[picture p132: figure]

### - Protection of system when USB-C and Solar inputs are connected

### - Break before make switching

### - UV/OV Shutoff Protection with Auto Retry

### - MCU good input power detection and control over enabling power paths

# Power Mux

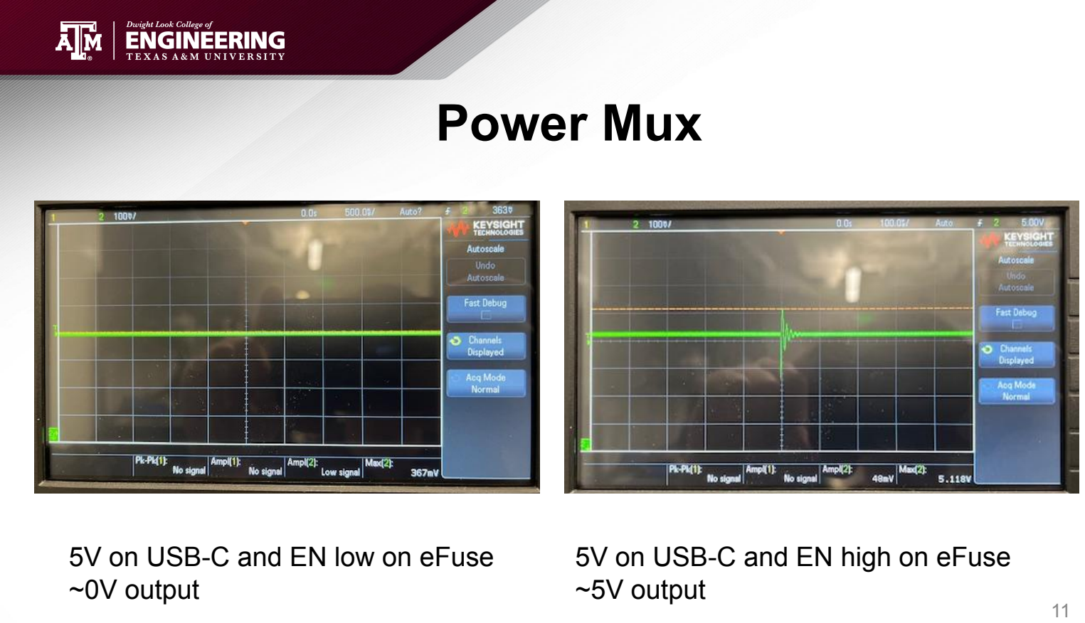
[picture p133: page 11]

### 5V on USB-C and EN high on eFuse ~5V output

### 5V on USB-C and EN low on eFuse ~0V output

# Battery Charger


## - Utilizes a BQ25622

## - While charging battery acts as a buck converter

## - While charging Devices acts as a boost converter

## - Controls current and voltage

# Battery Charger - Buck

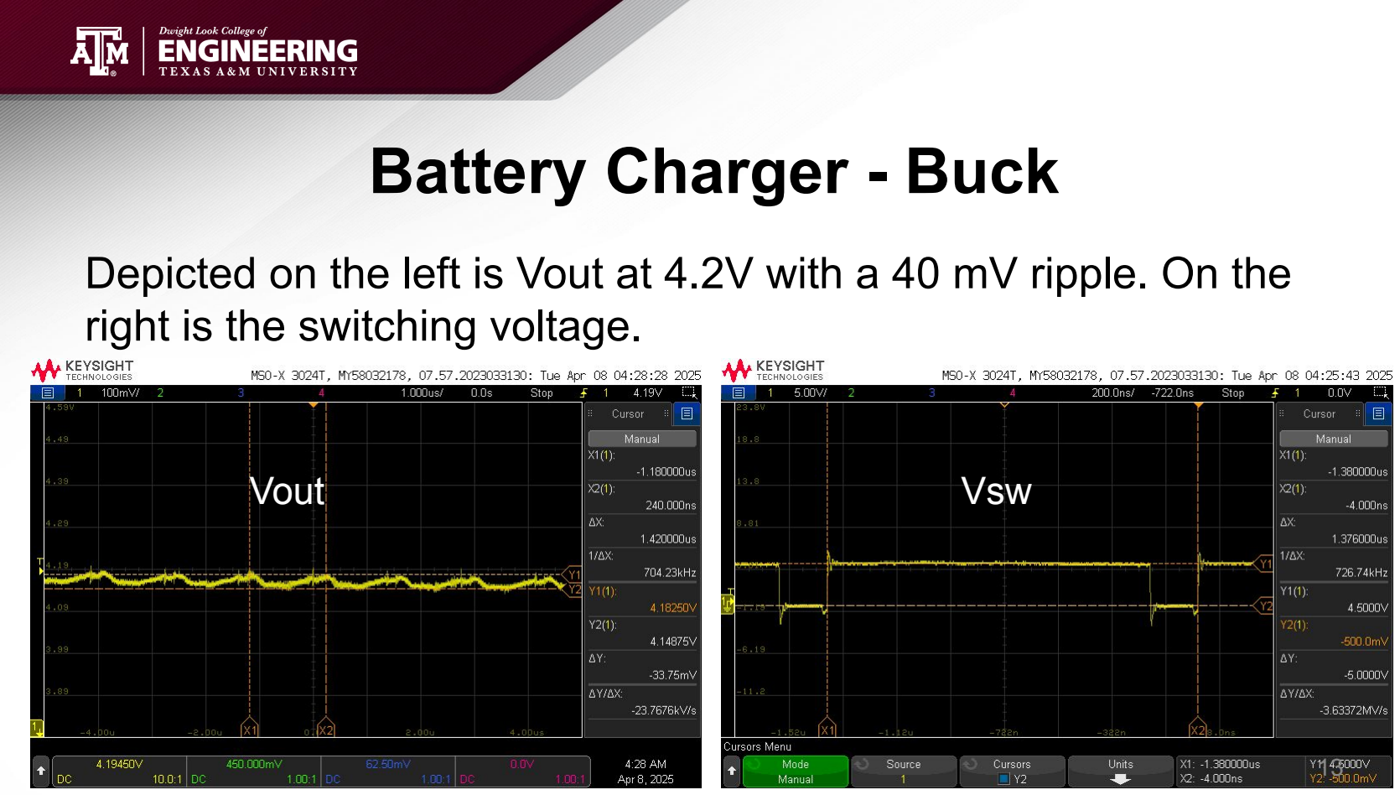
[picture p134: page 13]

## Depicted on the left is Vout at 4.2V with a 40 mV ripple. On the

right is the switching voltage.

Vout | Vsw

# Battery Charger - Boost

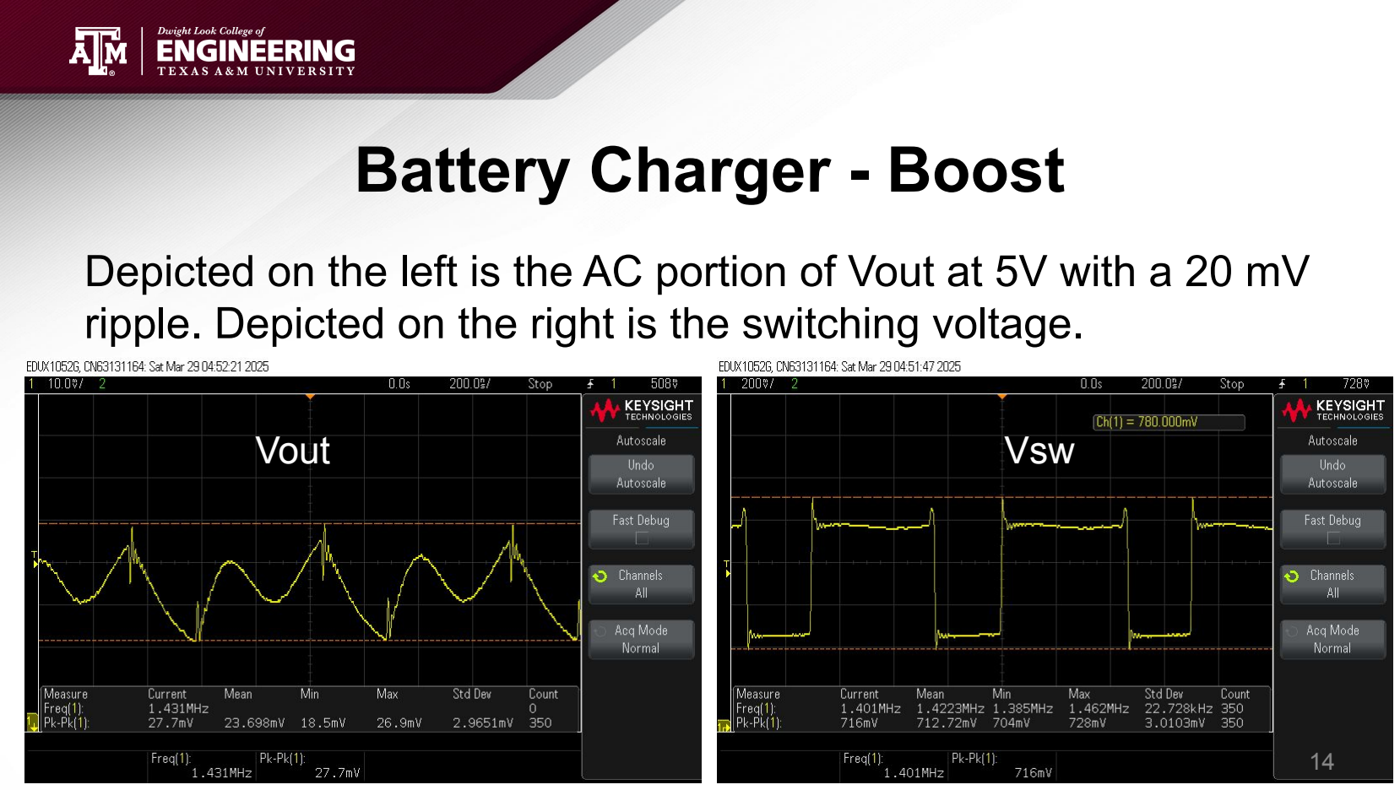
[picture p135: page 14]

## Depicted on the left is the AC portion of Vout at 5V with a 20 mV

ripple. Depicted on the right is the switching voltage.

Vout | Vsw

# Battery Charger - Efficiency

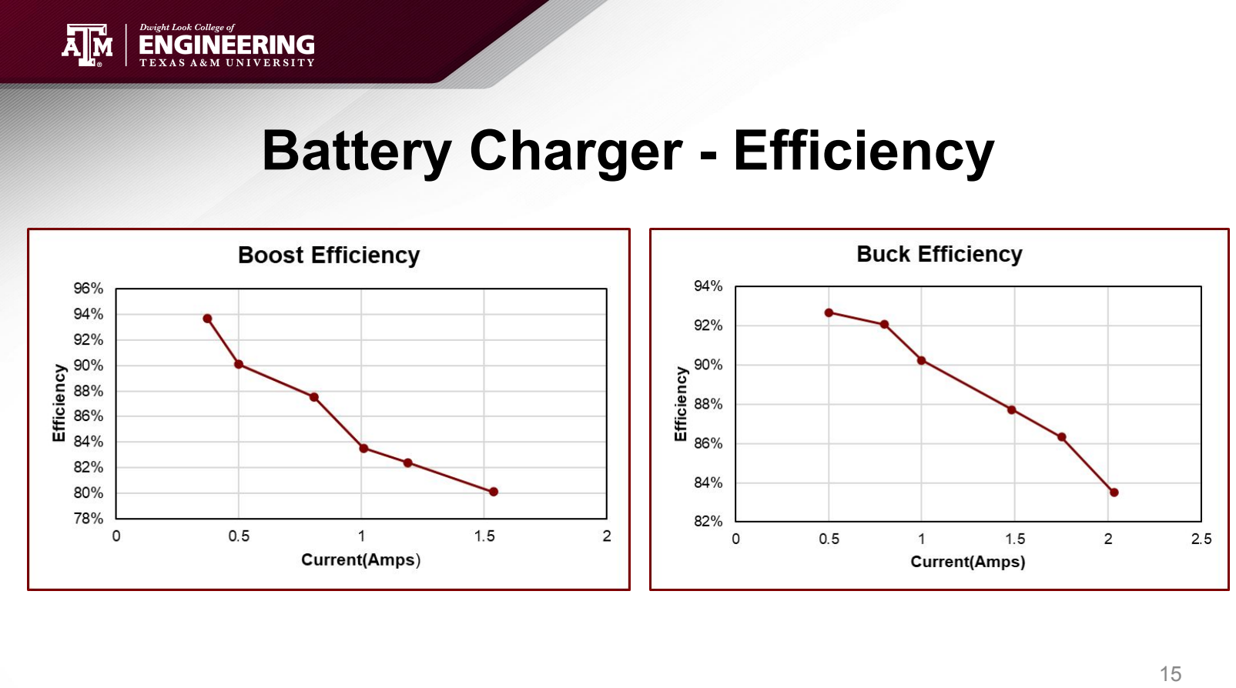
[picture p136: page 15]

# Battery Gauge


- Utilizes bq28z620 • Monitors voltage, current,

temperature, and calculates state-of-charge (SOC) for
Li-ion pack
- Configurable overvoltage (OV) and undervoltage (UV) thresholds to protect against faults
- Triggers fault flags (e.g., OV/UV, overcurrent) in
registers

# Battery Gauge Operation


Input 4V 3A | Input 2V 3A

# Battery Pack

# 1S3P configuration using Samsung INR18650 30Q

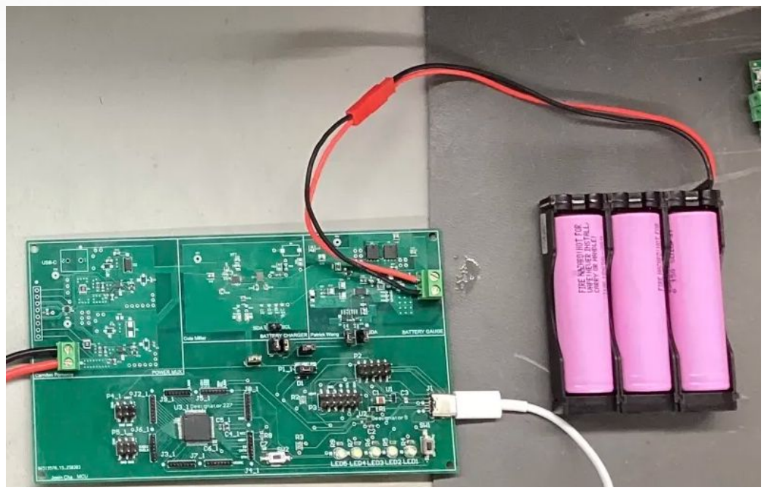
[picture p137: figure]

Type = Li-ion
Nominal voltage = 3.7V
Design capacity (1) = 3000mah Charge Voltage: 4.2V
Discharge Cut-off Voltage: 2.5V

# Battery Pack (charging)

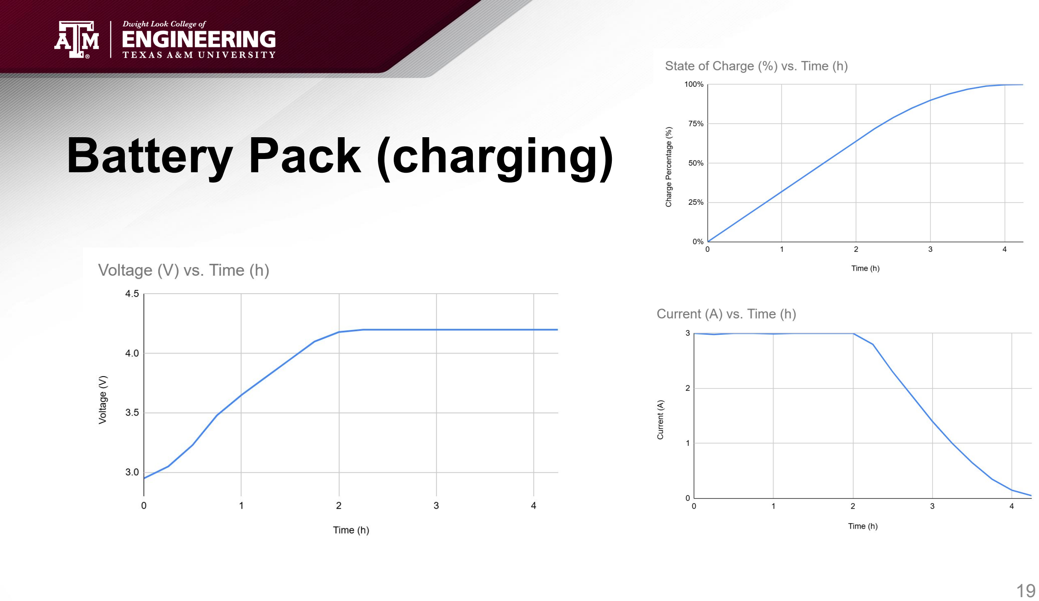
[picture p138: page 19]

# Battery Pack (discharging)

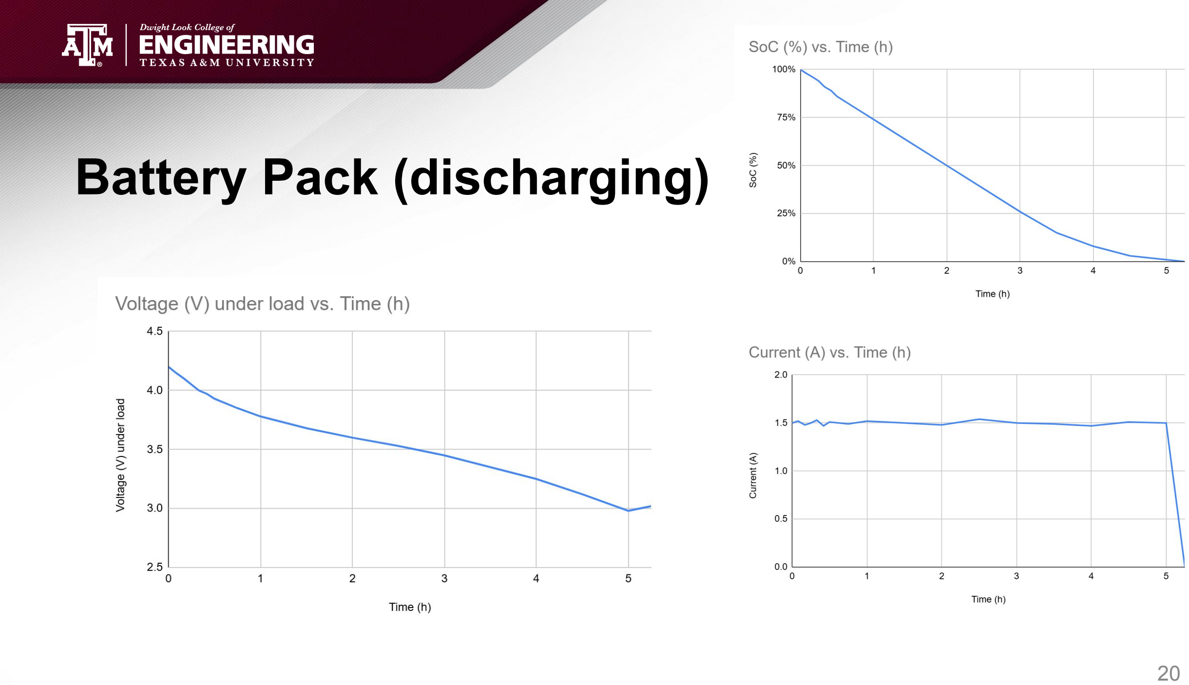
[picture p139: page 20]

# MCU


- Control unit -
integrates subsystems and firmware into one organized system
- MSPM0G3507 (LQFP 64 pin) • I2C Communication Inter-Integrated Circuit – Read/write register values for

subsystem control
- MPPT Maximum Power Point Tracking – To maximize power from

solar panel
- SOC display and SOC wake button

SOC: State of Charge

# MCU Firmware Flow Chart

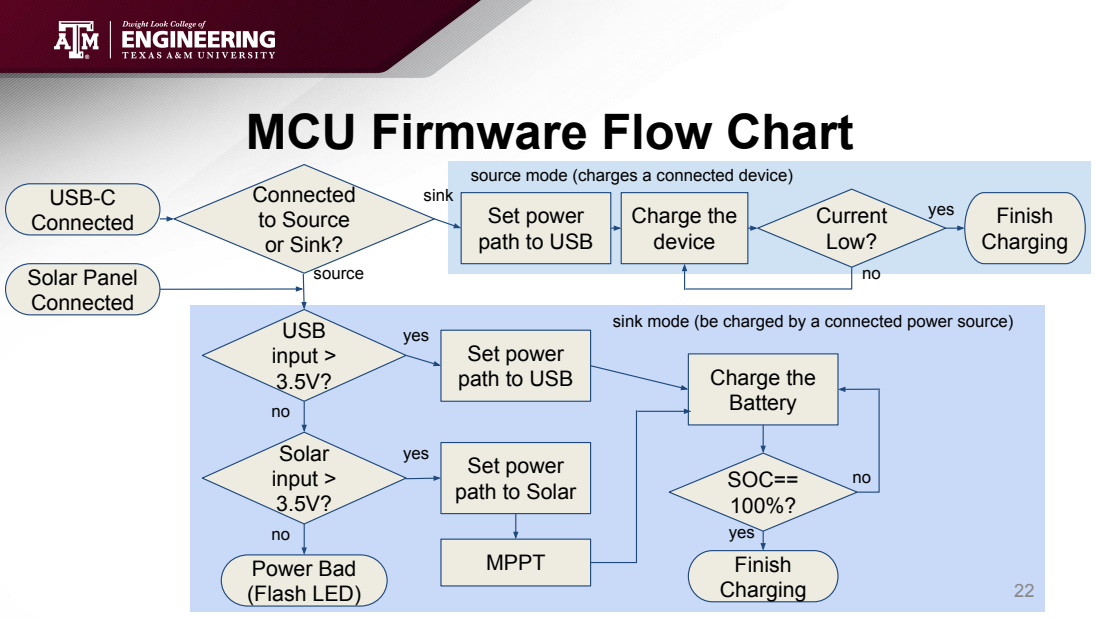
[picture p140: page 22]
USB-C Connected; Solar Panel Connected; Connected to Source or Sink?; Charge the device; source; USB input > 3.5V?; Solar input > 3.5V?; yes; Current Low?; Finish Charging; Set power; Power Bad (Flash LED); Charge the Battery; MPPT; SOC== 100%?

source mode (charges a connected device)
sink

Set power
path to USB

sink mode (be charged by a connected power source)

yes
path to Solar

# MCU Firmware Flow Chart

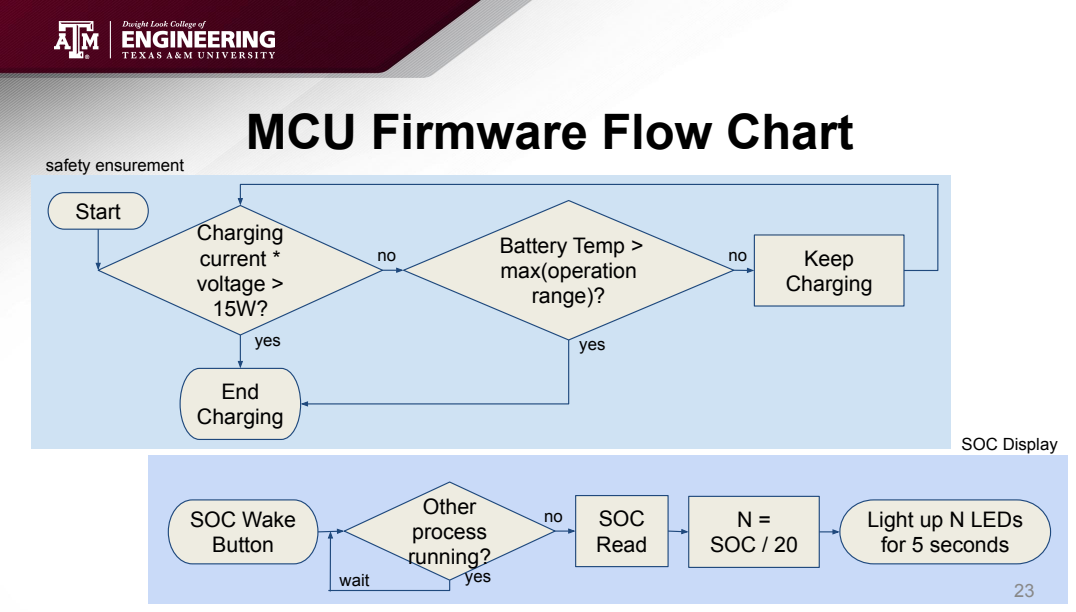
[picture p141: page 23]
Charging current * voltage > 15W?; safety ensurement; SOC Display; Battery Temp > max(operation range)?; End Charging; Keep Charging; yes; Other process running?; SOC Wake Button; SOC Read; N = SOC / 20; wait; Start

Light up N LEDs
for 5 seconds

# System Summary

- Utilizing a standard USB-C input of 5V 3A charging the batteries at 3.7 V will take 2 hours and 45 minutes.
- Utilizing the solar panel on a sunny day generating 7V 2A, charging the batteries at 3.7V will take approximately 3 hours.
- Utilizing the solar panel on a cloudy day generating 7V 0.5A, charging the batteries at 3.7V will take approximately 10.5 hours.
- Discharging the battery at 2A will take approximately 4 hours and 30 minutes
- Discharging the battery at 1.5A will take approximately 5 hours and 15 minutes
- Has capacity to fully charge 2.7 iphone 14s
- Devices consume 1.2795 mA during operation
- Devices consume 547.1 μA while asleep (monitoring battery)
- Devices consume 2.1 μA while off

# SYSTEM Validation Plan

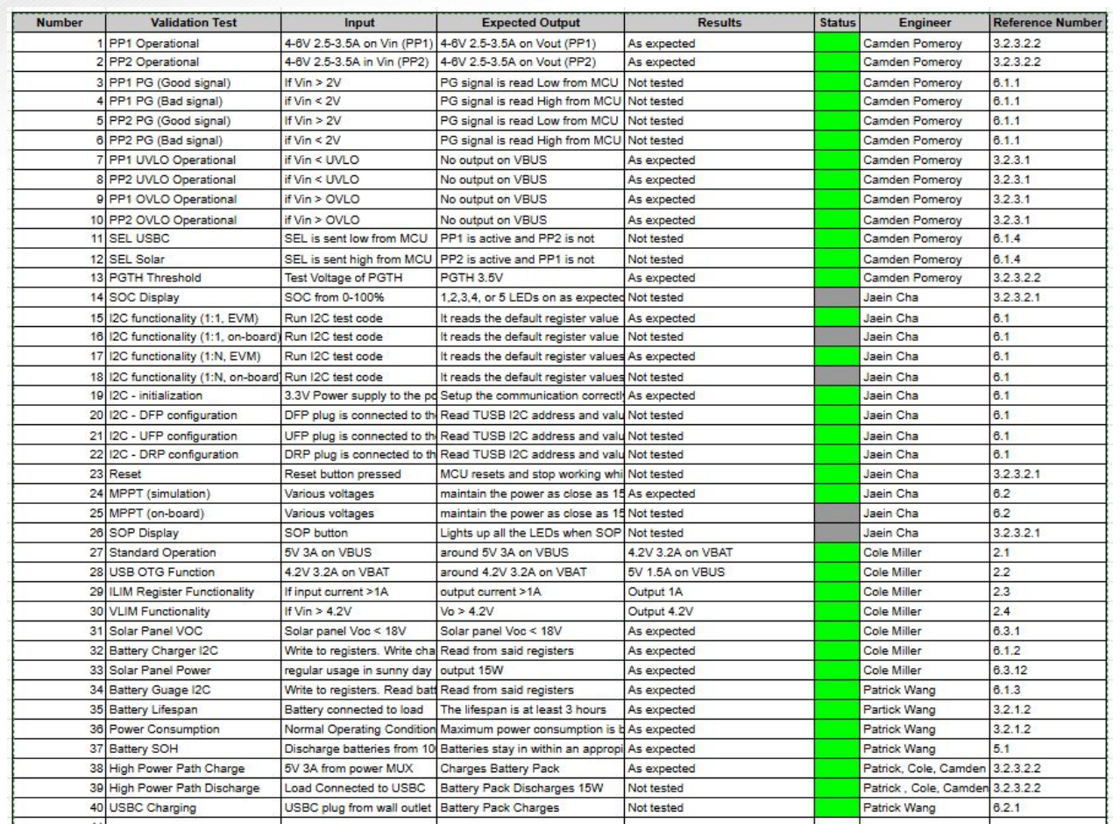
[picture p142: figure]

# Questions?
