jaeinCha/ECEN404-2025SP-TI-Solar-Battery-Pack/Pictures & Videos/Capstone Outline.png

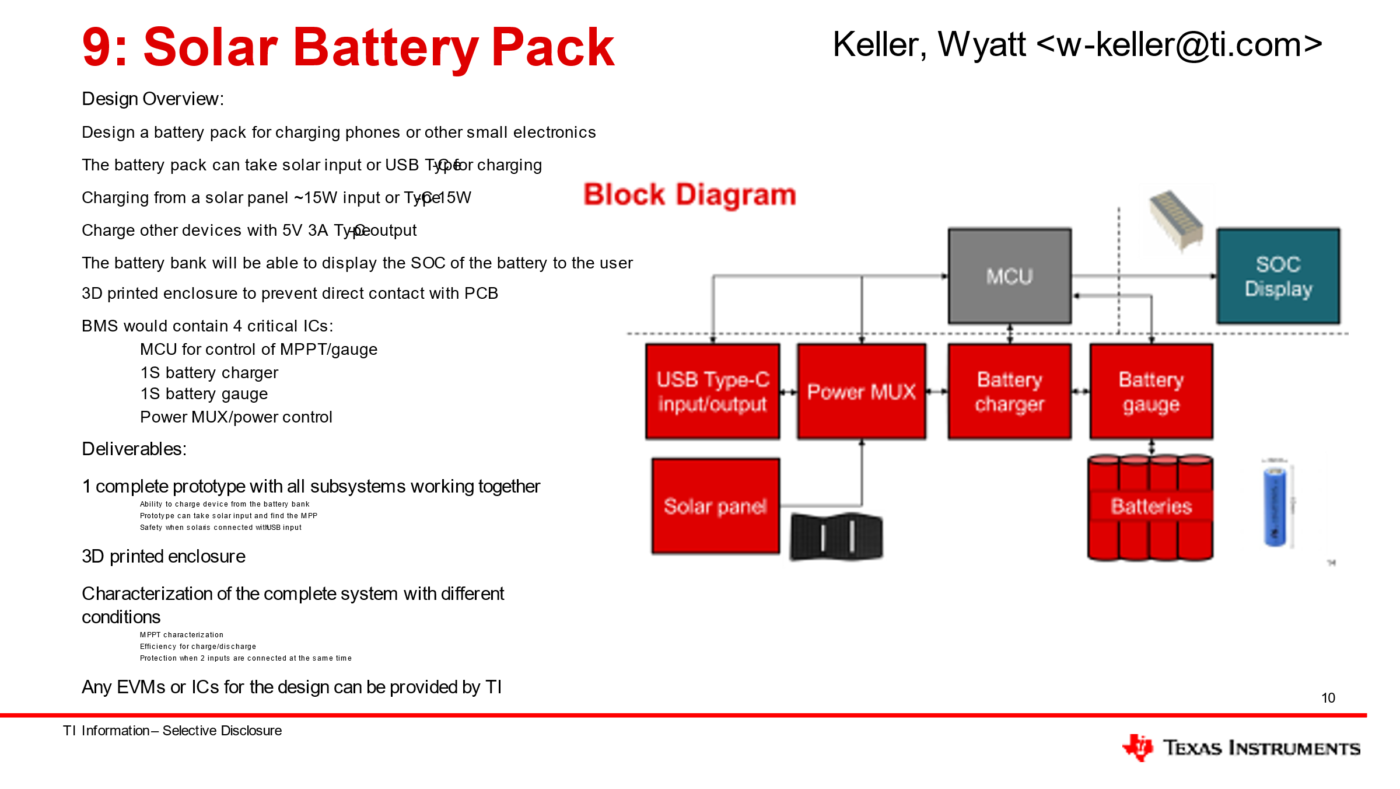
Pictures & Videos/Capstone Outline.png
