jaeinCha/ECEN404-2025SP-TI-Solar-Battery-Pack/Pictures & Videos/Power Mux Stage.jpg

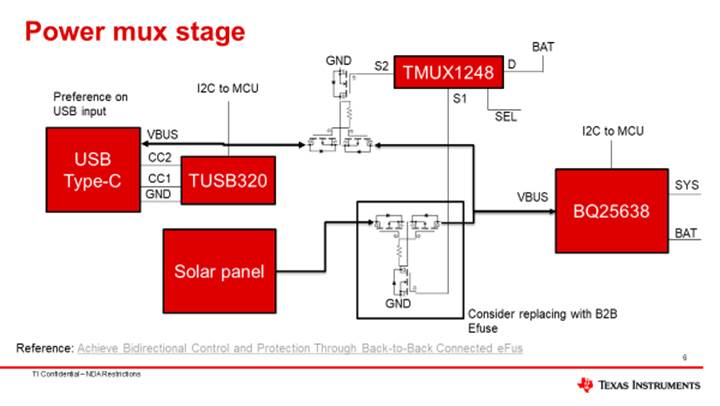
Pictures & Videos/Power Mux Stage.jpg
