jaeinCha/ECEN404-2025SP-TI-Solar-Battery-Pack/Sheets/BOM.xlsx

Sheet: Cole
Part Number | Quantity | Link | total | unit
GMK107AB7105KAHT | 2 | https://www.digikey.com/en/products/detail/taiyo-yuden/GMK107AB7105KAHT/4157322 | $0.30 | $0.15
CC0603KRX7R8BB473 | 10 | https://www.digikey.com/en/products/detail/yageo/CC0603KRX7R8BB473/2103111 | $0.31 | $0.03
GRM188D71A106KA73D | 4 | https://www.digikey.com/en/products/detail/murata-electronics/GRM188D71A106KA73D/6606090 | $1.44 | $0.36
CC0603KRX7R8BB104 | 10 | https://www.digikey.com/en/products/detail/yageo/CC0603KRX7R8BB104/2103079 | $0.35 | $0.04
GRT188R61E106ME13D | 3 | https://www.mouser.com/ProductDetail/Murata-Electronics/GRT188R61E106ME13D?qs=drgMNd%252BkGPNNTFaFP8SYQA%3D%3D | $0.96 | $0.32
CL21B475KOFNFNE | 3 | https://www.digikey.com/en/products/detail/samsung-electro-mechanics/CL21B475KOFNFNE/3888628 | $0.60 | $0.20
LTST-C190GKT | 10 | https://www.digikey.com/en/products/detail/liteon/LTST-C190GKT/269230 | $1.16 | $0.12
ED1202DS | 2 | https://www.digikey.com/en/products/detail/on-shore-technology-inc/ED120-2DS/33892 | $1.16 | $0.58
PEC08SAAN | 2 | https://www.digikey.com/en/products/detail/sullins-connector-solutions/PEC08SAAN/859161 | $1.58 | $0.79
OSTTA034163 | 1 | https://www.digikey.com/en/products/detail/on-shore-technology-inc/OSTTA034163/614530 | $1.26 | $1.26
PEC02SAAN | 10 | https://www.digikey.com/en/products/detail/sullins-connector-solutions/PEC02SAAN/859155 | $3.64 | $0.36
SRP3212-1R0M | 5 | https://www.mouser.com/ProductDetail/Bourns/SRP3212-1R0M?qs=t7xnP681wgVwh6hWpVPUMg%3D%3D | $1.20 | $0.24
WSL2010R0100FEA18 | 4 | https://www.digikey.com/en/products/detail/vishay-dale/WSL2010R0100FEA18/712518 | $7.92 | $1.98
CRCW040210K0FKEDHP | 10 | https://www.digikey.com/en/products/detail/vishay-dale/CRCW040210K0FKEDHP/2222530 | $0.54 | $0.05
CRCW0603430RFKEA | 10 | https://www.digikey.com/en/products/detail/vishay-dale/CRCW0603430RFKEA/1174625 | $0.27 | $0.03
RC0603FR-075K23L | 10 | https://www.digikey.com/en/products/detail/yageo/RC0603FR-075K23L/727272 | $0.12 | $0.01
RMCF0603FT30K1 | 10 | https://www.digikey.com/en/products/detail/stackpole-electronics-inc/RMCF0603FT30K1/1760864 | $0.15 | $0.01
5002 | 10 | https://www.digikey.com/en/products/detail/keystone-electronics/5002/255328 | $4.10 | $0.41
BQ25622RYKR | 1 | https://www.digikey.com/en/products/detail/texas-instruments/BQ25622RYKR/17878421 | $3.47000 | $3.47
P110 | 2 | https://www.digikey.com/en/products/detail/voltaic-systems/P110/12154976 | $130 | $65.00 | <-temp removed from BOM
SNT-100-BK-G | 10 | https://www.digikey.com/en/products/detail/samtec-inc/SNT-100-BK-G/1756763 | $3.10 | $0.31
 |  |  | $30.16

Sheet: Patrick
Part Number | Item name | Cost (each) | Quantity | Total cost | Link
Battery Leads Holder | Battery Holder | $4.99 | 1 | $4.99 | https://www.amazon.com/18650-Battery-Batteries-Parallel-Projects/dp/B0972YP22H
Samsung 25R 18650 | batteries | $2.75 | 3 | $8.25 | https://www.18650batterystore.com/products/samsung-25r-18650
BQ28z620 | IC | $1.55 | 3 | $4.65 | https://www.ti.com/product/BQ28Z620?ds_k=DYNAMIC+SEARCH+ADS&DCM=yes&gad_source=1&gclsrc=aw.ds
691210910004 | connector | $1.95 | 1 | $1.95 | https://www.digikey.com/en/products/detail/w%C3%BCrth-elektronik/691210910004/11477505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
MFR-25FBF52-100R | resistor | $0.10 | 7 | $0.70 | https://www.digikey.com/en/products/detail/yageo/MFR-25FBF52-100R/12795
MM3Z5V6C | DIODE | $0.13 | 2 | $0.26 | https://www.digikey.com/en/products/detail/onsemi/MM3Z5V6C/1626786
MFR-25FBF52-1M | resistor | $0.10 | 1 | $0.10 | https://www.digikey.com/en/products/detail/yageo/MFR-25FBF52-1M/13714
NCP21XV103J03RA | thermistor | $0.20 | 1 | $0.20 | https://www.digikey.com/en/products/detail/murata-electronics/NCP21XV103J03RA/588477
MRS25000C1002FCT00 | resistor | $0.30 | 1 | $0.30 | https://www.digikey.com/en/products/detail/vishay-beyschlag-draloric-bc-components/MRS25000C1002FCT00/5063978
RC0805JR-0720ML | resistor | $0.15 | 4 | $0.60 | https://www.digikey.com/en/products/detail/yageo/RC0805JR-0720ML/5919059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
PR01000101009JR500 | resistor | $0.41 | 2 | $0.82 | https://www.digikey.com/en/products/detail/vishay-beyschlag-draloric-bc-components/PR01000101009JR500/595972
MFR-12FTF52-5K1 | resistor | $0.10 | 2 | $0.20 | https://www.digikey.com/en/products/detail/yageo/MFR-12FTF52-5K1/9134244
691137710002 | connector | $0.40 | 1 | $0.40 | https://www.digikey.com/en/products/detail/w%C3%BCrth-elektronik/691137710002/6644051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
0685T5000-01 | fuse | $0.35 | 3 | $1.05 | https://www.digikey.com/en/products/detail/bel-fuse-inc/0685T5000-01/5466711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
CSD16412Q5A | NMOS | $1.06 | 2 | $2.12 | https://www.digikey.com/en/products/detail/texas-instruments/CSD16412Q5A/2038311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
2N7002K-7 | NMOS | $0.13 | 1 | $0.13 | https://www.digikey.com/en/products/detail/diodes-incorporated/2N7002K-7/1934378
KGM21NR71H104KT | capacitor | $0.10 | 8 | $0.80 | https://www.digikey.com/en/products/detail/kyocera-avx/KGM21NR71H104KT/563505
0805ZD225KAT2A | capacitor | $0.25 | 1 | $0.25 | https://www.digikey.com/en/products/detail/kyocera-avx/0805ZD225KAT2A/563523
ERJ-8BWFR010V | sense resistor | $0.65 | 1 |  | https://www.mouser.com/ProductDetail/Panasonic/ERJ-8BWFR010V?qs=KH2o3k57UShEa4%252B9X5Zg1Q%3D%3D
 |  |  |  | $27.77

Sheet: Camden
Order Date | Part Number | Item Name | Laction to Buy From | Cost per Quanity | Quanity | Total Cost
2024-10-21 | MMSZ4692T1G | Zenner Diode | https://www.digikey.com/en/products/detail/onsemi/MMSZ4692T1G/1749039 | 0.069 | 10 | 0.69 | dont need
2024-10-21 | B240A-13-F | Schottky Diode | https://www.digikey.com/en/products/detail/diodes-incorporated/B240A-13-F/717691 | 0.32 | 4 | 1.28 | dont need | My new parts needed
2024-10-21 | CC0603KRX7R7BB105 | Capacitor (1 uF) | https://www.digikey.com/en/products/detail/yageo/CC0603KRX7R7BB105/2833611 | 0.071 | 10 | 0.71 | dont need
2024-10-21 | GRM1885C1H272JA01D | Capacitor (2.7 nF) | https://www.digikey.com/en/products/detail/murata-electronics/GRM1885C1H272JA01D/702547 | 0.046 | 10 | 0.46 | yes | GRM1885C1H272JA01D | Capacitor (2.7 nF) | https://www.mouser.com/ProductDetail/Murata-Electronics/GRM1885C1H272JA01D?qs=%2FEhSLMV8HUQlL5ZggNQk6g%3D%3D | 0.05 | 10 | 0.5
2024-10-21 | GRM2195C1H752JA01D | Capacitor (7.5 nF) | https://www.digikey.com/en/products/detail/murata-electronics/GRM2195C1H752JA01D/586782 | 0.129 | 10 | 1.29 |  | GRM2195C1H752JA01D | Capacitor (7.5 nF) | https://www.mouser.com/ProductDetail/Murata-Electronics/GRM2195C1H752JA01D?qs=3Vu9ppaVHS6q11SGVh%2FV8g%3D%3D | 0.11 | 10 | 1.1
2024-10-21 | ERJ-6GEYJ474V | Resistor (470k) | https://www.digikey.com/en/products/detail/panasonic-electronic-components/ERJ-6GEYJ474V/83142 | 0.039 | 10 | 0.39 |  | ERJ-6GEYJ474V | Resistor (470k) | https://www.mouser.com/ProductDetail/Panasonic/ERJ-6GEYJ474V?qs=YMBIwoNQYdUCy4oWeQgeIw%3D%3D | 0.025 | 10 | 0.25
2024-10-21 | RC0805FR-07100KL | Resistor (100k) | https://www.digikey.com/en/products/detail/yageo/RC0805FR-07100KL/727544 | 0.016 | 10 | 0.16 |  | RC0805FR-07100KL | Resistor (100k) | https://www.mouser.com/ProductDetail/YAGEO/RC0805FR-07100KL?qs=8Y8p%252BasKcI7rEWn6FcVdAA%3D%3D | 0.14 | 10 | 1.4
2024-10-21 | RC0603FR-0747KL | Resistor (47k) | https://www.digikey.com/en/products/detail/yageo/RC0603FR-0747KL/727253 | 0.013 | 10 | 0.13 |  | RC0603FR-0747KL | Resistor (47k) | https://www.mouser.com/ProductDetail/YAGEO/RC0603FR-0747KL?qs=gt6vzsuosg3jXzmCiDCCdg%3D%3D | 0.007 | 10 | 0.07
2024-10-21 | RC0805FR-0720K5L | Resistor (20.5k) | https://www.digikey.com/en/products/detail/yageo/RC0805FR-0720K5L/727722 | 0.016 | 10 | 0.16 |  | RC0805FR-0720K5L | Resistor (20.5k) | https://www.mouser.com/ProductDetail/YAGEO/RC0805FR-0720K5L?qs=QrWOOBGzeCZ%252BXTGCLt8vFg%3D%3D | 0.012 | 10 | 0.12
2024-10-21 | CRCW0805866RFKEA | Resistor (866) | https://www.digikey.com/en/products/detail/vishay-dale/CRCW0805866RFKEA/1175630 | 0.039 | 10 | 0.39 | yes | CRCW0805866RFKEA | Resistor (866) | https://www.mouser.com/ProductDetail/Vishay-Dale/CRCW0805866RFKEA?qs=gFq8Ja42mL5y9BwvIQrGGg%3D%3D | 0.025 | 10 | 0.25
2024-10-21 | CSRT0603FT5R00 | Resistor (5) | https://www.digikey.com/en/products/detail/stackpole-electronics-inc/CSRT0603FT5R00/16204542 | 0.21 | 10 | 2.1 | Dont need
2024-10-21 | RMCF1210JT10K0 | Resistor (10k) | https://www.digikey.com/en/products/detail/stackpole-electronics-inc/RMCF1210JT10K0/1757294 | 0.056 | 10 | 0.56 |  | RMCF1210JT10K0 | Resistor (10k) | https://www.mouser.com/ProductDetail/SEI-Stackpole/RMCF1210JT10K0?qs=IPgv5n7u5QZextIiufaxPA%3D%3D | 0.037 | 10 | 0.37
2024-10-21 | PEC08SAAN | 8 pin Header Pins | https://www.digikey.com/en/products/detail/sullins-connector-solutions/PEC08SAAN/859161 | 0.79 | 4 | 3.16 | no
2024-10-21 | 282836-2 | 2 Pin Terminal Block | https://www.digikey.com/en/products/detail/te-connectivity-amp-connectors/282836-2/1826939 | 0.69 | 6 | 4.14 |  | 282836-2 | 2 Pin Terminal Block | https://www.mouser.com/ProductDetail/TE-Connectivity/282836-2?qs=A%252Bip%252BNCYi6Ohx9vaQ1l4dg%3D%3D | 0.432 | 6 | 2.592
2024-10-21 | TPS259460ARPWR | TI eFuse | https://www.ti.com/product/EN-US/TPS25946/part-details/TPS259460ARPWR | 1.087 | 6 | 6.522 | have 7 | TPS259460ARPWR | TI eFuse | https://www.mouser.com/ProductDetail/595-TPS259460ARPWR | 0.921 | 6 | 5.526
2024-10-21 | TMUX1248DCKR | TI MUX | https://www.ti.com/product/EN-US/TMUX1248/part-details/TMUX1248DCKR | 0.488 | 5 | 2.44 |  | TMUX1248DCKR | TI MUX | https://www.mouser.com/ProductDetail/Texas-Instruments/TMUX1248DCKR?qs=QNEnbhJQKvba99NaGQ0qVA%3D%3D | 0.387 | 5 | 1.935
 |  |  |  |  |  |  |  | 1772-1229-ND | Standoffs | https://www.digikey.com/en/products/detail/raf-electronic-hardware/2100-632-AL/7680640 | 0.173 | 10 | 1.73
 |  |  |  |  |  | 24.582

Sheet: Jaein
Part Number | Component Type | Quantity | Link to the prooduct | Total Price |  | Total for Order | Quantity
USB4125-GF-A-0190 | USB C Port | 3 | https://www.digikey.com/en/products/detail/gct/USB4125-GF-A-0190/14559040?gad_source=1 | $2.40 |  |  | 3 (1)
FSMSM | Push Button | 3 | https://www.digikey.com/en/products/detail/te-connectivity-alcoswitch-switches/FSMSM/525812 | $1.11 |  |  | 3 (2)
RG2012P-204-B-T5 | Resistor | 10 | https://www.digikey.com/en/products/detail/susumu/RG2012P-204-B-T5/1212680 | $1.54 |  |  | 10 (2)
RT1206BRE07900KL | Resistor | 10 | https://www.digikey.com/en/products/detail/yageo/RT1206BRE07900KL/5936985 | $2.69 |  |  | 10 (1)
GRMJN65C1H104GE01J | Capacitor | 10 | https://www.digikey.com/en/products/detail/murata-electronics/GRMJN65C1H104GE01J/19115548 | $4.10 |  |  | 10 (2)
CC0805JKX7R9BB105 | Capacitor | 10 | https://www.digikey.com/en/products/detail/yageo/CC0805JKX7R9BB105/7164382 | $1.78 |  |  | 10 (1)
61300311121 | Pin Header (3) | 10 | https://www.digikey.com/en/products/detail/w%C3%BCrth-elektronik/61300311121/4846825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 | $1.13 |  |  | 10 (3)
61001221121 | Pin Header (12) | 1 | https://www.digikey.com/en/products/detail/w%C3%BCrth-elektronik/61001221121/4846969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 | $2.49 |  |  | 1 (1)
61001021121 | Pin Header (10) | 1 | https://www.digikey.com/en/products/detail/w%C3%BCrth-elektronik/61001021121/4846968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 | $2.01 |  |  | 1 (1)
61301421121 | Pin Header (14) | 2 | https://www.digikey.com/en/products/detail/w%C3%BCrth-elektronik/61301421121/4846851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 | $1.92 |  |  | 2 (2)
61000621121 | Pin Header (6) | 2 | https://www.digikey.com/en/products/detail/w%C3%BCrth-elektronik/61000621121/4846966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 | $2.10 |  |  | 2 (2)
LTW-420D7 | LED (TH) | 10 | https://www.digikey.com/en/products/detail/liteon/LTW-420D7/1835514 | $3.84 |  |  | 10 (5)
ERA-6AEB271V | Resistor | 10 | https://www.digikey.com/en/products/detail/panasonic-electronic-components/ERA-6AEB271V/1465734 | $1.01 |  |  | 10 (2)
ERA-6AEB331V | Resistor | 10 | https://www.digikey.com/en/products/detail/panasonic-electronic-components/ERA-6AEB331V/1465736 | $1.01 |  |  | 10 (5)
ERA-6AEB472V | Resistor | 10 | https://www.digikey.com/en/products/detail/panasonic-electronic-components/ERA-6AEB472V/1465765 | $1.01 |  |  | 10 (4)
ERA-6AEB222V | Resistor | 10 | https://www.digikey.com/en/products/detail/panasonic-electronic-components/ERA-6AEB222V/1465757 | $1.01 |  |  | 10 (2)
ERA-6AEB473V | Resistor | 10 | https://www.digikey.com/en/products/detail/panasonic-electronic-components/ERA-6AEB473V/1465789 | $1.01 |  |  | 10 (1)
C0805C106J8RACAUTO | Capacitor | 10 | https://www.digikey.com/en/products/detail/kemet/C0805C106J8RACAUTO/7427523 | $5.94 |  |  | 10 (1)
C0603C103J5RACTU | Capacitor | 10 | https://www.digikey.com/en/products/detail/kemet/C0603C103J5RACTU/411091 | $0.34 | -might be small |  | 10 (1)
C0603C474J4RAC7867 | Capacitor | 10 | https://www.digikey.com/en/products/detail/kemet/C0603C474J4RAC7867/3316992 | $2.91 | - might be small |  | 10 (1)
TUSB320IRWBR | IC - USBC Port Ctrl | 10 | https://www.digikey.com/en/products/detail/texas-instruments/TUSB320IRWBR/5297639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 | $12.47 |  | $53.82 | 10 (1)

Sheet: Total
Order Date | Part Number | Item Name | Laction to Buy From | Cost per Quanity | Quanity | Total Cost
2024-10-24 | MMSZ4692T1G | Zenner Diode | https://www.digikey.com/en/products/detail/onsemi/MMSZ4692T1G/1749039 | 0.069 | 10 | 0.69
2024-10-24 | B240A-13-F | Schottky Diode | https://www.digikey.com/en/products/detail/diodes-incorporated/B240A-13-F/717691 | 0.32 | 4 | 1.28
2024-10-24 | CC0603KRX7R7BB105 | Capacitor (1 uF) | https://www.digikey.com/en/products/detail/yageo/CC0603KRX7R7BB105/2833611 | 0.071 | 10 | 0.71
2024-10-24 | GRM1885C1H272JA01D | Capacitor (2.7 nF) | https://www.digikey.com/en/products/detail/murata-electronics/GRM1885C1H272JA01D/702547 | 0.046 | 10 | 0.46
2024-10-24 | GRM2195C1H752JA01D | Capacitor (7.5 nF) | https://www.digikey.com/en/products/detail/murata-electronics/GRM2195C1H752JA01D/586782 | 0.129 | 10 | 1.29
2024-10-24 | ERJ-6GEYJ474V | Resistor (470k) | https://www.digikey.com/en/products/detail/panasonic-electronic-components/ERJ-6GEYJ474V/83142 | 0.039 | 10 | 0.39
2024-10-24 | RC0805FR-0782K5L | Resistor (82.5k) | https://www.digikey.com/en/products/detail/yageo/RC0805FR-0782K5L/728167 | 0.016 | 10 | 0.16
2024-10-24 | RC0603FR-0747KL | Resistor (47k) | https://www.digikey.com/en/products/detail/yageo/RC0603FR-0747KL/727253 | 0.013 | 10 | 0.13
2024-10-24 | RC0805FR-0720K5L | Resistor (20.5k) | https://www.digikey.com/en/products/detail/yageo/RC0805FR-0720K5L/727722 | 0.016 | 10 | 0.16
2024-10-24 | CRCW0805866RFKEA | Resistor (866) | https://www.digikey.com/en/products/detail/vishay-dale/CRCW0805866RFKEA/1175630 | 0.039 | 10 | 0.39
2024-10-24 | CSRT0603FT5R00 | Resistor (5) | https://www.digikey.com/en/products/detail/stackpole-electronics-inc/CSRT0603FT5R00/16204542 | 0.21 | 10 | 2.1
2024-10-24 | RMCF1210JT10K0 | Resistor (10k) | https://www.digikey.com/en/products/detail/stackpole-electronics-inc/RMCF1210JT10K0/1757294 | 0.056 | 10 | 0.56
2024-10-24 | PEC08SAAN | 8 pin Header Pins | https://www.digikey.com/en/products/detail/sullins-connector-solutions/PEC08SAAN/859161 | 0.79 | 4 | 3.16
2024-10-24 | 282836-2 | 2 Pin Terminal Block | https://www.digikey.com/en/products/detail/te-connectivity-amp-connectors/282836-2/1826939 | 0.69 | 6 | 4.14
2024-10-24 | TPS259460ARPWR | TI eFuse | https://www.mouser.com/ProductDetail/Texas-Instruments/TPS259460ARPWR?qs=TuK3vfAjtkWfsNpxJPS8Ng%3D%3D | 1.47 | 6 | 8.82
2024-10-24 | TMUX1248DCKR | TI MUX | https://www.mouser.com/ProductDetail/Texas-Instruments/TMUX1248DCKR?qs=QNEnbhJQKvba99NaGQ0qVA%3D%3D | 0.379 | 10 | 3.79
2024-10-24 | GMK107AB7105KAHT | Capacitor | https://www.digikey.com/en/products/detail/taiyo-yuden/GMK107AB7105KAHT/4157322 | 0.15 | 2 | $0.30
2024-10-24 | CC0603KRX7R8BB473 | Capacitor | https://www.digikey.com/en/products/detail/yageo/CC0603KRX7R8BB473/2103111 | 0.031 | 10 | $0.31
2024-10-24 | GRM188D71A106KA73D | Capacitor | https://www.digikey.com/en/products/detail/murata-electronics/GRM188D71A106KA73D/6606090 | 0.36 | 4 | $1.44
2024-10-24 | CC0603KRX7R8BB104 | Capacitor | https://www.digikey.com/en/products/detail/yageo/CC0603KRX7R8BB104/2103079 | 0.035 | 10 | $0.35
2024-10-24 | GRT188R61E106ME13D | Capacitor | https://www.mouser.com/ProductDetail/Murata-Electronics/GRT188R61E106ME13D?qs=drgMNd%252BkGPNNTFaFP8SYQA%3D%3D | 0.32 | 3 | $0.96
2024-10-24 | CL21B475KOFNFNE | Capacitor | https://www.digikey.com/en/products/detail/samsung-electro-mechanics/CL21B475KOFNFNE/3888628 | 0.2 | 3 | $0.60
2024-10-24 | LTST-C190GKT | LED | https://www.digikey.com/en/products/detail/liteon/LTST-C190GKT/269230 | 0.116 | 10 | $1.16
2024-10-24 | ED1202DS | Resistor | https://www.digikey.com/en/products/detail/on-shore-technology-inc/ED120-2DS/33892 | 0.58 | 2 | $1.16
2024-10-24 | PEC08SAAN | 8 pin header | https://www.digikey.com/en/products/detail/sullins-connector-solutions/PEC08SAAN/859161 | 0.79 | 2 | $1.58
2024-10-24 | OSTTA034163 | 3 pin terminal block | https://www.digikey.com/en/products/detail/on-shore-technology-inc/OSTTA034163/614530 | 1.26 | 1 | $1.26
2024-10-24 | PEC02SAAN | 2 pin header | https://www.digikey.com/en/products/detail/sullins-connector-solutions/PEC02SAAN/859155 | 0.364 | 10 | $3.64
2024-10-24 | SRP3212-1R0M | Power Inudctor | https://www.mouser.com/ProductDetail/Bourns/SRP3212-1R0M?qs=t7xnP681wgVwh6hWpVPUMg%3D%3D | 0.24 | 5 | $1.20
2024-10-24 | WSL2010R0100FEA18 | Resistor | https://www.digikey.com/en/products/detail/vishay-dale/WSL2010R0100FEA18/712518 | 1.98 | 4 | $7.92
2024-10-24 | CRCW040210K0FKEDHP | Resistor | https://www.digikey.com/en/products/detail/vishay-dale/CRCW040210K0FKEDHP/2222530 | 0.054 | 10 | $0.54
2024-10-24 | CRCW0603430RFKEA | Resistor | https://www.digikey.com/en/products/detail/vishay-dale/CRCW0603430RFKEA/1174625 | 0.027 | 10 | $0.27
2024-10-24 | RC0603FR-075K23L | Resistor | https://www.digikey.com/en/products/detail/yageo/RC0603FR-075K23L/727272 | 0.012 | 10 | $0.12
2024-10-24 | RMCF0603FT30K1 | Resistor | https://www.digikey.com/en/products/detail/stackpole-electronics-inc/RMCF0603FT30K1/1760864 | 0.015 | 10 | $0.15
2024-10-24 | 5002 | Test Point | https://www.digikey.com/en/products/detail/keystone-electronics/5002/255328 | 0.41 | 10 | $4.10
2024-10-24 | BQ25622RYKR | TI Battery Charger | https://www.digikey.com/en/products/detail/texas-instruments/BQ25622RYKR/17878421 | 3.47 | 1 | $3.47000
2024-10-24 | SNT-100-BK-G | 2 pin Shunt Connector | https://www.digikey.com/en/products/detail/samtec-inc/SNT-100-BK-G/1756763 | 0.31 | 10 | $3.10
2024-10-24 | USB4125-GF-A-0190 | USB C Port | https://www.digikey.com/en/products/detail/gct/USB4125-GF-A-0190/14559040?gad_source=1 | $0.80 | 3 | $2.40
2024-10-24 | FSMSM | Push Button | https://www.digikey.com/en/products/detail/te-connectivity-alcoswitch-switches/FSMSM/525812 | $0.37 | 3 | $1.11
2024-10-24 | RG2012P-204-B-T5 | Resistor | https://www.digikey.com/en/products/detail/susumu/RG2012P-204-B-T5/1212680 | $0.15 | 10 | $1.54
2024-10-24 | RT1206BRE07900KL | Resistor | https://www.digikey.com/en/products/detail/yageo/RT1206BRE07900KL/5936985 | $0.27 | 10 | $2.69
2024-10-24 | GRMJN65C1H104GE01J | Capacitor | https://www.digikey.com/en/products/detail/murata-electronics/GRMJN65C1H104GE01J/19115548 | $0.41 | 10 | $4.10
2024-10-24 | CC0805JKX7R9BB105 | Capacitor | https://www.digikey.com/en/products/detail/yageo/CC0805JKX7R9BB105/7164382 | $0.18 | 10 | $1.78
2024-10-24 | 61300311121 | Pin Header (3) | https://www.digikey.com/en/products/detail/w%C3%BCrth-elektronik/61300311121/4846825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 | $0.11 | 10 | $1.13
2024-10-24 | 61001221121 | Pin Header (12) | https://www.digikey.com/en/products/detail/w%C3%BCrth-elektronik/61001221121/4846969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 | $2.49 | 1 | $2.49
2024-10-24 | 61001021121 | Pin Header (10) | https://www.digikey.com/en/products/detail/w%C3%BCrth-elektronik/61001021121/4846968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 | $2.01 | 1 | $2.01
2024-10-24 | 61301421121 | Pin Header (14) | https://www.digikey.com/en/products/detail/w%C3%BCrth-elektronik/61301421121/4846851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 | $0.96 | 2 | $1.92
2024-10-24 | 61000621121 | Pin Header (6) | https://www.digikey.com/en/products/detail/w%C3%BCrth-elektronik/61000621121/4846966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 | $1.05 | 2 | $2.10
2024-10-24 | LTW-420D7 | LED (TH) | https://www.digikey.com/en/products/detail/liteon/LTW-420D7/1835514 | $0.38 | 10 | $3.84
2024-10-24 | ERA-6AEB271V | Resistor | https://www.digikey.com/en/products/detail/panasonic-electronic-components/ERA-6AEB271V/1465734 | $0.10 | 10 | $1.01
2024-10-24 | ERA-6AEB331V | Resistor | https://www.digikey.com/en/products/detail/panasonic-electronic-components/ERA-6AEB331V/1465736 | $0.10 | 10 | $1.01
2024-10-24 | ERA-6AEB472V | Resistor | https://www.digikey.com/en/products/detail/panasonic-electronic-components/ERA-6AEB472V/1465765 | $0.10 | 10 | $1.01
2024-10-24 | ERA-6AEB222V | Resistor | https://www.digikey.com/en/products/detail/panasonic-electronic-components/ERA-6AEB222V/1465757 | $0.10 | 10 | $1.01
2024-10-24 | ERA-6AEB473V | Resistor | https://www.digikey.com/en/products/detail/panasonic-electronic-components/ERA-6AEB473V/1465789 | $0.10 | 10 | $1.01
2024-10-24 | C0805C106J8RACAUTO | Capacitor | https://www.digikey.com/en/products/detail/kemet/C0805C106J8RACAUTO/7427523 | $0.59 | 10 | $5.94
2024-10-24 | C0603C103J5RACTU | Capacitor | https://www.digikey.com/en/products/detail/kemet/C0603C103J5RACTU/411091 | $0.03 | 10 | $0.34
2024-10-24 | C0603C474J4RAC7867 | Capacitor | https://www.digikey.com/en/products/detail/kemet/C0603C474J4RAC7867/3316992 | $0.29 | 10 | $2.91
2024-10-24 | TUSB320IRWBR | IC - USBC Port Ctrl | https://www.digikey.com/en/products/detail/texas-instruments/TUSB320IRWBR/5297639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 | $1.25 | 10 | $12.47
2024-10-24 | Battery Leads Holder | Battery Holder | https://www.amazon.com/18650-Battery-Batteries-Parallel-Projects/dp/B0972YP22H | $4.99 | 1 | $4.99
2024-10-24 | Samsung 25R 18650 | batteries | https://www.18650batterystore.com/products/samsung-25r-18650 | $2.75 | 3 | $8.25
2024-10-24 | BQ28z620 | IC | https://www.ti.com/product/BQ28Z620?ds_k=DYNAMIC+SEARCH+ADS&DCM=yes&gad_source=1&gclsrc=aw.ds | $4.25 | 3 | $12.75
2024-10-24 | 691210910004 | connector | https://www.digikey.com/en/products/detail/w%C3%BCrth-elektronik/691210910004/11477505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 | $1.95 | 1 | $1.95
2024-10-24 | MFR-25FBF52-100R | resistor | https://www.digikey.com/en/products/detail/yageo/MFR-25FBF52-100R/12795 | $0.10 | 7 | $0.70
2024-10-24 | MM3Z5V6C | DIODE | https://www.digikey.com/en/products/detail/onsemi/MM3Z5V6C/1626786 | $0.13 | 2 | $0.26
2024-10-24 | MFR-25FBF52-1M | resistor | https://www.digikey.com/en/products/detail/yageo/MFR-25FBF52-1M/13714 | $0.10 | 1 | $0.10
2024-10-24 | NCP21XV103J03RA | thermistor | https://www.digikey.com/en/products/detail/murata-electronics/NCP21XV103J03RA/588477 | $0.20 | 1 | $0.20
2024-10-24 | MRS25000C1002FCT00 | resistor | https://www.digikey.com/en/products/detail/vishay-beyschlag-draloric-bc-components/MRS25000C1002FCT00/5063978 | $0.30 | 1 | $0.30
2024-10-24 | RC0805JR-0720ML | resistor | https://www.digikey.com/en/products/detail/yageo/RC0805JR-0720ML/5919059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 | $0.15 | 4 | $0.60
2024-10-24 | PR01000101009JR500 | resistor | https://www.digikey.com/en/products/detail/vishay-beyschlag-draloric-bc-components/PR01000101009JR500/595972 | $0.41 | 2 | $0.82
2024-10-24 | MFR-12FTF52-5K1 | resistor | https://www.digikey.com/en/products/detail/yageo/MFR-12FTF52-5K1/9134244 | $0.10 | 2 | $0.20
2024-10-24 | 691137710002 | connector | https://www.digikey.com/en/products/detail/w%C3%BCrth-elektronik/691137710002/6644051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 | $0.40 | 1 | $0.40
2024-10-24 | 0685T5000-01 | fuse | https://www.digikey.com/en/products/detail/bel-fuse-inc/0685T5000-01/5466711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 | $0.35 | 3 | $1.05
2024-10-24 | CSD16412Q5A | NMOS | https://www.digikey.com/en/products/detail/texas-instruments/CSD16412Q5A/2038311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 | $1.06 | 2 | $2.12
2024-10-24 | 2N7002K-7 | NMOS | https://www.digikey.com/en/products/detail/diodes-incorporated/2N7002K-7/1934378 | $0.13 | 1 | $0.13
2024-10-24 | KGM21NR71H104KT | capacitor | https://www.digikey.com/en/products/detail/kyocera-avx/KGM21NR71H104KT/563505 | $0.10 | 8 | $0.80
2024-10-24 | 0805ZD225KAT2A | capacitor | https://www.digikey.com/en/products/detail/kyocera-avx/0805ZD225KAT2A/563523 | $0.25 | 1 | $0.25
2024-10-24 | B320A-13-F | Diode | https://www.digikey.com/en/products/detail/diodes-incorporated/B320A-13-F/717692 | $0.33 | 10 | 3.26
2024-10-24 | MMSZ4702T1G | Diode | https://www.digikey.com/en/products/detail/onsemi/MMSZ4702T1G/919735 | $0.07 | 10 | 0.69
 |  |  |  |  |  | 152.03

Sheet: integrated pcb parts list
PART NAME | DESC | LINK | QTY | COST EACH | COST TOTAL | notes
Patrick
CRCW0402100RFKEDC | 100ohm smd | https://www.mouser.com/ProductDetail/Vishay-Dale/CRCW0402100RFKEDC?qs=E3Y5ESvWgWO1aKOdrdIvbA%3D%3D | 20 | $0.10 | $2.00
08055C104KAT2A | 0.1u smd | https://www.mouser.com/ProductDetail/KYOCERA-AVX/08055C104KAT2A?qs=2ujN4bDBNE9mJvapP%252BjopA%3D%3D | 20 | $0.16 | $3.20
MM3Z5V6C | zener diode | https://www.mouser.com/ProductDetail/onsemi-Fairchild/MM3Z5V6C?qs=rXqtSHp76q6mZxise9dftg%3D%3D | 10 | $0.13 | $1.30 | when soldering, side with slant is positive side
RC0603FR-0710KL | 10k smd | https://www.mouser.com/ProductDetail/YAGEO/RC0603FR-0710KL?qs=grNVn54RoB%252B3GtjbJj3wJQ%3D%3D | 10 | $0.10 | $1.00
RC0402FR-0710RL | 10 ohm smd | https://www.mouser.com/ProductDetail/YAGEO/RC0402FR-0710RL | 10 | $0.10 | $1.00
RC0402FR-075K1L | 5.1k smd | https://www.mouser.com/ProductDetail/YAGEO/RC0402FR-075K1L?qs=YUgVZYePFqCSmQuaha43RA%3D%3D | 10 | $0.10 | $1.00
RR1220Q-100-D | 10 ohm smd | https://www.mouser.com/ProductDetail/Susumu/RR1220Q-100-D?qs=U7dmUkNviFtO6MBkyiGCwQ%3D%3D | 10 | $0.10 | $1.00
CRCW040210M0FKED | 10M smd | https://www.mouser.com/ProductDetail/Vishay-Dale/CRCW040210M0FKED?qs=DDCJs2%252BWWG1ECyUd3oQXVw%3D%3D | 10 | $0.10 | $1.00
Cole
CRCW040210k0FKEDHP | 10k smd | https://www.mouser.com/ProductDetail/Vishay-Dale/CRCW040210K0FKEDHP?qs=FlFvgi4rxBxmIiaeyFjrkA%3D%3D | 10 | $0.11 | $1.10
PEC02SAAN | CONN HEADER | https://www.digikey.com/en/products/detail/sullins-connector-solutions/PEC02SAAN/859155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 | 10 | $0.35 | $3.50
Jaein |  |  |  |  |  | $102.14
MSPM0G3507SPMR | MCU | https://www.mouser.com/ProductDetail/Texas-Instruments/MSPM0G3507SPMR?qs=ST9lo4GX8V0tukxOtqK%252B6A%3D%3D | 10 | $1.67 | $16.70
BSS138LT1G | N MOSFET | https://www.mouser.com/ProductDetail/onsemi/BSS138LT1G?qs=vNc2DXHODiKPZ2y3rQhTYQ%3D%3D | 10 | $0.17 | $1.75
CL32A157MQVNNNE | buk cap | https://www.mouser.com/ProductDetail/Samsung-Electro-Mechanics/CL32A157MQVNNNE?qs=o1waKiAPAqeOsXqB2m5tpw%3D%3D | 10 | $0.83 | $8.29
MMSD914T1G | diode | https://www.mouser.com/ProductDetail/onsemi/MMSD914T1G?qs=P4IOph%252Bbot8PMEQIZWg1LQ%3D%3D | 10 | $0.06 | $0.60
GRPB081VWVN-RC | pin header (8) | https://www.digikey.com/en/products/detail/sullins-connector-solutions/GRPB081VWVN-RC/1786444 | 40 | $0.46 | $18.56
TUSB320IRWBR | TUSB320 (USB C port ctrl) | https://www.digikey.com/en/products/detail/texas-instruments/TUSB320IRWBR/5297639 | 10 | $1.63 | $16.34
LTW-420D7 | LED | https://www.digikey.com/en/products/detail/liteon/LTW-420D7/1835514 | 30 | $0.39 | $11.58
61000621121 | pin header (6) | https://www.digikey.com/en/products/detail/w%C3%BCrth-elektronik/61000621121/4846966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 | 10 | $0.80 | $8.02
61001021121 | pin header (10) | https://www.digikey.com/en/products/detail/w%C3%BCrth-elektronik/61001021121/4846968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 | 5 | $1.81 | $9.05
61001221121 | pin header (12) | https://www.digikey.com/en/products/detail/w%C3%BCrth-elektronik/61001221121/4846969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 | 5 | $2.25 | $11.25
Camden
GRM1885C1H272JA01D | Capacitor (2.7 nF) | https://www.mouser.com/ProductDetail/Murata-Electronics/GRM1885C1H272JA01D?qs=%2FEhSLMV8HUQlL5ZggNQk6g%3D%3D | 10 | 0.05 | 0.5
GRM2195C1H752JA01D | Capacitor (7.5 nF) | https://www.mouser.com/ProductDetail/Murata-Electronics/GRM2195C1H752JA01D?qs=3Vu9ppaVHS6q11SGVh%2FV8g%3D%3D | 10 | 0.11 | 1.1
ERJ-6GEYJ474V | Resistor (470k) | https://www.mouser.com/ProductDetail/Panasonic/ERJ-6GEYJ474V?qs=YMBIwoNQYdUCy4oWeQgeIw%3D%3D | 10 | 0.025 | 0.25
RC0805FR-07100KL | Resistor (100k) | https://www.mouser.com/ProductDetail/YAGEO/RC0805FR-07100KL?qs=8Y8p%252BasKcI7rEWn6FcVdAA%3D%3D | 10 | 0.14 | 1.4
RC0603FR-0747KL | Resistor (47k) | https://www.mouser.com/ProductDetail/YAGEO/RC0603FR-0747KL?qs=gt6vzsuosg3jXzmCiDCCdg%3D%3D | 10 | 0.007 | 0.07
RC0805FR-0720K5L | Resistor (20.5k) | https://www.mouser.com/ProductDetail/YAGEO/RC0805FR-0720K5L?qs=QrWOOBGzeCZ%252BXTGCLt8vFg%3D%3D | 10 | 0.012 | 0.12
CRCW0805866RFKEA | Resistor (866) | https://www.mouser.com/ProductDetail/Vishay-Dale/CRCW0805866RFKEA?qs=gFq8Ja42mL5y9BwvIQrGGg%3D%3D | 10 | 0.025 | 0.25
RMCF1210JT10K0 | Resistor (10k) | https://www.mouser.com/ProductDetail/SEI-Stackpole/RMCF1210JT10K0?qs=IPgv5n7u5QZextIiufaxPA%3D%3D | 10 | 0.037 | 0.37
282836-2 | 2 Pin Terminal Block | https://www.mouser.com/ProductDetail/TE-Connectivity/282836-2?qs=A%252Bip%252BNCYi6Ohx9vaQ1l4dg%3D%3D | 6 | 0.432 | 2.592
TPS259460ARPWR | TI eFuse | https://www.mouser.com/ProductDetail/595-TPS259460ARPWR | 6 | 0.921 | 5.526
TMUX1248DCKR | TI MUX | https://www.mouser.com/ProductDetail/Texas-Instruments/TMUX1248DCKR?qs=QNEnbhJQKvba99NaGQ0qVA%3D%3D | 5 | 0.387 | 1.935
1772-1229-ND | Standoffs | https://www.digikey.com/en/products/detail/raf-electronic-hardware/2100-632-AL/7680640 | 10 | 0.173 | 1.73
total |  |  |  |  | $134.08

Sheet: all parts ordered
PART NUMBER
GMK107AB7105KAHT | 2
CC0603KRX7R8BB473 | 10
GRM188D71A106KA73D | 4
CC0603KRX7R8BB104 | 10
GRT188R61E106ME13D | 3
CL21B475KOFNFNE | 3
LTST-C190GKT | 10
ED1202DS | 2
PEC08SAAN | 2
OSTTA034163 | 1
PEC02SAAN | 10
SRP3212-1R0M | 5
WSL2010R0100FEA18 | 4
CRCW040210K0FKEDHP | 10
CRCW0603430RFKEA | 10
RC0603FR-075K23L | 10
RMCF0603FT30K1 | 10
5002 | 10
BQ25622RYKR | 1
P110 | 2
SNT-100-BK-G | 10
Battery Leads Holder | Battery Holder
Samsung 25R 18650 | batteries
BQ28z620 | IC
691210910004 | connector
MFR-25FBF52-100R | resistor
MM3Z5V6C | DIODE
MFR-25FBF52-1M | resistor
NCP21XV103J03RA | thermistor
MRS25000C1002FCT00 | resistor
RC0805JR-0720ML | resistor
PR01000101009JR500 | resistor
MFR-12FTF52-5K1 | resistor
691137710002 | connector
0685T5000-01 | fuse
CSD16412Q5A | NMOS
2N7002K-7 | NMOS
KGM21NR71H104KT | capacitor
0805ZD225KAT2A | capacitor
ERJ-8BWFR010V | sense resistor
MMSZ4692T1G | Zenner Diode
B240A-13-F | Schottky Diode
CC0603KRX7R7BB105 | Capacitor (1 uF)
GRM1885C1H272JA01D | Capacitor (2.7 nF)
GRM2195C1H752JA01D | Capacitor (7.5 nF)
ERJ-6GEYJ474V | Resistor (470k)
RC0805FR-07100KL | Resistor (100k)
RC0603FR-0747KL | Resistor (47k)
RC0805FR-0720K5L | Resistor (20.5k)
CRCW0805866RFKEA | Resistor (866)
CSRT0603FT5R00 | Resistor (5)
RMCF1210JT10K0 | Resistor (10k)
PEC08SAAN | 8 pin Header Pins
282836-2 | 2 Pin Terminal Block
TPS259460ARPWR | TI eFuse
TMUX1248DCKR | TI MUX
USB4125-GF-A-0190 | USB C Port
FSMSM | Push Button
RG2012P-204-B-T5 | Resistor
RT1206BRE07900KL | Resistor
GRMJN65C1H104GE01J | Capacitor
CC0805JKX7R9BB105 | Capacitor
61300311121 | Pin Header (3)
61001221121 | Pin Header (12)
61001021121 | Pin Header (10)
61301421121 | Pin Header (14)
61000621121 | Pin Header (6)
LTW-420D7 | LED (TH)
ERA-6AEB271V | Resistor
ERA-6AEB331V | Resistor
ERA-6AEB472V | Resistor
ERA-6AEB222V | Resistor
ERA-6AEB473V | Resistor
C0805C106J8RACAUTO | Capacitor
C0603C103J5RACTU | Capacitor
C0603C474J4RAC7867 | Capacitor
TUSB320IRWBR | IC - USBC Port Ctrl
CRCW0402100RFKEDC
08055C104KAT2A
RC0603FR-0710KL
RC0402FR-0710RL
RC0402FR-075K1L
RR1220Q-100-D
CRCW040210M0FKED
MSPM0G3507SPMR
BSS138LT1G
CL32A157MQVNNNE
MMSD914T1G
GRPB081VWVN-RC
1772-1229-ND
