jaeinCha/ECEN404-2025SP-TI-Solar-Battery-Pack/Sheets/404 Validation Plan.xlsx

Sheet: 404 Validation Plan
Number | Validation Test | Input | Expected Output | Results | Status | Engineer | Reference Number
1 | PP1 Operational | 4-6V 2.5-3.5A on Vin (PP1) | 4-6V 2.5-3.5A on Vout (PP1) | As expected |  | Camden Pomeroy | 3.2.3.2.2
2 | PP2 Operational | 4-6V 2.5-3.5A in Vin (PP2) | 4-6V 2.5-3.5A on Vout (PP2) | As expected |  | Camden Pomeroy | 3.2.3.2.2
3 | PP1 PG (Good signal) | If Vin > 2V | PG signal is read Low from MCU | As expected |  | Camden Pomeroy | 6.1.1
4 | PP1 PG (Bad signal) | if Vin < 2V | PG signal is read High from MCU | As expected |  | Camden Pomeroy | 6.1.1
5 | PP2 PG (Good signal) | If Vin > 2V | PG signal is read Low from MCU | As expected |  | Camden Pomeroy | 6.1.1
6 | PP2 PG (Bad signal) | if Vin < 2V | PG signal is read High from MCU | As expected |  | Camden Pomeroy | 6.1.1
7 | PP1 UVLO Operational | if Vin < UVLO | No output on VBUS | As expected |  | Camden Pomeroy | 3.2.3.1
8 | PP2 UVLO Operational | if Vin < UVLO | No output on VBUS | As expected |  | Camden Pomeroy | 3.2.3.1
9 | PP1 OVLO Operational | if Vin > OVLO | No output on VBUS | As expected |  | Camden Pomeroy | 3.2.3.1
10 | PP2 OVLO Operational | if Vin > OVLO | No output on VBUS | As expected |  | Camden Pomeroy | 3.2.3.1
11 | SEL USBC | SEL is sent low from MCU | PP1 is active and PP2 is not | As expected |  | Camden Pomeroy | 6.1.4
12 | SEL Solar | SEL is sent high from MCU | PP2 is active and PP1 is not | As expected |  | Camden Pomeroy | 6.1.4
13 | PGTH Threshold | Test Voltage of PGTH | PGTH 3.5V | As expected |  | Camden Pomeroy | 3.2.3.2.2
14 | SOC Display | SOC from 0-100% | 1,2,3,4, or 5 LEDs on as expected | Not tested |  | Jaein Cha | 3.2.3.2.1 | Full system Validation Ideas (need details and to expand upon)
15 | I2C functionality (1:1, EVM) | Run I2C test code | It reads the default register value | As expected |  | Jaein Cha | 6.1 | High Power Path
16 | I2C functionality (1:1, on-board) | Run I2C test code | It reads the default register value | Not tested |  | Jaein Cha | 6.1 | UV Protection
17 | I2C functionality (1:N, EVM) | Run I2C test code | It reads the default register values | As expected |  | Jaein Cha | 6.1 | OV Protection
18 | I2C functionality (1:N, on-board) | Run I2C test code | It reads the default register values | Not tested |  | Jaein Cha | 6.1 | I2C (battery gauge)
19 | I2C - initialization | 3.3V Power supply to the power pin (VCC) | Setup the communication correctly | As expected |  | Jaein Cha | 6.1 | I2C (battery charger
20 | I2C - DFP configuration | DFP plug is connected to the port | Read TUSB I2C address and value, blinks LEDs corresponding to the code for "DFP inserted" | As expected |  | Jaein Cha | 6.1 | Solar Panels Charge Batteries
21 | I2C - UFP configuration | UFP plug is connected to the port | Read TUSB I2C address and value, blinks LEDs corresponding to the code for "UFP inserted" | As expected |  | Jaein Cha | 6.1 | USBC charges Batteries
22 | I2C - DRP configuration | DRP plug is connected to the port | Read TUSB I2C address and value, blinks LEDs corresponding to the code for "UFP inserted" | As expected |  | Jaein Cha | 6.1 | Batteries Discharge and charge Phone through USBC
23 | Reset | Reset button pressed | MCU resets and stop working while the button is pressed | As expected |  | Jaein Cha | 3.2.3.2.1 | Battery Lifespan
24 | MPPT (simulation) | Various voltages | maintain the power as close as 15W | As expected |  | Jaein Cha | 6.2 | SOC Accurate Display
25 | MPPT (on-board) | Various voltages | maintain the power as close as 15W | Not tested |  | Jaein Cha | 6.2 | SOH information
26 | SOP Display | SOP button | Lights up all the LEDs when SOP button is pressed | Not tested |  | Jaein Cha | 3.2.3.2.1
27 | Standard Operation | 5V 3A on VBUS | around 5V 3A on VBUS | 4.2V 3.2A on VBAT |  | Cole Miller | 2.1
28 | USB OTG Function | 4.2V 3.2A on VBAT | around 4.2V 3.2A on VBAT | 5V 1.5A on VBUS |  | Cole Miller | 2.2
29 | ILIM Register Functionality | If input current >1A | output current >1A | Output 1A |  | Cole Miller | 2.3
30 | VLIM Functionality | If Vin > 4.2V | Vo > 4.2V | Output 4.2V |  | Cole Miller | 2.4
31 | Solar Panel VOC | Solar panel Voc < 18V | Solar panel Voc < 18V | As expected |  | Cole Miller | 6.3.1
32 | Battery Charger I2C | Write to registers. Write charge voltage 0x02. Write charge current 0x04. Write input voltage 0x06. Write input current 0x08. Write OTG voltage 0x0A. Write OTG current 0x0C | Read from said registers | As expected |  | Cole Miller | 6.1.2
33 | Solar Panel Power | regular usage in sunny day | output 15W | As expected |  | Cole Miller | 6.3.12
34 | Battery Guage I2C | Write to registers. Read battery temperature 0x6. Read charging voltage 0x8. Read charging current 0xc. Read relative state of charge 0x2c | Read from said registers | As expected |  | Patrick Wang | 6.1.3
35 | Battery Lifespan | Battery connected to load | The lifespan is at least 3 hours | As expected |  | Partick Wang | 3.2.1.2
36 | Power Consumption | Normal Operating Conditions | Maximum power consumption is below 1.5 W | As expected |  | Patrick Wang | 3.2.1.2
37 | Battery SOH | Discharge batteries from 100% to 0% | Batteries stay in within an appropiate range of charge | As expected |  | Patrick Wang | 5.1
38 | High Power Path Charge | 5V 3A from power MUX | Charges Battery Pack | As expected |  | Patrick, Cole, Camden | 3.2.3.2.2
39 | High Power Path Discharge | Load Connected to USBC | Battery Pack Discharges 15W | As expected |  | Patrick , Cole, Camden | 3.2.3.2.2
40 | USBC Charging | USBC plug from wall outlet | Battery Pack Charges | As expected |  | Patrick Wang | 6.2.1
41
42
43
44
45
46

Sheet: 403 Validation Plan
Number | Validation Test: | Input: | Expected Output: | Results | Status | Engineer
1 | PP1 Operational | 4-6V 2.5-3.5A on Vin (PP1) | 4-6V 2.5-3.5A on Vout (PP1) | 4.5V of Vout when input was 5V |  | Camden Pomeroy
2 | PP2 Operational | 4-6V 2.5-3.5A in Vin (PP2) | 4-6V 2.5-3.5A on Vout (PP2) | As expected |  | Camden Pomeroy
3 | PP1 PG (Good signal) | If Vin > 2V | PG signal is Low | As expected |  | Camden Pomeroy
4 | PP1 PG (Bad signal) | if Vin < 2V | PG signal is High | As expected |  | Camden Pomeroy
5 | PP2 PG (Good signal) | If Vin > 2V | PG signal is High | As expected |  | Camden Pomeroy
6 | PP2 PG (Bad signal) | if Vin < 2V | PG signal is Low | As expected |  | Camden Pomeroy
7 | PP1 UVLO Operational | if Vin < UVLO | No output | As expected |  | Camden Pomeroy
8 | PP2 UVLO Operational | if Vin < UVLO | No output | As expected |  | Camden Pomeroy
9 | PP1 OVLO Operational | if Vin > OVLO | No output | As expected |  | Camden Pomeroy
10 | PP2 OVLO Operational | if Vin > OVLO | No output | As expected |  | Camden Pomeroy
11 | SEL PP1 | SEL is high | PP1 is active and PP2 is not | Sel pin would not properly switch |  | Camden Pomeroy
12 | SEL PP2 | SEL is low | PP2 is active and PP1 is not | Sel pin would not properly switch |  | Camden Pomeroy
13 | ILM durning startup | Inrush current of 4A | Limited current (<4 A) to ramp up | Could not get DC load to operate |  | Camden Pomeroy
14 | Seperate Power Paths | S1 active and both Vins 5V | Only PP1 Vout = 5V | As expected |  | Camden Pomeroy
15 | Seperate Power Paths | S2 active and both Vins 5V | Only PP2 Vout = 5V | As expected |  | Camden Pomeroy
16 | PGTH Threshold | Test Voltage of PGTH | PGTH 3.5V | As expected |  | Camden Pomeroy
Number | Validation Test: | Input: | Expected Output: | Results | Status | Engineer
1 | Powered IC - 5V 3A | 5V 3A | 5V 3A | As expected |  | Patrick Wang
2 | IC valid I2C connection | IC connected to EV2400 | IC communicates with bqstudio | As expected |  | Patrick Wang
3 | accurate voltage measurements in bqstudio | 3V to 5V | 3V to 5V | As expected |  | Patrick Wang
4 | accurate battery capacity and charge level measurements | plugged into 100% power source | 100% | As expected |  | Patrick Wang
5 | accurate temperature sensing measurements | 21.8 degrees C | 21.8 degrees C | As expected |  | Patrick Wang
6 | IC is on latest firmware update | IC flashed to latest firmware | IC updated | As expected |  | Patrick Wang
7 | IC BAT+ charging voltage of 3.7V | 3.7V into BAT+ | 3.7V into VC2 | As expected |  | Patrick Wang
8 | IC PACK+ input voltage 3.5 to 5.5V | CHG and DSG match Vin | CHG and DSG match Vin | they match indicating FETs open |  | Patrick Wang
9 | IC PACK+ input voltage outside of range of 3.5 to 5.5V | CHG and DSG should be 0 | CHG and DSG match Vin | to indicate FETs off |  | Patrick Wang
10 | IC PACK+ Vin powers IC at same voltage | 3V to 5V | 3V to 5V | As expected |  | Patrick Wang
Number | Validation Test: | Input: | Expected Output: | Results | Status | Engineer
1 | Continuity test - before soldering | Continuity test using DMM | Beep (connected) for same nets, no sound otherwise | As expected |  | Jaein Cha
2 | Continuity test - after soldering | Continuity test using DMM | Beep (connected) for same nets, no sound otherwise | As expected |  | Jaein Cha
3 | Voltage/current test (MCU) | 3.3V to the power pin (VCC) | 3.3V from the source GPIO pins | As expected (from SCL pin) |  | Jaein Cha
4 | Voltage/current test (TUSB) | 3.3V to the power pin (VCC) | 3.3V from the source GPIO pins | As expected (from ID pin) |  | Jaein Cha
5 | I2C - voltage level | 3.3V to the power pin (VCC) | Same voltage of 3.3V for both ends of I2C bus | As expected |  | Jaein Cha
6 | I2C - initialization | 3.3V Power supply to the power pin (VCC) | Read TUSB I2C address | TUSB unresponsive |  | Jaein Cha
7 | I2C - receive (DFP connected) | DFP plug is connected to the port | Read TUSB I2C address and value, blinks LEDs corresponding to the code for "DFP inserted" | TUSB unresponsive |  | Jaein Cha
8 | I2C - receive (UFP connected) | UFP plug is connected to the port | Read TUSB I2C address and value, blinks LEDs corresponding to the code for "UFP inserted" | TUSB unresponsive |  | Jaein Cha
9 | I2C - receive (DRP connected) | DRP plug is connected to the port | Read TUSB I2C address and value, blinks LEDs corresponding to the code for "UFP inserted" | TUSB unresponsive |  | Jaein Cha
10 | Reset | Reset button pressed | MCU resets and stop working while the button is pressed | Yes on LP, not on custom board |  | Jaein Cha
11 | SOP Display | SOP button | Lights up all the LEDs when SOP button is pressed | Yes on LP, not on custom board |  | Jaein Cha
Number | Validation Test: | Input: | Excpeted Output: | Results | Status | Engineer
1 | Standard Operation | 5V 3A on VBUS | around 5V 3A on VBUS | 4.2V 3.2A on VBAT |  | Cole Miller
2 | USB OTG Function | 4.2V 3.2A on VBAT | around 4.2V 3.2A on VBAT | 5V 1.5A on VBUS |  | Cole Miller
3 | ILIM Register Functionality | If input current >1A | output current >1A | Output 1A |  | Cole Miller
4 | VLIM Functionality | If Vin > 4.2V | Vo > 4.2V | Output 4.2V |  | Cole Miller
5 | PG Pin Functionality | Good input | Low signal | Low signal |  | Cole Miller
6 | STAT Pin Functionality | Charging | Low signal | Low signal |  | Cole Miller
7 | STAT Pin Functionality | Not Charging | High | High |  | Cole Miller
8 | System Overvoltage Protection | Vin > Vsys_op | Vin > Vsys_op | Vsys_fault_flag = 1 |  | Cole Miller
9 | ILIM Hardware Functionality | Input current > 3A | Input current > 3A | Output current = 3A |  | Cole Miller
10 | IC valid I2C connection | IC connected to EV2400 | IC communicates with bqstudio | doesn't communicate |  | Cole Miller
11 | Solar Panel VOC | Solar panel Voc < 18V | Solar panel Voc < 18V | As expected |  | Cole Miller
12 | Solar Panel Power | regular usage in sunny day | output 15W | As expected |  | Cole Miller
13 | ILIM Pin Disable | Able to disable automatic current limit using register | Able to disable automatic current limit using register | doesn't disable |  | Cole Miller
14 | Switching Speed | 1.5 MHz on SWS pin | 1.5 MHz on SWS pin | 1.5 MHz on SWS pin |  | Cole Miller
