jaeinCha/ECEN404-2025SP-TI-Solar-Battery-Pack/Pictures & Videos/MCU Firmware Flowchart.pdf

# MCU Firmware Flow Chart

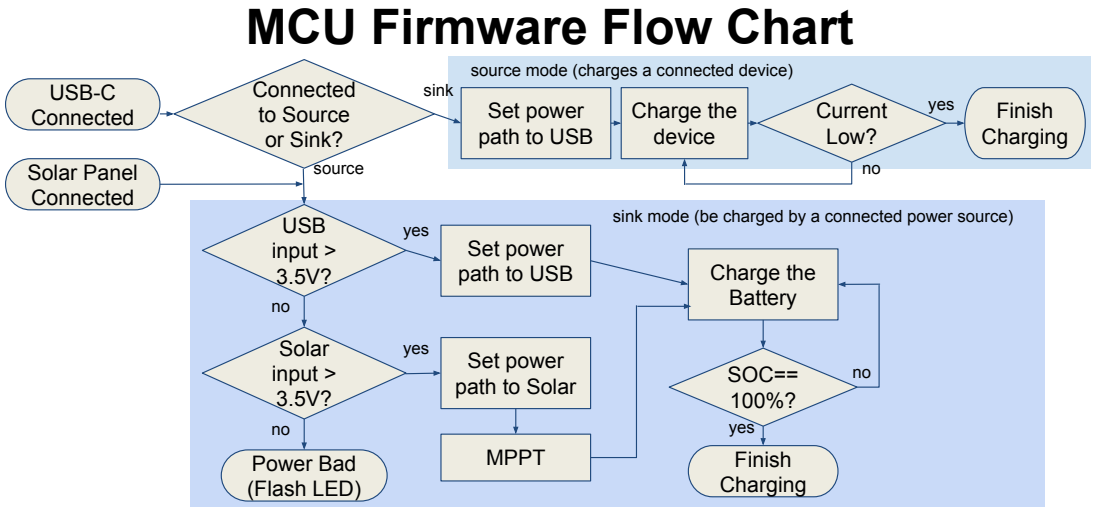
[picture p145: page 1]
USB-C Connected; Solar Panel Connected; Connected to Source or Sink?; Charge the device; source; USB input > 3.5V?; Solar input > 3.5V?; yes; Current Low?; Finish Charging; Set power; Power Bad (Flash LED); Charge the Battery; MPPT; SOC== 100%?

source mode (charges a connected device)
sink

Set power
path to USB

sink mode (be charged by a connected power source)

yes
path to Solar

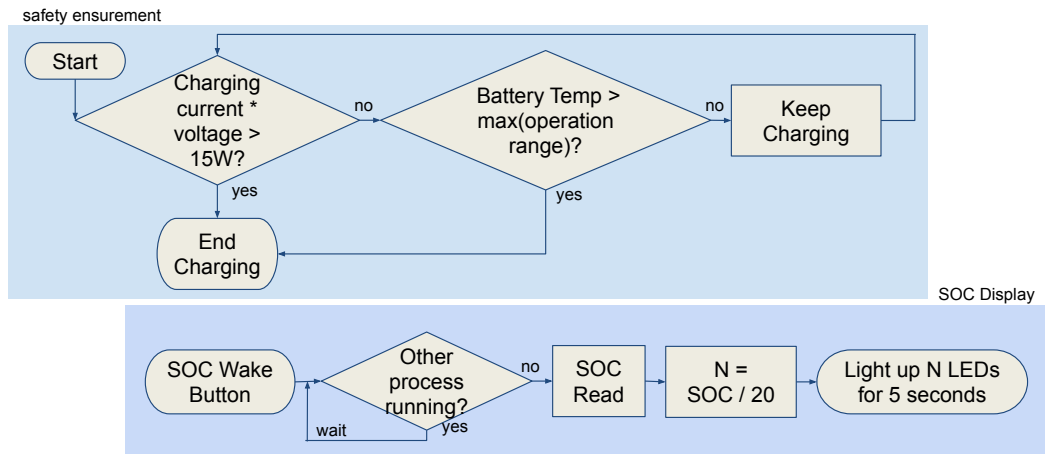
[picture p146: page 2]
Charging current * voltage > 15W?; safety ensurement; SOC Display; Battery Temp > max(operation range)?; End Charging; Keep Charging; yes; Other process running?; SOC Wake Button; SOC Read; N = SOC / 20; wait; Start

Light up N LEDs
for 5 seconds
