jaeinCha/ECEN404-2025SP-TI-Solar-Battery-Pack/(list of files, drawings)

Other design files:
Altium Schematic & Layouts/MCU/final schematic.SchDoc
Altium Schematic & Layouts/MCU/MCU Schematic.SchDoc
Altium Schematic & Layouts/MCU/TUSB320 Schematic.SchDoc
Altium Schematic & Layouts/MCU/Updated MCU PCB.PcbDoc
